Raven1911/ASIC-Oriented-RISC-V-AI-SoC-Platform/Beta_AISoC_Firmware/software_golden_model_rps/assets/hcmut_cropped.png

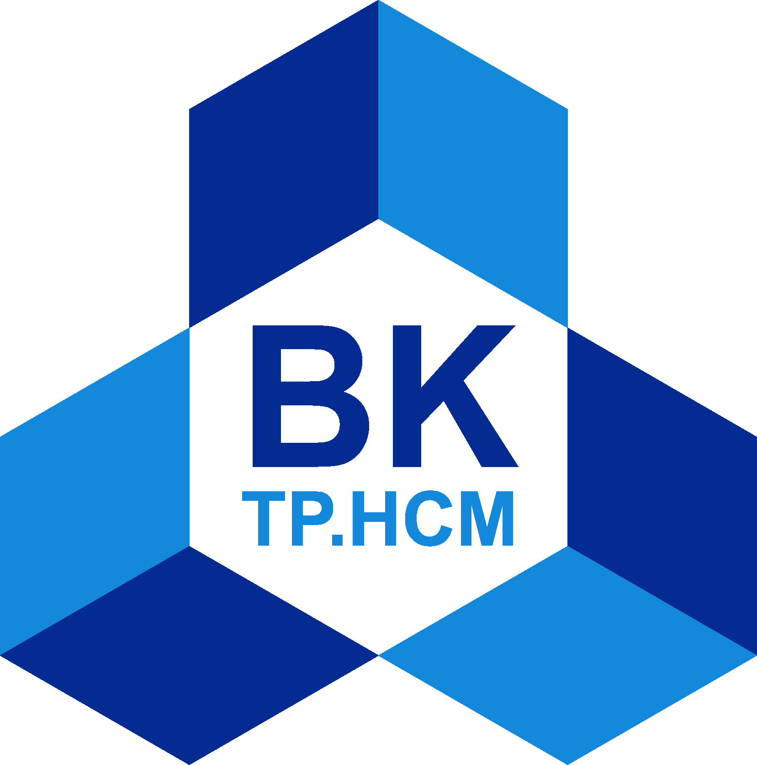
Beta_AISoC_Firmware/software_golden_model_rps/assets/hcmut_cropped.png
