Raven1911/ASIC-Oriented-RISC-V-AI-SoC-Platform/Beta_AISoC.srcs/constrs_1/imports/digilent-xdc/VC707_rev_2.0.ucf.xdc

# # set_property PACKAGE_PIN AR35 [get_ports GPIO_LED_4_LS]
# # set_property IOSTANDARD LVCMOS18 [get_ports GPIO_LED_4_LS]
# # #NET  3N787                     LOC = AY34 | IOSTANDARD=LVCMOS18; # Bank  13 VCCO - VCC1V8_FPGA - IO_L1P_T0_13
# # set_property PACKAGE_PIN BA35 [get_ports USB_SMSC_NXT]
# # set_property IOSTANDARD LVCMOS18 [get_ports USB_SMSC_NXT]
# # set_property PACKAGE_PIN AV36 [get_ports USB_SMSC_DATA0]
# # set_property IOSTANDARD LVCMOS18 [get_ports USB_SMSC_DATA0]
# # set_property PACKAGE_PIN AW36 [get_ports USB_SMSC_DATA1]
# # set_property IOSTANDARD LVCMOS18 [get_ports USB_SMSC_DATA1]
# # set_property PACKAGE_PIN BA34 [get_ports USB_SMSC_DATA2]
# # set_property IOSTANDARD LVCMOS18 [get_ports USB_SMSC_DATA2]
# # set_property PACKAGE_PIN BB34 [get_ports USB_SMSC_DATA3]
# # set_property IOSTANDARD LVCMOS18 [get_ports USB_SMSC_DATA3]
# # set_property PACKAGE_PIN BA36 [get_ports USB_SMSC_DATA4]
# # set_property IOSTANDARD LVCMOS18 [get_ports USB_SMSC_DATA4]
# # set_property PACKAGE_PIN BB36 [get_ports USB_SMSC_RESET_B]
# # set_property IOSTANDARD LVCMOS18 [get_ports USB_SMSC_RESET_B]
# # set_property PACKAGE_PIN BB32 [get_ports USB_SMSC_STP]
# # set_property IOSTANDARD LVCMOS18 [get_ports USB_SMSC_STP]
# # set_property PACKAGE_PIN BB33 [get_ports USB_SMSC_DIR]
# # set_property IOSTANDARD LVCMOS18 [get_ports USB_SMSC_DIR]
# # set_property PACKAGE_PIN AW35 [get_ports USB_SMSC_DATA7]
# # set_property IOSTANDARD LVCMOS18 [get_ports USB_SMSC_DATA7]
# # set_property PACKAGE_PIN AY35 [get_ports USB_SMSC_DATA6]
# # set_property IOSTANDARD LVCMOS18 [get_ports USB_SMSC_DATA6]
# # set_property PACKAGE_PIN AT34 [get_ports USB_SMSC_DATA5]
# # set_property IOSTANDARD LVCMOS18 [get_ports USB_SMSC_DATA5]
# # set_property PACKAGE_PIN AU34 [get_ports SI5324_INT_ALM_LS]
# # set_property IOSTANDARD LVCMOS18 [get_ports SI5324_INT_ALM_LS]
# # set_property PACKAGE_PIN AT36 [get_ports SI5324_RST_LS]
# # set_property IOSTANDARD LVCMOS18 [get_ports SI5324_RST_LS]
# # set_property PACKAGE_PIN AU36 [get_ports USB_UART_RX]
# # set_property IOSTANDARD LVCMOS18 [get_ports USB_UART_RX]
# # set_property PACKAGE_PIN AT32 [get_ports USB_UART_RTS]
# # set_property IOSTANDARD LVCMOS18 [get_ports USB_UART_RTS]
# # set_property PACKAGE_PIN AU33 [get_ports USB_UART_TX]
# # set_property IOSTANDARD LVCMOS18 [get_ports USB_UART_TX]
# # set_property PACKAGE_PIN AR34 [get_ports USB_UART_CTS]
# # set_property IOSTANDARD LVCMOS18 [get_ports USB_UART_CTS]
# # set_property PACKAGE_PIN AT35 [get_ports IIC_SCL_MAIN_LS]
# # set_property IOSTANDARD LVCMOS18 [get_ports IIC_SCL_MAIN_LS]
# # set_property PACKAGE_PIN AU32 [get_ports IIC_SDA_MAIN_LS]
# # set_property IOSTANDARD LVCMOS18 [get_ports IIC_SDA_MAIN_LS]
# # set_property PACKAGE_PIN AV33 [get_ports PCIE_WAKE_B_LS]
# # set_property IOSTANDARD LVCMOS18 [get_ports PCIE_WAKE_B_LS]
# # set_property PACKAGE_PIN AW32 [get_ports REC_CLOCK_C_P]
# # set_property IOSTANDARD LVCMOS18 [get_ports REC_CLOCK_C_P]
# # set_property PACKAGE_PIN AW33 [get_ports REC_CLOCK_C_N]
# # set_property IOSTANDARD LVCMOS18 [get_ports REC_CLOCK_C_N]
# # set_property PACKAGE_PIN AV34 [get_ports USB_SMSC_REFCLK_OPTION]
# # set_property IOSTANDARD LVCMOS18 [get_ports USB_SMSC_REFCLK_OPTION]
# # set_property PACKAGE_PIN AV35 [get_ports PCIE_PERST_LS]
# # set_property IOSTANDARD LVCMOS18 [get_ports PCIE_PERST_LS]
# # set_property PACKAGE_PIN AY32 [get_ports USB_SMSC_CLKOUT]
# # set_property IOSTANDARD LVCMOS18 [get_ports USB_SMSC_CLKOUT]

# ####################################################################################################
# ############################################ DIP SWITCHES ##########################################
# ####################################################################################################
# set_property -dict { PACKAGE_PIN AV30 IOSTANDARD LVCMOS18 } [get_ports { resetn }]; # DIP switch 0
# # set_property -dict { PACKAGE_PIN AY33 IOSTANDARD LVCMOS18 } [get_ports { pb[0] }]; # DIP switch 1
# # set_property -dict { PACKAGE_PIN BA31 IOSTANDARD LVCMOS18 } [get_ports { pb[1] }]; # DIP switch 2
# # set_property -dict { PACKAGE_PIN BA32 IOSTANDARD LVCMOS18 } [get_ports { pb[2] }]; # DIP switch 3
# # set_property -dict { PACKAGE_PIN AW30 IOSTANDARD LVCMOS18 } [get_ports { pb[3] }]; # DIP switch 4
# # set_property -dict { PACKAGE_PIN AY30 IOSTANDARD LVCMOS18 } [get_ports { pb[4] }]; # DIP switch 5
# # set_property -dict { PACKAGE_PIN BA30 IOSTANDARD LVCMOS18 } [get_ports { pb[5] }]; # DIP switch 6
# # set_property -dict { PACKAGE_PIN BB31 IOSTANDARD LVCMOS18 } [get_ports { sw_enb_i }]; # DIP switch 7

# # set_property PACKAGE_PIN AY33 [get_ports GPIO_DIP_SW1]
# # set_property IOSTANDARD LVCMOS18 [get_ports GPIO_DIP_SW1]
# # set_property PACKAGE_PIN BA31 [get_ports GPIO_DIP_SW2]
# # set_property IOSTANDARD LVCMOS18 [get_ports GPIO_DIP_SW2]
# # set_property PACKAGE_PIN BA32 [get_ports GPIO_DIP_SW3]
# # set_property IOSTANDARD LVCMOS18 [get_ports GPIO_DIP_SW3]
# # set_property PACKAGE_PIN AW30 [get_ports GPIO_DIP_SW4]
# # set_property IOSTANDARD LVCMOS18 [get_ports GPIO_DIP_SW4]
# # set_property PACKAGE_PIN AY30 [get_ports GPIO_DIP_SW5]
# # set_property IOSTANDARD LVCMOS18 [get_ports GPIO_DIP_SW5]
# # set_property PACKAGE_PIN BA30 [get_ports GPIO_DIP_SW6]
# # set_property IOSTANDARD LVCMOS18 [get_ports GPIO_DIP_SW6]
# # set_property PACKAGE_PIN BB31 [get_ports GPIO_DIP_SW7]
# # set_property IOSTANDARD LVCMOS18 [get_ports GPIO_DIP_SW7]
# # set_property PACKAGE_PIN AV30 [get_ports GPIO_DIP_SW0]
# # set_property IOSTANDARD LVCMOS18 [get_ports GPIO_DIP_SW0]

# ####################################################################################################
# ############################################              ##########################################
# ####################################################################################################

# # set_property PACKAGE_PIN AW31 [get_ports ROTARY_PUSH]
# # set_property IOSTANDARD LVCMOS18 [get_ports ROTARY_PUSH]
# # set_property PACKAGE_PIN AR30 [get_ports SDIO_DAT0_LS]
# # set_property IOSTANDARD LVCMOS18 [get_ports SDIO_DAT0_LS]
# # set_property PACKAGE_PIN AT30 [get_ports SDIO_CD_DAT3_LS]
# # set_property IOSTANDARD LVCMOS18 [get_ports SDIO_CD_DAT3_LS]
# # set_property PACKAGE_PIN AU31 [get_ports SDIO_DAT1_LS]
# # set_property IOSTANDARD LVCMOS18 [get_ports SDIO_DAT1_LS]
# # set_property PACKAGE_PIN AV31 [get_ports SDIO_DAT2_LS]
# # set_property IOSTANDARD LVCMOS18 [get_ports SDIO_DAT2_LS]
# # set_property PACKAGE_PIN AN30 [get_ports SDIO_CLK_LS]
# # set_property IOSTANDARD LVCMOS18 [get_ports SDIO_CLK_LS]
# # set_property PACKAGE_PIN AP30 [get_ports SDIO_CMD_LS]
# # set_property IOSTANDARD LVCMOS18 [get_ports SDIO_CMD_LS]
# # set_property PACKAGE_PIN AP32 [get_ports SDIO_SDDET]
# # set_property IOSTANDARD LVCMOS18 [get_ports SDIO_SDDET]
# # set_property PACKAGE_PIN AR32 [get_ports SDIO_SDWP]
# # set_property IOSTANDARD LVCMOS18 [get_ports SDIO_SDWP]
# # set_property PACKAGE_PIN AN31 [get_ports USER_SMA_GPIO_P]
# # set_property IOSTANDARD LVCMOS18 [get_ports USER_SMA_GPIO_P]
# # set_property PACKAGE_PIN AP31 [get_ports USER_SMA_GPIO_N]
# # set_property IOSTANDARD LVCMOS18 [get_ports USER_SMA_GPIO_N]
# # set_property PACKAGE_PIN AP33 [get_ports SFP_TX_DISABLE]
# # set_property IOSTANDARD LVCMOS18 [get_ports SFP_TX_DISABLE]
# # set_property PACKAGE_PIN AR33 [get_ports ROTARY_INCA]
# # set_property IOSTANDARD LVCMOS18 [get_ports ROTARY_INCA]
# # set_property PACKAGE_PIN AT31 [get_ports ROTARY_INCB]
# # set_property IOSTANDARD LVCMOS18 [get_ports ROTARY_INCB]
# # set_property PACKAGE_PIN AH35 [get_ports FMC_VADJ_ON_B_LS]
# # set_property IOSTANDARD LVCMOS18 [get_ports FMC_VADJ_ON_B_LS]
# # set_property PACKAGE_PIN AM36 [get_ports FLASH_D0]
# # set_property IOSTANDARD LVCMOS18 [get_ports FLASH_D0]
# # set_property PACKAGE_PIN AN36 [get_ports FLASH_D1]
# # set_property IOSTANDARD LVCMOS18 [get_ports FLASH_D1]
# # set_property PACKAGE_PIN AJ36 [get_ports FLASH_D2]
# # set_property IOSTANDARD LVCMOS18 [get_ports FLASH_D2]
# # set_property PACKAGE_PIN AJ37 [get_ports FLASH_D3]
# # set_property IOSTANDARD LVCMOS18 [get_ports FLASH_D3]
# # #NET  4N749                     LOC = AP36 | IOSTANDARD=LVCMOS18; # Bank  14 VCCO - VCC1V8_FPGA - IO_L3P_T0_DQS_PUDC_B_14
# # set_property PACKAGE_PIN AP37 [get_ports FPGA_EMCCLK]
# # set_property IOSTANDARD LVCMOS18 [get_ports FPGA_EMCCLK]
# # set_property PACKAGE_PIN AK37 [get_ports FLASH_D4]
# # set_property IOSTANDARD LVCMOS18 [get_ports FLASH_D4]
# # set_property PACKAGE_PIN AL37 [get_ports FLASH_D5]
# # set_property IOSTANDARD LVCMOS18 [get_ports FLASH_D5]
# # set_property PACKAGE_PIN AN35 [get_ports FLASH_D6]
# # set_property IOSTANDARD LVCMOS18 [get_ports FLASH_D6]
# # set_property PACKAGE_PIN AP35 [get_ports FLASH_D7]
# # set_property IOSTANDARD LVCMOS18 [get_ports FLASH_D7]
# # set_property PACKAGE_PIN AL36 [get_ports FLASH_CE_B]
# # set_property IOSTANDARD LVCMOS18 [get_ports FLASH_CE_B]
# # set_property PACKAGE_PIN AM37 [get_ports FLASH_D8]
# # set_property IOSTANDARD LVCMOS18 [get_ports FLASH_D8]
# # set_property PACKAGE_PIN AG33 [get_ports FLASH_D9]
# # set_property IOSTANDARD LVCMOS18 [get_ports FLASH_D9]
# # set_property PACKAGE_PIN AH33 [get_ports FLASH_D10]
# # set_property IOSTANDARD LVCMOS18 [get_ports FLASH_D10]
# # set_property PACKAGE_PIN AK35 [get_ports FLASH_D11]
# # set_property IOSTANDARD LVCMOS18 [get_ports FLASH_D11]
# # set_property PACKAGE_PIN AL35 [get_ports FLASH_D12]
# # set_property IOSTANDARD LVCMOS18 [get_ports FLASH_D12]
# # set_property PACKAGE_PIN AH31 [get_ports PHY_MDC_LS]
# # set_property IOSTANDARD LVCMOS18 [get_ports PHY_MDC_LS]
# # set_property PACKAGE_PIN AJ31 [get_ports FLASH_D13]
# # set_property IOSTANDARD LVCMOS18 [get_ports FLASH_D13]
# # set_property PACKAGE_PIN AH34 [get_ports FLASH_D14]
# # set_property IOSTANDARD LVCMOS18 [get_ports FLASH_D14]
# # set_property PACKAGE_PIN AJ35 [get_ports FLASH_D15]
# # set_property IOSTANDARD LVCMOS18 [get_ports FLASH_D15]
# # set_property PACKAGE_PIN AJ33 [get_ports PHY_RESET_LS]
# # set_property IOSTANDARD LVCMOS18 [get_ports PHY_RESET_LS]
# # set_property PACKAGE_PIN AK33 [get_ports PHY_MDIO_LS]
# # set_property IOSTANDARD LVCMOS18 [get_ports PHY_MDIO_LS]
# # set_property PACKAGE_PIN AK34 [get_ports USER_CLOCK_P]
# # set_property IOSTANDARD LVDS [get_ports USER_CLOCK_P]
# # set_property PACKAGE_PIN AL34 [get_ports USER_CLOCK_N]
# # set_property IOSTANDARD LVDS [get_ports USER_CLOCK_N]
# # set_property PACKAGE_PIN AJ32 [get_ports USER_SMA_CLOCK_P]
# # set_property IOSTANDARD LVCMOS18 [get_ports USER_SMA_CLOCK_P]
# # set_property PACKAGE_PIN AK32 [get_ports USER_SMA_CLOCK_N]
# # set_property IOSTANDARD LVCMOS18 [get_ports USER_SMA_CLOCK_N]
# # set_property PACKAGE_PIN AL31 [get_ports PHY_INT_LS]
# # set_property IOSTANDARD LVCMOS18 [get_ports PHY_INT_LS]
# # set_property PACKAGE_PIN AL32 [get_ports FMC_C2M_PG_LS]
# # set_property IOSTANDARD LVCMOS18 [get_ports FMC_C2M_PG_LS]
# # set_property PACKAGE_PIN AM34 [get_ports FLASH_WAIT]
# # set_property IOSTANDARD LVCMOS18 [get_ports FLASH_WAIT]
# # set_property PACKAGE_PIN AN34 [get_ports FMC1_HPC_PG_M2C_LS]
# # set_property IOSTANDARD LVCMOS18 [get_ports FMC1_HPC_PG_M2C_LS]
# # set_property PACKAGE_PIN AM31 [get_ports FMC1_HPC_PRSNT_M2C_B_LS]
# # set_property IOSTANDARD LVCMOS18 [get_ports FMC1_HPC_PRSNT_M2C_B_LS]
# # set_property PACKAGE_PIN AM32 [get_ports FLASH_A15]
# # set_property IOSTANDARD LVCMOS18 [get_ports FLASH_A15]
# # set_property PACKAGE_PIN AM33 [get_ports FLASH_A14]
# # set_property IOSTANDARD LVCMOS18 [get_ports FLASH_A14]
# # set_property PACKAGE_PIN AN33 [get_ports FLASH_A13]
# # set_property IOSTANDARD LVCMOS18 [get_ports FLASH_A13]
# # set_property PACKAGE_PIN AL29 [get_ports FLASH_A12]
# # set_property IOSTANDARD LVCMOS18 [get_ports FLASH_A12]
# # set_property PACKAGE_PIN AL30 [get_ports FLASH_A11]
# # set_property IOSTANDARD LVCMOS18 [get_ports FLASH_A11]
# # set_property PACKAGE_PIN AH29 [get_ports FLASH_A10]
# # set_property IOSTANDARD LVCMOS18 [get_ports FLASH_A10]
# # set_property PACKAGE_PIN AH30 [get_ports FLASH_A9]
# # set_property IOSTANDARD LVCMOS18 [get_ports FLASH_A9]
# # set_property PACKAGE_PIN AJ30 [get_ports FLASH_A8]
# # set_property IOSTANDARD LVCMOS18 [get_ports FLASH_A8]
# # set_property PACKAGE_PIN AK30 [get_ports FLASH_A7]
# # set_property IOSTANDARD LVCMOS18 [get_ports FLASH_A7]
# # set_property PACKAGE_PIN AF29 [get_ports FMC2_HPC_PG_M2C_LS]
# # set_property IOSTANDARD LVCMOS18 [get_ports FMC2_HPC_PG_M2C_LS]
# # set_property PACKAGE_PIN AG29 [get_ports FLASH_A6]
# # set_property IOSTANDARD LVCMOS18 [get_ports FLASH_A6]
# # set_property PACKAGE_PIN AK28 [get_ports FLASH_A5]
# # set_property IOSTANDARD LVCMOS18 [get_ports FLASH_A5]
# # set_property PACKAGE_PIN AK29 [get_ports FLASH_A4]
# # set_property IOSTANDARD LVCMOS18 [get_ports FLASH_A4]
# # set_property PACKAGE_PIN AF30 [get_ports FLASH_A3]
# # set_property IOSTANDARD LVCMOS18 [get_ports FLASH_A3]
# # set_property PACKAGE_PIN AG31 [get_ports FLASH_A2]
# # set_property IOSTANDARD LVCMOS18 [get_ports FLASH_A2]
# # set_property PACKAGE_PIN AH28 [get_ports FLASH_A1]
# # set_property IOSTANDARD LVCMOS18 [get_ports FLASH_A1]
# # set_property PACKAGE_PIN AJ28 [get_ports FLASH_A0]
# # set_property IOSTANDARD LVCMOS18 [get_ports FLASH_A0]
# # set_property PACKAGE_PIN AG32 [get_ports FMC2_HPC_PRSNT_M2C_B_LS]
# # set_property IOSTANDARD LVCMOS18 [get_ports FMC2_HPC_PRSNT_M2C_B_LS]
# # #NET  VRN_15                    LOC = AM38 | IOSTANDARD=LVCMOS18; # Bank  15 VCCO - VCC1V8_FPGA - IO_0_VRN_15
# # set_property PACKAGE_PIN AN38 [get_ports XADC_VAUX0P_R]
# # set_property IOSTANDARD LVCMOS18 [get_ports XADC_VAUX0P_R]
# # set_property PACKAGE_PIN AP38 [get_ports XADC_VAUX0N_R]
# # set_property IOSTANDARD LVCMOS18 [get_ports XADC_VAUX0N_R]
# # set_property PACKAGE_PIN AM41 [get_ports XADC_VAUX8P_R]
# # set_property IOSTANDARD LVCMOS18 [get_ports XADC_VAUX8P_R]
# # set_property PACKAGE_PIN AM42 [get_ports XADC_VAUX8N_R]
# # set_property IOSTANDARD LVCMOS18 [get_ports XADC_VAUX8N_R]
# # set_property PACKAGE_PIN AR38 [get_ports LCD_DB5_LS]
# # set_property IOSTANDARD LVCMOS18 [get_ports LCD_DB5_LS]
# # set_property PACKAGE_PIN AR39 [get_ports LCD_DB6_LS]
# # set_property IOSTANDARD LVCMOS18 [get_ports LCD_DB6_LS]
# # set_property PACKAGE_PIN AN40 [get_ports LCD_DB7_LS]
# # set_property IOSTANDARD LVCMOS18 [get_ports LCD_DB7_LS]
# # set_property PACKAGE_PIN AN41 [get_ports LCD_RS_LS]
# # set_property IOSTANDARD LVCMOS18 [get_ports LCD_RS_LS]

# #######################################################################################################
# ############################################ LEDS & SWITCHES ##########################################
# #######################################################################################################

# set_property -dict { PACKAGE_PIN AM39 IOSTANDARD LVCMOS18 } [get_ports { trap0 }]; # LED 0
# set_property -dict { PACKAGE_PIN AN39 IOSTANDARD LVCMOS18 } [get_ports { trap1 }]; # LED 1
# # set_property -dict { PACKAGE_PIN AR37 IOSTANDARD LVCMOS18 } [get_ports { adv7511_clk }]; # LED 2
# # set_property -dict { PACKAGE_PIN AT37 IOSTANDARD LVCMOS18 } [get_ports { adv7511_de }]; # LED 3
# # set_property -dict { PACKAGE_PIN AP41 IOSTANDARD LVCMOS18 } [get_ports { GPIO_LED_5_LS }]; # LED 5
# # set_property -dict { PACKAGE_PIN AP42 IOSTANDARD LVCMOS18 } [get_ports { READY }]; # LED 6
# # set_property -dict { PACKAGE_PIN AP40 IOSTANDARD LVCMOS18 } [get_ports { GPIO_SW_S }];     # Push Switch South
# # set_property -dict { PACKAGE_PIN AR40 IOSTANDARD LVCMOS18 } [get_ports { GPIO_SW_N }];     # Push Switch North

# # set_property PACKAGE_PIN AR37 [get_ports GPIO_LED_2_LS]
# # set_property IOSTANDARD LVCMOS18 [get_ports GPIO_LED_2_LS]
# # set_property PACKAGE_PIN AT37 [get_ports GPIO_LED_3_LS]
# # set_property IOSTANDARD LVCMOS18 [get_ports GPIO_LED_3_LS]
# # set_property PACKAGE_PIN AM39 [get_ports GPIO_LED_0_LS]
# # set_property IOSTANDARD LVCMOS18 [get_ports GPIO_LED_0_LS]
# # set_property PACKAGE_PIN AN39 [get_ports GPIO_LED_1_LS]
# # set_property IOSTANDARD LVCMOS18 [get_ports GPIO_LED_1_LS]
# # set_property PACKAGE_PIN AP40 [get_ports GPIO_SW_S]
# # set_property IOSTANDARD LVCMOS18 [get_ports GPIO_SW_S]
# # set_property PACKAGE_PIN AR40 [get_ports GPIO_SW_N]
# # set_property IOSTANDARD LVCMOS18 [get_ports GPIO_SW_N]
# # set_property PACKAGE_PIN AP41 [get_ports GPIO_LED_5_LS]
# # set_property IOSTANDARD LVCMOS18 [get_ports GPIO_LED_5_LS]
# # set_property PACKAGE_PIN AP42 [get_ports GPIO_LED_6_LS]
# # set_property IOSTANDARD LVCMOS18 [get_ports GPIO_LED_6_LS]

# #######################################################################################################
# ############################################ ##########################################################
# #######################################################################################################


# # #NET  4N920                     LOC = AT39 | IOSTANDARD=LVCMOS18; # Bank  15 VCCO - VCC1V8_FPGA - IO_L9P_T1_DQS_AD3P_15
# # set_property PACKAGE_PIN AT40 [get_ports LCD_E_LS]
# # set_property IOSTANDARD LVCMOS18 [get_ports LCD_E_LS]
# # set_property PACKAGE_PIN AR42 [get_ports LCD_RW_LS]
# # set_property IOSTANDARD LVCMOS18 [get_ports LCD_RW_LS]
# # set_property PACKAGE_PIN AT42 [get_ports LCD_DB4_LS]
# # set_property IOSTANDARD LVCMOS18 [get_ports LCD_DB4_LS]
# # set_property PACKAGE_PIN AU39 [get_ports GPIO_LED_7_LS]
# # set_property IOSTANDARD LVCMOS18 [get_ports GPIO_LED_7_LS]
# # set_property PACKAGE_PIN AV39 [get_ports GPIO_SW_C]
# # set_property IOSTANDARD LVCMOS18 [get_ports GPIO_SW_C]
# # set_property PACKAGE_PIN AU38 [get_ports GPIO_SW_E]
# # set_property IOSTANDARD LVCMOS18 [get_ports GPIO_SW_E]
# # set_property PACKAGE_PIN AV38 [get_ports PMBUS_ALERT_LS]
# # set_property IOSTANDARD LVCMOS18 [get_ports PMBUS_ALERT_LS]
# # set_property PACKAGE_PIN AV40 [get_ports CPU_RESET]
# # set_property IOSTANDARD LVCMOS18 [get_ports CPU_RESET]
# # set_property PACKAGE_PIN AW40 [get_ports GPIO_SW_W]
# # set_property IOSTANDARD LVCMOS18 [get_ports GPIO_SW_W]
# # set_property PACKAGE_PIN AY39 [get_ports PMBUS_DATA_LS]
# # set_property IOSTANDARD LVCMOS18 [get_ports PMBUS_DATA_LS]
# # #NET  4N923                     LOC = AY40 | IOSTANDARD=LVCMOS18; # Bank  15 VCCO - VCC1V8_FPGA - IO_L14N_T2_SRCC_15
# # set_property PACKAGE_PIN AW37 [get_ports PMBUS_CLK_LS]
# # set_property IOSTANDARD LVCMOS18 [get_ports PMBUS_CLK_LS]
# # set_property PACKAGE_PIN AY37 [get_ports FLASH_ADV_B]
# # set_property IOSTANDARD LVCMOS18 [get_ports FLASH_ADV_B]
# # set_property PACKAGE_PIN BA37 [get_ports SM_FAN_PWM]
# # set_property IOSTANDARD LVCMOS18 [get_ports SM_FAN_PWM]
# # set_property PACKAGE_PIN BB37 [get_ports SM_FAN_TACH]
# # set_property IOSTANDARD LVCMOS18 [get_ports SM_FAN_TACH]
# # #NET  4N917                     LOC = AW38 | IOSTANDARD=LVCMOS18; # Bank  15 VCCO - VCC1V8_FPGA - IO_L17P_T2_A26_15
# # #NET  4N916                     LOC = AY38 | IOSTANDARD=LVCMOS18; # Bank  15 VCCO - VCC1V8_FPGA - IO_L17N_T2_A25_15
# # set_property PACKAGE_PIN BB38 [get_ports SFP_LOS_LS]
# # set_property IOSTANDARD LVCMOS18 [get_ports SFP_LOS_LS]
# # set_property PACKAGE_PIN BB39 [get_ports FLASH_A23]
# # set_property IOSTANDARD LVCMOS18 [get_ports FLASH_A23]
# # set_property PACKAGE_PIN BA39 [get_ports FLASH_A22]
# # set_property IOSTANDARD LVCMOS18 [get_ports FLASH_A22]
# # set_property PACKAGE_PIN BA40 [get_ports FLASH_A21]
# # set_property IOSTANDARD LVCMOS18 [get_ports FLASH_A21]
# # set_property PACKAGE_PIN AT41 [get_ports FLASH_A20]
# # set_property IOSTANDARD LVCMOS18 [get_ports FLASH_A20]
# # set_property PACKAGE_PIN AU42 [get_ports FLASH_A19]
# # set_property IOSTANDARD LVCMOS18 [get_ports FLASH_A19]
# # set_property PACKAGE_PIN AY42 [get_ports IIC_MUX_RESET_B_LS]
# # set_property IOSTANDARD LVCMOS18 [get_ports IIC_MUX_RESET_B_LS]
# # set_property PACKAGE_PIN BA42 [get_ports FLASH_A18]
# # set_property IOSTANDARD LVCMOS18 [get_ports FLASH_A18]
# # set_property PACKAGE_PIN AU41 [get_ports FLASH_A17]
# # set_property IOSTANDARD LVCMOS18 [get_ports FLASH_A17]
# # set_property PACKAGE_PIN AV41 [get_ports FLASH_A16]
# # set_property IOSTANDARD LVCMOS18 [get_ports FLASH_A16]
# # set_property PACKAGE_PIN BA41 [get_ports FLASH_OE_B]
# # set_property IOSTANDARD LVCMOS18 [get_ports FLASH_OE_B]
# # set_property PACKAGE_PIN BB41 [get_ports FLASH_FWE_B]
# # set_property IOSTANDARD LVCMOS18 [get_ports FLASH_FWE_B]
# # set_property PACKAGE_PIN AW41 [get_ports FLASH_A25]
# # set_property IOSTANDARD LVCMOS18 [get_ports FLASH_A25]
# # set_property PACKAGE_PIN AW42 [get_ports FLASH_A24]
# # set_property IOSTANDARD LVCMOS18 [get_ports FLASH_A24]
# # #NET  VRP_15                    LOC = AU37 | IOSTANDARD=LVCMOS18; # Bank  15 VCCO - VCC1V8_FPGA - IO_25_VRP_15
# # #NET  5N825                     LOC = Y34  | IOSTANDARD=LVCMOS18; # Bank  16 VCCO - VADJ_FPGA - IO_0_VRN_16

# ##############################################################
# ############################ FMC2 ############################
# ##############################################################
# # set_property PACKAGE_PIN AF35 [get_ports FMC2_HPC_HA14_P]
# # set_property IOSTANDARD LVCMOS18 [get_ports FMC2_HPC_HA14_P]
# # set_property PACKAGE_PIN AF36 [get_ports FMC2_HPC_HA14_N]
# # set_property IOSTANDARD LVCMOS18 [get_ports FMC2_HPC_HA14_N]
# # set_property PACKAGE_PIN AE37 [get_ports FMC2_HPC_HA15_P]
# # set_property IOSTANDARD LVCMOS18 [get_ports FMC2_HPC_HA15_P]
# # set_property PACKAGE_PIN AF37 [get_ports FMC2_HPC_HA15_N]
# # set_property IOSTANDARD LVCMOS18 [get_ports FMC2_HPC_HA15_N]
# # set_property PACKAGE_PIN AF34 [get_ports FMC2_HPC_HA12_P]
# # set_property IOSTANDARD LVCMOS18 [get_ports FMC2_HPC_HA12_P]
# # set_property PACKAGE_PIN AG34 [get_ports FMC2_HPC_HA12_N]
# # set_property IOSTANDARD LVCMOS18 [get_ports FMC2_HPC_HA12_N]
# # set_property PACKAGE_PIN AD36 [get_ports FMC2_HPC_HA20_P]
# # set_property IOSTANDARD LVCMOS18 [get_ports FMC2_HPC_HA20_P]
# # set_property PACKAGE_PIN AD37 [get_ports FMC2_HPC_HA20_N]
# # set_property IOSTANDARD LVCMOS18 [get_ports FMC2_HPC_HA20_N]
# # set_property PACKAGE_PIN AC35 [get_ports FMC2_HPC_HA19_P]
# # set_property IOSTANDARD LVCMOS18 [get_ports FMC2_HPC_HA19_P]
# # set_property PACKAGE_PIN AC36 [get_ports FMC2_HPC_HA19_N]
# # set_property IOSTANDARD LVCMOS18 [get_ports FMC2_HPC_HA19_N]
# # set_property PACKAGE_PIN AG36 [get_ports FMC2_HPC_HA16_P]
# # set_property IOSTANDARD LVCMOS18 [get_ports FMC2_HPC_HA16_P]
# # set_property PACKAGE_PIN AH36 [get_ports FMC2_HPC_HA16_N]
# # set_property IOSTANDARD LVCMOS18 [get_ports FMC2_HPC_HA16_N]
# # set_property PACKAGE_PIN Y37 [get_ports FMC2_HPC_HA23_P]
# # set_property IOSTANDARD LVCMOS18 [get_ports FMC2_HPC_HA23_P]
# # set_property PACKAGE_PIN AA37 [get_ports FMC2_HPC_HA23_N]
# # set_property IOSTANDARD LVCMOS18 [get_ports FMC2_HPC_HA23_N]
# # set_property PACKAGE_PIN Y35 [get_ports FMC2_HPC_HA22_P]
# # set_property IOSTANDARD LVCMOS18 [get_ports FMC2_HPC_HA22_P]
# # set_property PACKAGE_PIN AA36 [get_ports FMC2_HPC_HA22_N]
# # set_property IOSTANDARD LVCMOS18 [get_ports FMC2_HPC_HA22_N]
# # set_property PACKAGE_PIN AB36 [get_ports FMC2_HPC_HA18_P]
# # set_property IOSTANDARD LVCMOS18 [get_ports FMC2_HPC_HA18_P]
# # set_property PACKAGE_PIN AB37 [get_ports FMC2_HPC_HA18_N]
# # set_property IOSTANDARD LVCMOS18 [get_ports FMC2_HPC_HA18_N]
# # set_property PACKAGE_PIN AA34 [get_ports FMC2_HPC_HA21_P]
# # set_property IOSTANDARD LVCMOS18 [get_ports FMC2_HPC_HA21_P]
# # set_property PACKAGE_PIN AA35 [get_ports FMC2_HPC_HA21_N]
# # set_property IOSTANDARD LVCMOS18 [get_ports FMC2_HPC_HA21_N]
# # set_property PACKAGE_PIN AB31 [get_ports FMC2_HPC_HA06_P]
# # set_property IOSTANDARD LVCMOS18 [get_ports FMC2_HPC_HA06_P]
# # set_property PACKAGE_PIN AB32 [get_ports FMC2_HPC_HA06_N]
# # set_property IOSTANDARD LVCMOS18 [get_ports FMC2_HPC_HA06_N]
# # set_property PACKAGE_PIN AB33 [get_ports FMC2_HPC_HA00_CC_P]
# # set_property IOSTANDARD LVCMOS18 [get_ports FMC2_HPC_HA00_CC_P]
# # set_property PACKAGE_PIN AC33 [get_ports FMC2_HPC_HA00_CC_N]
# # set_property IOSTANDARD LVCMOS18 [get_ports FMC2_HPC_HA00_CC_N]
# # set_property PACKAGE_PIN AD32 [get_ports FMC2_HPC_HA01_CC_P]
# # set_property IOSTANDARD LVCMOS18 [get_ports FMC2_HPC_HA01_CC_P]
# # set_property PACKAGE_PIN AD33 [get_ports FMC2_HPC_HA01_CC_N]
# # set_property IOSTANDARD LVCMOS18 [get_ports FMC2_HPC_HA01_CC_N]
# # set_property PACKAGE_PIN AC34 [get_ports FMC2_HPC_HA17_CC_P]
# # set_property IOSTANDARD LVCMOS18 [get_ports FMC2_HPC_HA17_CC_P]
# # set_property PACKAGE_PIN AD35 [get_ports FMC2_HPC_HA17_CC_N]
# # set_property IOSTANDARD LVCMOS18 [get_ports FMC2_HPC_HA17_CC_N]
# # set_property PACKAGE_PIN AE32 [get_ports FMC2_HPC_HA13_P]
# # set_property IOSTANDARD LVCMOS18 [get_ports FMC2_HPC_HA13_P]
# # set_property PACKAGE_PIN AE33 [get_ports FMC2_HPC_HA13_N]
# # set_property IOSTANDARD LVCMOS18 [get_ports FMC2_HPC_HA13_N]
# # set_property PACKAGE_PIN AF31 [get_ports FMC2_HPC_HA10_P]
# # set_property IOSTANDARD LVCMOS18 [get_ports FMC2_HPC_HA10_P]
# # set_property PACKAGE_PIN AF32 [get_ports FMC2_HPC_HA10_N]
# # set_property IOSTANDARD LVCMOS18 [get_ports FMC2_HPC_HA10_N]
# # set_property PACKAGE_PIN AE34 [get_ports FMC2_HPC_HA11_P]
# # set_property IOSTANDARD LVCMOS18 [get_ports FMC2_HPC_HA11_P]
# # set_property PACKAGE_PIN AE35 [get_ports FMC2_HPC_HA11_N]
# # set_property IOSTANDARD LVCMOS18 [get_ports FMC2_HPC_HA11_N]
# # set_property PACKAGE_PIN AE29 [get_ports FMC2_HPC_HA09_P]
# # set_property IOSTANDARD LVCMOS18 [get_ports FMC2_HPC_HA09_P]
# # set_property PACKAGE_PIN AE30 [get_ports FMC2_HPC_HA09_N]
# # set_property IOSTANDARD LVCMOS18 [get_ports FMC2_HPC_HA09_N]
# # set_property PACKAGE_PIN Y32 [get_ports FMC2_HPC_HA05_P]
# # set_property IOSTANDARD LVCMOS18 [get_ports FMC2_HPC_HA05_P]
# # set_property PACKAGE_PIN Y33 [get_ports FMC2_HPC_HA05_N]
# # set_property IOSTANDARD LVCMOS18 [get_ports FMC2_HPC_HA05_N]
# # set_property PACKAGE_PIN AC31 [get_ports FMC2_HPC_HA07_P]
# # set_property IOSTANDARD LVCMOS18 [get_ports FMC2_HPC_HA07_P]
# # set_property PACKAGE_PIN AD31 [get_ports FMC2_HPC_HA07_N]
# # set_property IOSTANDARD LVCMOS18 [get_ports FMC2_HPC_HA07_N]
# # set_property PACKAGE_PIN AA31 [get_ports FMC2_HPC_HA08_P]
# # set_property IOSTANDARD LVCMOS18 [get_ports FMC2_HPC_HA08_P]
# # set_property PACKAGE_PIN AA32 [get_ports FMC2_HPC_HA08_N]
# # set_property IOSTANDARD LVCMOS18 [get_ports FMC2_HPC_HA08_N]
# # set_property PACKAGE_PIN AC30 [get_ports FMC2_HPC_HA02_P]
# # set_property IOSTANDARD LVCMOS18 [get_ports FMC2_HPC_HA02_P]
# # set_property PACKAGE_PIN AD30 [get_ports FMC2_HPC_HA02_N]
# # set_property IOSTANDARD LVCMOS18 [get_ports FMC2_HPC_HA02_N]
# # set_property PACKAGE_PIN AA29 [get_ports FMC2_HPC_HA03_P]
# # set_property IOSTANDARD LVCMOS18 [get_ports FMC2_HPC_HA03_P]
# # set_property PACKAGE_PIN AA30 [get_ports FMC2_HPC_HA03_N]
# # set_property IOSTANDARD LVCMOS18 [get_ports FMC2_HPC_HA03_N]
# # set_property PACKAGE_PIN AB29 [get_ports FMC2_HPC_HA04_P]
# # set_property IOSTANDARD LVCMOS18 [get_ports FMC2_HPC_HA04_P]
# # set_property PACKAGE_PIN AC29 [get_ports FMC2_HPC_HA04_N]
# # set_property IOSTANDARD LVCMOS18 [get_ports FMC2_HPC_HA04_N]
# # #NET  5N826                     LOC = AB34 | IOSTANDARD=LVCMOS18; # Bank  16 VCCO - VADJ_FPGA - IO_25_VRP_16
# # #NET  5N830                     LOC = Y38  | IOSTANDARD=LVCMOS18; # Bank  17 VCCO - VADJ_FPGA - IO_0_VRN_17
# # set_property PACKAGE_PIN AB41 [get_ports FMC2_HPC_LA10_P]
# # set_property IOSTANDARD LVCMOS18 [get_ports FMC2_HPC_LA10_P]
# # set_property PACKAGE_PIN AB42 [get_ports FMC2_HPC_LA10_N]
# # set_property IOSTANDARD LVCMOS18 [get_ports FMC2_HPC_LA10_N]
# # set_property PACKAGE_PIN W40 [get_ports FMC2_HPC_LA13_P]
# # set_property IOSTANDARD LVCMOS18 [get_ports FMC2_HPC_LA13_P]
# # set_property PACKAGE_PIN Y40 [get_ports FMC2_HPC_LA13_N]
# # set_property IOSTANDARD LVCMOS18 [get_ports FMC2_HPC_LA13_N]
# # set_property PACKAGE_PIN Y39 [get_ports FMC2_HPC_LA12_P]
# # set_property IOSTANDARD LVCMOS18 [get_ports FMC2_HPC_LA12_P]
# # set_property PACKAGE_PIN AA39 [get_ports FMC2_HPC_LA12_N]
# # set_property IOSTANDARD LVCMOS18 [get_ports FMC2_HPC_LA12_N]
# # set_property PACKAGE_PIN Y42 [get_ports FMC2_HPC_LA11_P]
# # set_property IOSTANDARD LVCMOS18 [get_ports FMC2_HPC_LA11_P]
# # set_property PACKAGE_PIN AA42 [get_ports FMC2_HPC_LA11_N]
# # set_property IOSTANDARD LVCMOS18 [get_ports FMC2_HPC_LA11_N]
# # set_property PACKAGE_PIN AB38 [get_ports FMC2_HPC_LA14_P]
# # set_property IOSTANDARD LVCMOS18 [get_ports FMC2_HPC_LA14_P]
# # set_property PACKAGE_PIN AB39 [get_ports FMC2_HPC_LA14_N]
# # set_property IOSTANDARD LVCMOS18 [get_ports FMC2_HPC_LA14_N]
# # #NET  5N961                     LOC = AA40 | IOSTANDARD=LVCMOS18; # Bank  17 VCCO - VADJ_FPGA - IO_L6P_T0_17
# # #NET  5N962                     LOC = AA41 | IOSTANDARD=LVCMOS18; # Bank  17 VCCO - VADJ_FPGA - IO_L6N_T0_VREF_17
# # set_property PACKAGE_PIN AC38 [get_ports FMC2_HPC_LA15_P]
# # set_property IOSTANDARD LVCMOS18 [get_ports FMC2_HPC_LA15_P]
# # set_property PACKAGE_PIN AC39 [get_ports FMC2_HPC_LA15_N]
# # set_property IOSTANDARD LVCMOS18 [get_ports FMC2_HPC_LA15_N]
# # set_property PACKAGE_PIN AD42 [get_ports FMC2_HPC_LA08_P]
# # set_property IOSTANDARD LVCMOS18 [get_ports FMC2_HPC_LA08_P]
# # set_property PACKAGE_PIN AE42 [get_ports FMC2_HPC_LA08_N]
# # set_property IOSTANDARD LVCMOS18 [get_ports FMC2_HPC_LA08_N]
# # set_property PACKAGE_PIN AD38 [get_ports FMC2_HPC_LA06_P]
# # set_property IOSTANDARD LVCMOS18 [get_ports FMC2_HPC_LA06_P]
# # set_property PACKAGE_PIN AE38 [get_ports FMC2_HPC_LA06_N]
# # set_property IOSTANDARD LVCMOS18 [get_ports FMC2_HPC_LA06_N]
# # set_property PACKAGE_PIN AC40 [get_ports FMC2_HPC_LA07_P]
# # set_property IOSTANDARD LVCMOS18 [get_ports FMC2_HPC_LA07_P]
# # set_property PACKAGE_PIN AC41 [get_ports FMC2_HPC_LA07_N]
# # set_property IOSTANDARD LVCMOS18 [get_ports FMC2_HPC_LA07_N]
# # #NET  5N964                     LOC = AE39 | IOSTANDARD=LVCMOS18; # Bank  17 VCCO - VADJ_FPGA - IO_L11P_T1_SRCC_17
# # #NET  5N963                     LOC = AE40 | IOSTANDARD=LVCMOS18; # Bank  17 VCCO - VADJ_FPGA - IO_L11N_T1_SRCC_17
# # set_property PACKAGE_PIN AD40 [get_ports FMC2_HPC_LA00_CC_P]
# # set_property IOSTANDARD LVCMOS18 [get_ports FMC2_HPC_LA00_CC_P]
# # set_property PACKAGE_PIN AD41 [get_ports FMC2_HPC_LA00_CC_N]
# # set_property IOSTANDARD LVCMOS18 [get_ports FMC2_HPC_LA00_CC_N]
# # set_property PACKAGE_PIN AF39 [get_ports FMC2_HPC_CLK0_M2C_P]
# # set_property IOSTANDARD LVCMOS18 [get_ports FMC2_HPC_CLK0_M2C_P]
# # set_property PACKAGE_PIN AF40 [get_ports FMC2_HPC_CLK0_M2C_N]
# # set_property IOSTANDARD LVCMOS18 [get_ports FMC2_HPC_CLK0_M2C_N]
# # set_property PACKAGE_PIN AF41 [get_ports FMC2_HPC_LA01_CC_P]
# # set_property IOSTANDARD LVCMOS18 [get_ports FMC2_HPC_LA01_CC_P]
# # set_property PACKAGE_PIN AG41 [get_ports FMC2_HPC_LA01_CC_N]
# # set_property IOSTANDARD LVCMOS18 [get_ports FMC2_HPC_LA01_CC_N]
# # #NET  5N959                     LOC = AG39 | IOSTANDARD=LVCMOS18; # Bank  17 VCCO - VADJ_FPGA - IO_L15P_T2_DQS_17
# # #NET  5N960                     LOC = AH39 | IOSTANDARD=LVCMOS18; # Bank  17 VCCO - VADJ_FPGA - IO_L15N_T2_DQS_17
# # set_property PACKAGE_PIN AF42 [get_ports FMC2_HPC_LA05_P]
# # set_property IOSTANDARD LVCMOS18 [get_ports FMC2_HPC_LA05_P]
# # set_property PACKAGE_PIN AG42 [get_ports FMC2_HPC_LA05_N]
# # set_property IOSTANDARD LVCMOS18 [get_ports FMC2_HPC_LA05_N]
# # #NET  5N957                     LOC = AG38 | IOSTANDARD=LVCMOS18; # Bank  17 VCCO - VADJ_FPGA - IO_L17P_T2_17
# # #NET  5N958                     LOC = AH38 | IOSTANDARD=LVCMOS18; # Bank  17 VCCO - VADJ_FPGA - IO_L17N_T2_17
# # set_property PACKAGE_PIN AJ38 [get_ports FMC2_HPC_LA09_P]
# # set_property IOSTANDARD LVCMOS18 [get_ports FMC2_HPC_LA09_P]
# # set_property PACKAGE_PIN AK38 [get_ports FMC2_HPC_LA09_N]
# # set_property IOSTANDARD LVCMOS18 [get_ports FMC2_HPC_LA09_N]
# # #NET  5N953                     LOC = AK40 | IOSTANDARD=LVCMOS18; # Bank  17 VCCO - VADJ_FPGA - IO_L19P_T3_17
# # #NET  5N954                     LOC = AL40 | IOSTANDARD=LVCMOS18; # Bank  17 VCCO - VADJ_FPGA - IO_L19N_T3_VREF_17
# # #NET  5N955                     LOC = AH40 | IOSTANDARD=LVCMOS18; # Bank  17 VCCO - VADJ_FPGA - IO_L20P_T3_17
# # #NET  5N956                     LOC = AH41 | IOSTANDARD=LVCMOS18; # Bank  17 VCCO - VADJ_FPGA - IO_L20N_T3_17
# # set_property PACKAGE_PIN AL41 [get_ports FMC2_HPC_LA04_P]
# # set_property IOSTANDARD LVCMOS18 [get_ports FMC2_HPC_LA04_P]
# # set_property PACKAGE_PIN AL42 [get_ports FMC2_HPC_LA04_N]
# # set_property IOSTANDARD LVCMOS18 [get_ports FMC2_HPC_LA04_N]
# # set_property PACKAGE_PIN AJ40 [get_ports FMC2_HPC_LA16_P]
# # set_property IOSTANDARD LVCMOS18 [get_ports FMC2_HPC_LA16_P]
# # set_property PACKAGE_PIN AJ41 [get_ports FMC2_HPC_LA16_N]
# # set_property IOSTANDARD LVCMOS18 [get_ports FMC2_HPC_LA16_N]
# # set_property PACKAGE_PIN AK39 [get_ports FMC2_HPC_LA02_P]
# # set_property IOSTANDARD LVCMOS18 [get_ports FMC2_HPC_LA02_P]
# # set_property PACKAGE_PIN AL39 [get_ports FMC2_HPC_LA02_N]
# # set_property IOSTANDARD LVCMOS18 [get_ports FMC2_HPC_LA02_N]
# # set_property PACKAGE_PIN AJ42 [get_ports FMC2_HPC_LA03_P]
# # set_property IOSTANDARD LVCMOS18 [get_ports FMC2_HPC_LA03_P]
# # set_property PACKAGE_PIN AK42 [get_ports FMC2_HPC_LA03_N]
# # set_property IOSTANDARD LVCMOS18 [get_ports FMC2_HPC_LA03_N]
# # #NET  5N829                     LOC = AG37 | IOSTANDARD=LVCMOS18; # Bank  17 VCCO - VADJ_FPGA - IO_25_VRP_17
# # #NET  6N1095                    LOC = N35  | IOSTANDARD=LVCMOS18; # Bank  18 VCCO - VADJ_FPGA - IO_0_VRN_18
# # #NET  6N1094                    LOC = T34  | IOSTANDARD=LVCMOS18; # Bank  18 VCCO - VADJ_FPGA - IO_L1P_T0_18
# # #NET  6N1093                    LOC = R35  | IOSTANDARD=LVCMOS18; # Bank  18 VCCO - VADJ_FPGA - IO_L1N_T0_18
# # set_property PACKAGE_PIN N33 [get_ports FMC2_HPC_LA26_P]
# # set_property IOSTANDARD LVCMOS18 [get_ports FMC2_HPC_LA26_P]
# # set_property PACKAGE_PIN N34 [get_ports FMC2_HPC_LA26_N]
# # set_property IOSTANDARD LVCMOS18 [get_ports FMC2_HPC_LA26_N]
# # set_property PACKAGE_PIN R33 [get_ports FMC2_HPC_LA25_P]
# # set_property IOSTANDARD LVCMOS18 [get_ports FMC2_HPC_LA25_P]
# # set_property PACKAGE_PIN R34 [get_ports FMC2_HPC_LA25_N]
# # set_property IOSTANDARD LVCMOS18 [get_ports FMC2_HPC_LA25_N]
# # set_property PACKAGE_PIN P35 [get_ports FMC2_HPC_LA21_P]
# # set_property IOSTANDARD LVCMOS18 [get_ports FMC2_HPC_LA21_P]
# # set_property PACKAGE_PIN P36 [get_ports FMC2_HPC_LA21_N]
# # set_property IOSTANDARD LVCMOS18 [get_ports FMC2_HPC_LA21_N]
# # set_property PACKAGE_PIN T32 [get_ports FMC2_HPC_LA30_P]
# # set_property IOSTANDARD LVCMOS18 [get_ports FMC2_HPC_LA30_P]
# # set_property PACKAGE_PIN R32 [get_ports FMC2_HPC_LA30_N]
# # set_property IOSTANDARD LVCMOS18 [get_ports FMC2_HPC_LA30_N]
# # set_property PACKAGE_PIN P32 [get_ports FMC2_HPC_LA27_P]
# # set_property IOSTANDARD LVCMOS18 [get_ports FMC2_HPC_LA27_P]
# # set_property PACKAGE_PIN P33 [get_ports FMC2_HPC_LA27_N]
# # set_property IOSTANDARD LVCMOS18 [get_ports FMC2_HPC_LA27_N]
# # set_property PACKAGE_PIN T36 [get_ports FMC2_HPC_LA33_P]
# # set_property IOSTANDARD LVCMOS18 [get_ports FMC2_HPC_LA33_P]
# # set_property PACKAGE_PIN R37 [get_ports FMC2_HPC_LA33_N]
# # set_property IOSTANDARD LVCMOS18 [get_ports FMC2_HPC_LA33_N]
# # set_property PACKAGE_PIN P37 [get_ports FMC2_HPC_LA32_P]
# # set_property IOSTANDARD LVCMOS18 [get_ports FMC2_HPC_LA32_P]
# # set_property PACKAGE_PIN P38 [get_ports FMC2_HPC_LA32_N]
# # set_property IOSTANDARD LVCMOS18 [get_ports FMC2_HPC_LA32_N]
# # set_property PACKAGE_PIN U34 [get_ports FMC2_HPC_LA24_P]
# # set_property IOSTANDARD LVCMOS18 [get_ports FMC2_HPC_LA24_P]
# # set_property PACKAGE_PIN T35 [get_ports FMC2_HPC_LA24_N]
# # set_property IOSTANDARD LVCMOS18 [get_ports FMC2_HPC_LA24_N]
# # set_property PACKAGE_PIN R38 [get_ports FMC2_HPC_LA23_P]
# # set_property IOSTANDARD LVCMOS18 [get_ports FMC2_HPC_LA23_P]
# # set_property PACKAGE_PIN R39 [get_ports FMC2_HPC_LA23_N]
# # set_property IOSTANDARD LVCMOS18 [get_ports FMC2_HPC_LA23_N]
# # set_property PACKAGE_PIN U37 [get_ports FMC2_HPC_LA17_CC_P]
# # set_property IOSTANDARD LVCMOS18 [get_ports FMC2_HPC_LA17_CC_P]
# # set_property PACKAGE_PIN U38 [get_ports FMC2_HPC_LA17_CC_N]
# # set_property IOSTANDARD LVCMOS18 [get_ports FMC2_HPC_LA17_CC_N]
# # set_property PACKAGE_PIN U39 [get_ports FMC2_HPC_CLK1_M2C_P]
# # set_property IOSTANDARD LVCMOS18 [get_ports FMC2_HPC_CLK1_M2C_P]
# # set_property PACKAGE_PIN T39 [get_ports FMC2_HPC_CLK1_M2C_N]
# # set_property IOSTANDARD LVCMOS18 [get_ports FMC2_HPC_CLK1_M2C_N]
# # set_property PACKAGE_PIN U36 [get_ports FMC2_HPC_LA18_CC_P]
# # set_property IOSTANDARD LVCMOS18 [get_ports FMC2_HPC_LA18_CC_P]
# # set_property PACKAGE_PIN T37 [get_ports FMC2_HPC_LA18_CC_N]
# # set_property IOSTANDARD LVCMOS18 [get_ports FMC2_HPC_LA18_CC_N]
# # set_property PACKAGE_PIN V35 [get_ports FMC2_HPC_LA28_P]
# # set_property IOSTANDARD LVCMOS18 [get_ports FMC2_HPC_LA28_P]
# # set_property PACKAGE_PIN V36 [get_ports FMC2_HPC_LA28_N]
# # set_property IOSTANDARD LVCMOS18 [get_ports FMC2_HPC_LA28_N]
# # set_property PACKAGE_PIN V33 [get_ports FMC2_HPC_LA20_P]
# # set_property IOSTANDARD LVCMOS18 [get_ports FMC2_HPC_LA20_P]
# # set_property PACKAGE_PIN V34 [get_ports FMC2_HPC_LA20_N]
# # set_property IOSTANDARD LVCMOS18 [get_ports FMC2_HPC_LA20_N]
# # set_property PACKAGE_PIN W36 [get_ports FMC2_HPC_LA29_P]
# # set_property IOSTANDARD LVCMOS18 [get_ports FMC2_HPC_LA29_P]
# # set_property PACKAGE_PIN W37 [get_ports FMC2_HPC_LA29_N]
# # set_property IOSTANDARD LVCMOS18 [get_ports FMC2_HPC_LA29_N]
# # set_property PACKAGE_PIN U32 [get_ports FMC2_HPC_LA19_P]
# # set_property IOSTANDARD LVCMOS18 [get_ports FMC2_HPC_LA19_P]
# # set_property PACKAGE_PIN U33 [get_ports FMC2_HPC_LA19_N]
# # set_property IOSTANDARD LVCMOS18 [get_ports FMC2_HPC_LA19_N]
# # set_property PACKAGE_PIN W32 [get_ports FMC2_HPC_LA22_P]
# # set_property IOSTANDARD LVCMOS18 [get_ports FMC2_HPC_LA22_P]
# # set_property PACKAGE_PIN W33 [get_ports FMC2_HPC_LA22_N]
# # set_property IOSTANDARD LVCMOS18 [get_ports FMC2_HPC_LA22_N]
# # set_property PACKAGE_PIN V39 [get_ports FMC2_HPC_LA31_P]
# # set_property IOSTANDARD LVCMOS18 [get_ports FMC2_HPC_LA31_P]
# # set_property PACKAGE_PIN V40 [get_ports FMC2_HPC_LA31_N]
# # set_property IOSTANDARD LVCMOS18 [get_ports FMC2_HPC_LA31_N]


# # #NET  6N1047                    LOC = T40  | IOSTANDARD=LVCMOS18; # Bank  18 VCCO - VADJ_FPGA - IO_L20P_T3_18
# # #NET  6N1048                    LOC = T41  | IOSTANDARD=LVCMOS18; # Bank  18 VCCO - VADJ_FPGA - IO_L20N_T3_18
# # #NET  6N1024                    LOC = W41  | IOSTANDARD=LVCMOS18; # Bank  18 VCCO - VADJ_FPGA - IO_L21P_T3_DQS_18
# # #NET  6N1025                    LOC = W42  | IOSTANDARD=LVCMOS18; # Bank  18 VCCO - VADJ_FPGA - IO_L21N_T3_DQS_18
# # #NET  6N1027                    LOC = U41  | IOSTANDARD=LVCMOS18; # Bank  18 VCCO - VADJ_FPGA - IO_L22P_T3_18
# # #NET  6N1026                    LOC = T42  | IOSTANDARD=LVCMOS18; # Bank  18 VCCO - VADJ_FPGA - IO_L22N_T3_18
# # #NET  6N1031                    LOC = W38  | IOSTANDARD=LVCMOS18; # Bank  18 VCCO - VADJ_FPGA - IO_L23P_T3_18
# # #NET  6N1030                    LOC = V38  | IOSTANDARD=LVCMOS18; # Bank  18 VCCO - VADJ_FPGA - IO_L23N_T3_18
# # #NET  6N1028                    LOC = V41  | IOSTANDARD=LVCMOS18; # Bank  18 VCCO - VADJ_FPGA - IO_L24P_T3_18
# # #NET  6N1029                    LOC = U42  | IOSTANDARD=LVCMOS18; # Bank  18 VCCO - VADJ_FPGA - IO_L24N_T3_18
# # #NET  6N1023                    LOC = W35  | IOSTANDARD=LVCMOS18; # Bank  18 VCCO - VADJ_FPGA - IO_25_VRP_18
# # #NET  VRN_19                    LOC = L36  | IOSTANDARD=LVCMOS18; # Bank  19 VCCO - VADJ_FPGA - IO_0_VRN_19
# # #NET  6N957                     LOC = E40  | IOSTANDARD=LVCMOS18; # Bank  19 VCCO - VADJ_FPGA - IO_L1P_T0_19
# # #NET  6N958                     LOC = D40  | IOSTANDARD=LVCMOS18; # Bank  19 VCCO - VADJ_FPGA - IO_L1N_T0_19
# # #NET  6N959                     LOC = A40  | IOSTANDARD=LVCMOS18; # Bank  19 VCCO - VADJ_FPGA - IO_L2P_T0_19
# # #NET  6N960                     LOC = A41  | IOSTANDARD=LVCMOS18; # Bank  19 VCCO - VADJ_FPGA - IO_L2N_T0_19
# # #NET  6N961                     LOC = D41  | IOSTANDARD=LVCMOS18; # Bank  19 VCCO - VADJ_FPGA - IO_L3P_T0_DQS_19
# # #NET  6N963                     LOC = D42  | IOSTANDARD=LVCMOS18; # Bank  19 VCCO - VADJ_FPGA - IO_L3N_T0_DQS_19
# # #NET  6N962                     LOC = B41  | IOSTANDARD=LVCMOS18; # Bank  19 VCCO - VADJ_FPGA - IO_L4P_T0_19
# # #NET  6N964                     LOC = B42  | IOSTANDARD=LVCMOS18; # Bank  19 VCCO - VADJ_FPGA - IO_L4N_T0_19
# # #NET  6N967                     LOC = F42  | IOSTANDARD=LVCMOS18; # Bank  19 VCCO - VADJ_FPGA - IO_L5P_T0_19
# # #NET  6N968                     LOC = E42  | IOSTANDARD=LVCMOS18; # Bank  19 VCCO - VADJ_FPGA - IO_L5N_T0_19
# # #NET  6N969                     LOC = C40  | IOSTANDARD=LVCMOS18; # Bank  19 VCCO - VADJ_FPGA - IO_L6P_T0_19
# # #NET  6N970                     LOC = C41  | IOSTANDARD=LVCMOS18; # Bank  19 VCCO - VADJ_FPGA - IO_L6N_T0_VREF_19

# ##############################################################
# ############################ FMC2 ############################
# ##############################################################
# # # --- LA Bank (00 to 16) ---
# set_property -dict { PACKAGE_PIN AD40 IOSTANDARD LVCMOS18 } [get_ports { gpio_io[0] }];    # AD40 FMC2_HPC_LA00_CC_P
# set_property -dict { PACKAGE_PIN AD41 IOSTANDARD LVCMOS18 } [get_ports { gpio_io[1] }];    # AD41 FMC2_HPC_LA00_CC_N
# set_property -dict { PACKAGE_PIN AF41 IOSTANDARD LVCMOS18 } [get_ports { uart0_rx }];    # AF41 FMC2_HPC_LA01_CC_P
# set_property -dict { PACKAGE_PIN AG41 IOSTANDARD LVCMOS18 } [get_ports { uart0_tx }];    # AG41 FMC2_HPC_LA01_CC_N
# set_property -dict { PACKAGE_PIN AK39 IOSTANDARD LVCMOS18 } [get_ports { gpio_io[4] }];       # AK39 FMC2_HPC_LA02_P
# set_property -dict { PACKAGE_PIN AL39 IOSTANDARD LVCMOS18 } [get_ports { gpio_io[5] }];       # AL39 FMC2_HPC_LA02_N
# set_property -dict { PACKAGE_PIN AJ42 IOSTANDARD LVCMOS18 } [get_ports { gpio_io[2] }];       # AJ42 FMC2_HPC_LA03_P
# set_property -dict { PACKAGE_PIN AK42 IOSTANDARD LVCMOS18 } [get_ports { gpio_io[3] }];       # AK42 FMC2_HPC_LA03_N
# set_property -dict { PACKAGE_PIN AL41 IOSTANDARD LVCMOS18 } [get_ports { gpio_io[6] }];       # AL41 FMC2_HPC_LA04_P
# set_property -dict { PACKAGE_PIN AL42 IOSTANDARD LVCMOS18 } [get_ports { gpio_io[7] }];       # AL42 FMC2_HPC_LA04_N
# set_property -dict { PACKAGE_PIN AF42 IOSTANDARD LVCMOS18 } [get_ports { i2c0_scl }];       # AF42 FMC2_HPC_LA05_P
# set_property -dict { PACKAGE_PIN AG42 IOSTANDARD LVCMOS18 } [get_ports { i2c0_sda }];       # AG42 FMC2_HPC_LA05_N
# set_property -dict { PACKAGE_PIN AD38 IOSTANDARD LVCMOS18 } [get_ports { spi0_clk }];       # AD38 FMC2_HPC_LA06_P
# set_property -dict { PACKAGE_PIN AE38 IOSTANDARD LVCMOS18 } [get_ports { spi0_mosi }];       # AE38 FMC2_HPC_LA06_N
# # set_property -dict { PACKAGE_PIN AC40 IOSTANDARD LVCMOS18 } [get_ports { FMC2_HPC_LA07_P }];       # AC40 FMC2_HPC_LA07_P
# # set_property -dict { PACKAGE_PIN AC41 IOSTANDARD LVCMOS18 } [get_ports { FMC2_HPC_LA07_N }];       # AC41 FMC2_HPC_LA07_N
# # set_property -dict { PACKAGE_PIN AD42 IOSTANDARD LVCMOS18 } [get_ports { FMC2_HPC_LA08_P }];       # AD42 FMC2_HPC_LA08_P
# # set_property -dict { PACKAGE_PIN AE42 IOSTANDARD LVCMOS18 } [get_ports { FMC2_HPC_LA08_N }];       # AE42 FMC2_HPC_LA08_N
# # set_property -dict { PACKAGE_PIN AJ38 IOSTANDARD LVCMOS18 } [get_ports { FMC2_HPC_LA09_P }];       # AJ38 FMC2_HPC_LA09_P
# # set_property -dict { PACKAGE_PIN AK38 IOSTANDARD LVCMOS18 } [get_ports { FMC2_HPC_LA09_N }];       # AK38 FMC2_HPC_LA09_N
# set_property -dict { PACKAGE_PIN AB41 IOSTANDARD LVCMOS18 } [get_ports { spi0_miso }];       # AB41 FMC2_HPC_LA10_P
# set_property -dict { PACKAGE_PIN AB42 IOSTANDARD LVCMOS18 } [get_ports { spi0_ss_n[0] }];       # AB42 FMC2_HPC_LA10_N
# # set_property -dict { PACKAGE_PIN Y42  IOSTANDARD LVCMOS18 } [get_ports { FMC2_HPC_LA11_P }];       # Y42  FMC2_HPC_LA11_P
# # set_property -dict { PACKAGE_PIN AA42 IOSTANDARD LVCMOS18 } [get_ports { FMC2_HPC_LA11_N }];       # AA42 FMC2_HPC_LA11_N
# # set_property -dict { PACKAGE_PIN Y39  IOSTANDARD LVCMOS18 } [get_ports { FMC2_HPC_LA12_P }];       # Y39  FMC2_HPC_LA12_P
# # set_property -dict { PACKAGE_PIN AA39 IOSTANDARD LVCMOS18 } [get_ports { FMC2_HPC_LA12_N }];       # AA39 FMC2_HPC_LA12_N
# # set_property -dict { PACKAGE_PIN W40  IOSTANDARD LVCMOS18 } [get_ports { FMC2_HPC_LA13_P }];       # W40  FMC2_HPC_LA13_P
# # set_property -dict { PACKAGE_PIN Y40  IOSTANDARD LVCMOS18 } [get_ports { FMC2_HPC_LA13_N }];       # Y40  FMC2_HPC_LA13_N
# set_property -dict { PACKAGE_PIN AB38 IOSTANDARD LVCMOS18 } [get_ports { spi0_ss_n[1] }];       # AB38 FMC2_HPC_LA14_P
# # set_property -dict { PACKAGE_PIN AB39 IOSTANDARD LVCMOS18 } [get_ports { FMC2_HPC_LA14_N }];       # AB39 FMC2_HPC_LA14_N
# # set_property -dict { PACKAGE_PIN AC38 IOSTANDARD LVCMOS18 } [get_ports { FMC2_HPC_LA15_P }];       # AC38 FMC2_HPC_LA15_P
# # set_property -dict { PACKAGE_PIN AC39 IOSTANDARD LVCMOS18 } [get_ports { FMC2_HPC_LA15_N }];       # AC39 FMC2_HPC_LA15_N
# # set_property -dict { PACKAGE_PIN AJ40 IOSTANDARD LVCMOS18 } [get_ports { FMC2_HPC_LA16_P }];       # AJ40 FMC2_HPC_LA16_P
# # set_property -dict { PACKAGE_PIN AJ41 IOSTANDARD LVCMOS18 } [get_ports { FMC2_HPC_LA16_N }];       # AJ41 FMC2_HPC_LA16_N
# # set_property -dict { PACKAGE_PIN AF39 IOSTANDARD LVCMOS18 } [get_ports { FMC2_HPC_CLK0_M2C_P }];   # AF39 FMC2_HPC_CLK0_M2C_P
# # set_property -dict { PACKAGE_PIN AF40 IOSTANDARD LVCMOS18 } [get_ports { FMC2_HPC_CLK0_M2C_N }];   # AF40 FMC2_HPC_CLK0_M2C_N

# # # --- LA Bank (17 to 31) ---
# # set_property -dict { PACKAGE_PIN U37  IOSTANDARD LVCMOS18 } [get_ports { FMC2_HPC_LA17_CC_P }];    # U37  FMC2_HPC_LA17_CC_P
# # set_property -dict { PACKAGE_PIN U38  IOSTANDARD LVCMOS18 } [get_ports { FMC2_HPC_LA17_CC_N }];    # U38  FMC2_HPC_LA17_CC_N
# # set_property -dict { PACKAGE_PIN U36  IOSTANDARD LVCMOS18 } [get_ports { FMC2_HPC_LA18_CC_P }];    # U36  FMC2_HPC_LA18_CC_P
# # set_property -dict { PACKAGE_PIN T37  IOSTANDARD LVCMOS18 } [get_ports { FMC2_HPC_LA18_CC_N }];    # T37  FMC2_HPC_LA18_CC_N
# # set_property -dict { PACKAGE_PIN U32  IOSTANDARD LVCMOS18 } [get_ports { FMC2_HPC_LA19_P }];       # U32  FMC2_HPC_LA19_P
# # set_property -dict { PACKAGE_PIN U33  IOSTANDARD LVCMOS18 } [get_ports { FMC2_HPC_LA19_N }];       # U33  FMC2_HPC_LA19_N
# # set_property -dict { PACKAGE_PIN V33  IOSTANDARD LVCMOS18 } [get_ports { FMC2_HPC_LA20_P }];       # V33  FMC2_HPC_LA20_P
# # set_property -dict { PACKAGE_PIN V34  IOSTANDARD LVCMOS18 } [get_ports { FMC2_HPC_LA20_N }];       # V34  FMC2_HPC_LA20_N
# # set_property -dict { PACKAGE_PIN P35  IOSTANDARD LVCMOS18 } [get_ports { FMC2_HPC_LA21_P }];       # P35  FMC2_HPC_LA21_P
# # set_property -dict { PACKAGE_PIN P36  IOSTANDARD LVCMOS18 } [get_ports { FMC2_HPC_LA21_N }];       # P36  FMC2_HPC_LA21_N
# # set_property -dict { PACKAGE_PIN W32  IOSTANDARD LVCMOS18 } [get_ports { FMC2_HPC_LA22_P }];       # W32  FMC2_HPC_LA22_P
# # set_property -dict { PACKAGE_PIN W33  IOSTANDARD LVCMOS18 } [get_ports { FMC2_HPC_LA22_N }];       # W33  FMC2_HPC_LA22_N
# # set_property -dict { PACKAGE_PIN R38  IOSTANDARD LVCMOS18 } [get_ports { FMC2_HPC_LA23_P }];       # R38  FMC2_HPC_LA23_P
# # set_property -dict { PACKAGE_PIN R39  IOSTANDARD LVCMOS18 } [get_ports { FMC2_HPC_LA23_N }];       # R39  FMC2_HPC_LA23_N
# # set_property -dict { PACKAGE_PIN U34  IOSTANDARD LVCMOS18 } [get_ports { FMC2_HPC_LA24_P }];       # U34  FMC2_HPC_LA24_P
# # set_property -dict { PACKAGE_PIN T35  IOSTANDARD LVCMOS18 } [get_ports { FMC2_HPC_LA24_N }];       # T35  FMC2_HPC_LA24_N
# # set_property -dict { PACKAGE_PIN R33  IOSTANDARD LVCMOS18 } [get_ports { FMC2_HPC_LA25_P }];       # R33  FMC2_HPC_LA25_P
# # set_property -dict { PACKAGE_PIN R34  IOSTANDARD LVCMOS18 } [get_ports { FMC2_HPC_LA25_N }];       # R34  FMC2_HPC_LA25_N
# # set_property -dict { PACKAGE_PIN N33  IOSTANDARD LVCMOS18 } [get_ports { FMC2_HPC_LA26_P }];       # N33  FMC2_HPC_LA26_P
# # set_property -dict { PACKAGE_PIN N34  IOSTANDARD LVCMOS18 } [get_ports { FMC2_HPC_LA26_N }];       # N34  FMC2_HPC_LA26_N
# # set_property -dict { PACKAGE_PIN P32  IOSTANDARD LVCMOS18 } [get_ports { FMC2_HPC_LA27_P }];       # P32  FMC2_HPC_LA27_P
# # set_property -dict { PACKAGE_PIN P33  IOSTANDARD LVCMOS18 } [get_ports { FMC2_HPC_LA27_N }];       # P33  FMC2_HPC_LA27_N
# # set_property -dict { PACKAGE_PIN V35  IOSTANDARD LVCMOS18 } [get_ports { FMC2_HPC_LA28_P }];       # V35  FMC2_HPC_LA28_P
# # set_property -dict { PACKAGE_PIN V36  IOSTANDARD LVCMOS18 } [get_ports { FMC2_HPC_LA28_N }];       # V36  FMC2_HPC_LA28_N
# # set_property -dict { PACKAGE_PIN W36  IOSTANDARD LVCMOS18 } [get_ports { FMC2_HPC_LA29_P }];       # W36  FMC2_HPC_LA29_P
# # set_property -dict { PACKAGE_PIN W37  IOSTANDARD LVCMOS18 } [get_ports { FMC2_HPC_LA29_N }];       # W37  FMC2_HPC_LA29_N
# # set_property -dict { PACKAGE_PIN T32  IOSTANDARD LVCMOS18 } [get_ports { FMC2_HPC_LA30_P }];       # T32  FMC2_HPC_LA30_P
# # set_property -dict { PACKAGE_PIN R32  IOSTANDARD LVCMOS18 } [get_ports { FMC2_HPC_LA30_N }];       # R32  FMC2_HPC_LA30_N
# # set_property -dict { PACKAGE_PIN V39  IOSTANDARD LVCMOS18 } [get_ports { FMC2_HPC_LA31_P }];       # V39  FMC2_HPC_LA31_P
# # set_property -dict { PACKAGE_PIN V40  IOSTANDARD LVCMOS18 } [get_ports { FMC2_HPC_LA31_N }];       # V40  FMC2_HPC_LA31_N
# # set_property -dict { PACKAGE_PIN P37  IOSTANDARD LVCMOS18 } [get_ports { FMC2_HPC_LA32_P }];       # P37  FMC2_HPC_LA32_P
# # set_property -dict { PACKAGE_PIN P38  IOSTANDARD LVCMOS18 } [get_ports { FMC2_HPC_LA32_N }];       # P38  FMC2_HPC_LA32_N
# # set_property -dict { PACKAGE_PIN T36  IOSTANDARD LVCMOS18 } [get_ports { FMC2_HPC_LA33_P }];       # T36  FMC2_HPC_LA33_P
# # set_property -dict { PACKAGE_PIN R37  IOSTANDARD LVCMOS18 } [get_ports { FMC2_HPC_LA33_N }];       # R37  FMC2_HPC_LA33_N
# # set_property -dict { PACKAGE_PIN U39  IOSTANDARD LVCMOS18 } [get_ports { FMC2_HPC_CLK1_M2C_P }];   # U39  FMC2_HPC_CLK1_M2C_P
# # set_property -dict { PACKAGE_PIN T39  IOSTANDARD LVCMOS18 } [get_ports { FMC2_HPC_CLK1_M2C_N }];   # T39  FMC2_HPC_CLK1_M2C_N

# # # --- HA Bank ---
# # set_property -dict { PACKAGE_PIN AB33 IOSTANDARD LVCMOS18 } [get_ports { FMC2_HPC_HA00_CC_P }];    # AB33 FMC2_HPC_HA00_CC_P
# # set_property -dict { PACKAGE_PIN AC33 IOSTANDARD LVCMOS18 } [get_ports { FMC2_HPC_HA00_CC_N }];    # AC33 FMC2_HPC_HA00_CC_N
# # set_property -dict { PACKAGE_PIN AD32 IOSTANDARD LVCMOS18 } [get_ports { FMC2_HPC_HA01_CC_P }];    # AD32 FMC2_HPC_HA01_CC_P
# # set_property -dict { PACKAGE_PIN AD33 IOSTANDARD LVCMOS18 } [get_ports { FMC2_HPC_HA01_CC_N }];    # AD33 FMC2_HPC_HA01_CC_N
# # set_property -dict { PACKAGE_PIN AC30 IOSTANDARD LVCMOS18 } [get_ports { FMC2_HPC_HA02_P }];       # AC30 FMC2_HPC_HA02_P
# # set_property -dict { PACKAGE_PIN AD30 IOSTANDARD LVCMOS18 } [get_ports { FMC2_HPC_HA02_N }];       # AD30 FMC2_HPC_HA02_N
# # set_property -dict { PACKAGE_PIN AA29 IOSTANDARD LVCMOS18 } [get_ports { FMC2_HPC_HA03_P }];       # AA29 FMC2_HPC_HA03_P
# # set_property -dict { PACKAGE_PIN AA30 IOSTANDARD LVCMOS18 } [get_ports { FMC2_HPC_HA03_N }];       # AA30 FMC2_HPC_HA03_N
# # set_property -dict { PACKAGE_PIN AB29 IOSTANDARD LVCMOS18 } [get_ports { FMC2_HPC_HA04_P }];       # AB29 FMC2_HPC_HA04_P
# # set_property -dict { PACKAGE_PIN AC29 IOSTANDARD LVCMOS18 } [get_ports { FMC2_HPC_HA04_N }];       # AC29 FMC2_HPC_HA04_N
# # set_property -dict { PACKAGE_PIN Y32  IOSTANDARD LVCMOS18 } [get_ports { FMC2_HPC_HA05_P }];       # Y32  FMC2_HPC_HA05_P
# # set_property -dict { PACKAGE_PIN Y33  IOSTANDARD LVCMOS18 } [get_ports { FMC2_HPC_HA05_N }];       # Y33  FMC2_HPC_HA05_N
# # set_property -dict { PACKAGE_PIN AB31 IOSTANDARD LVCMOS18 } [get_ports { FMC2_HPC_HA06_P }];       # AB31 FMC2_HPC_HA06_P
# # set_property -dict { PACKAGE_PIN AB32 IOSTANDARD LVCMOS18 } [get_ports { FMC2_HPC_HA06_N }];       # AB32 FMC2_HPC_HA06_N
# # set_property -dict { PACKAGE_PIN AC31 IOSTANDARD LVCMOS18 } [get_ports { FMC2_HPC_HA07_P }];       # AC31 FMC2_HPC_HA07_P
# # set_property -dict { PACKAGE_PIN AD31 IOSTANDARD LVCMOS18 } [get_ports { FMC2_HPC_HA07_N }];       # AD31 FMC2_HPC_HA07_N
# # set_property -dict { PACKAGE_PIN AA31 IOSTANDARD LVCMOS18 } [get_ports { FMC2_HPC_HA08_P }];       # AA31 FMC2_HPC_HA08_P
# # set_property -dict { PACKAGE_PIN AA32 IOSTANDARD LVCMOS18 } [get_ports { FMC2_HPC_HA08_N }];       # AA32 FMC2_HPC_HA08_N
# # set_property -dict { PACKAGE_PIN AE29 IOSTANDARD LVCMOS18 } [get_ports { FMC2_HPC_HA09_P }];       # AE29 FMC2_HPC_HA09_P
# # set_property -dict { PACKAGE_PIN AE30 IOSTANDARD LVCMOS18 } [get_ports { FMC2_HPC_HA09_N }];       # AE30 FMC2_HPC_HA09_N
# # set_property -dict { PACKAGE_PIN AF31 IOSTANDARD LVCMOS18 } [get_ports { FMC2_HPC_HA10_P }];       # AF31 FMC2_HPC_HA10_P
# # set_property -dict { PACKAGE_PIN AF32 IOSTANDARD LVCMOS18 } [get_ports { FMC2_HPC_HA10_N }];       # AF32 FMC2_HPC_HA10_N
# # set_property -dict { PACKAGE_PIN AE34 IOSTANDARD LVCMOS18 } [get_ports { FMC2_HPC_HA11_P }];       # AE34 FMC2_HPC_HA11_P
# # set_property -dict { PACKAGE_PIN AE35 IOSTANDARD LVCMOS18 } [get_ports { FMC2_HPC_HA11_N }];       # AE35 FMC2_HPC_HA11_N
# # set_property -dict { PACKAGE_PIN AF34 IOSTANDARD LVCMOS18 } [get_ports { FMC2_HPC_HA12_P }];       # AF34 FMC2_HPC_HA12_P
# # set_property -dict { PACKAGE_PIN AG34 IOSTANDARD LVCMOS18 } [get_ports { FMC2_HPC_HA12_N }];       # AG34 FMC2_HPC_HA12_N
# # set_property -dict { PACKAGE_PIN AE32 IOSTANDARD LVCMOS18 } [get_ports { FMC2_HPC_HA13_P }];       # AE32 FMC2_HPC_HA13_P
# # set_property -dict { PACKAGE_PIN AE33 IOSTANDARD LVCMOS18 } [get_ports { FMC2_HPC_HA13_N }];       # AE33 FMC2_HPC_HA13_N
# # set_property -dict { PACKAGE_PIN AF35 IOSTANDARD LVCMOS18 } [get_ports { FMC2_HPC_HA14_P }];       # AF35 FMC2_HPC_HA14_P
# # set_property -dict { PACKAGE_PIN AF36 IOSTANDARD LVCMOS18 } [get_ports { FMC2_HPC_HA14_N }];       # AF36 FMC2_HPC_HA14_N
# # set_property -dict { PACKAGE_PIN AE37 IOSTANDARD LVCMOS18 } [get_ports { FMC2_HPC_HA15_P }];       # AE37 FMC2_HPC_HA15_P
# # set_property -dict { PACKAGE_PIN AF37 IOSTANDARD LVCMOS18 } [get_ports { FMC2_HPC_HA15_N }];       # AF37 FMC2_HPC_HA15_N
# # set_property -dict { PACKAGE_PIN AG36 IOSTANDARD LVCMOS18 } [get_ports { FMC2_HPC_HA16_P }];       # AG36 FMC2_HPC_HA16_P
# # set_property -dict { PACKAGE_PIN AH36 IOSTANDARD LVCMOS18 } [get_ports { FMC2_HPC_HA16_N }];       # AH36 FMC2_HPC_HA16_N
# # set_property -dict { PACKAGE_PIN AC34 IOSTANDARD LVCMOS18 } [get_ports { FMC2_HPC_HA17_CC_P }];    # AC34 FMC2_HPC_HA17_CC_P
# # set_property -dict { PACKAGE_PIN AD35 IOSTANDARD LVCMOS18 } [get_ports { FMC2_HPC_HA17_CC_N }];    # AD35 FMC2_HPC_HA17_CC_N
# # set_property -dict { PACKAGE_PIN AB36 IOSTANDARD LVCMOS18 } [get_ports { FMC2_HPC_HA18_P }];       # AB36 FMC2_HPC_HA18_P
# # set_property -dict { PACKAGE_PIN AB37 IOSTANDARD LVCMOS18 } [get_ports { FMC2_HPC_HA18_N }];       # AB37 FMC2_HPC_HA18_N
# # set_property -dict { PACKAGE_PIN AC35 IOSTANDARD LVCMOS18 } [get_ports { FMC2_HPC_HA19_P }];       # AC35 FMC2_HPC_HA19_P
# # set_property -dict { PACKAGE_PIN AC36 IOSTANDARD LVCMOS18 } [get_ports { FMC2_HPC_HA19_N }];       # AC36 FMC2_HPC_HA19_N
# # set_property -dict { PACKAGE_PIN AD36 IOSTANDARD LVCMOS18 } [get_ports { FMC2_HPC_HA20_P }];       # AD36 FMC2_HPC_HA20_P
# # set_property -dict { PACKAGE_PIN AD37 IOSTANDARD LVCMOS18 } [get_ports { FMC2_HPC_HA20_N }];       # AD37 FMC2_HPC_HA20_N
# # set_property -dict { PACKAGE_PIN AA34 IOSTANDARD LVCMOS18 } [get_ports { FMC2_HPC_HA21_P }];       # AA34 FMC2_HPC_HA21_P
# # set_property -dict { PACKAGE_PIN AA35 IOSTANDARD LVCMOS18 } [get_ports { FMC2_HPC_HA21_N }];       # AA35 FMC2_HPC_HA21_N
# # set_property -dict { PACKAGE_PIN Y35  IOSTANDARD LVCMOS18 } [get_ports { FMC2_HPC_HA22_P }];       # Y35  FMC2_HPC_HA22_P
# # set_property -dict { PACKAGE_PIN AA36 IOSTANDARD LVCMOS18 } [get_ports { FMC2_HPC_HA22_N }];       # AA36 FMC2_HPC_HA22_N
# # set_property -dict { PACKAGE_PIN Y37  IOSTANDARD LVCMOS18 } [get_ports { FMC2_HPC_HA23_P }];       # Y37  FMC2_HPC_HA23_P
# # set_property -dict { PACKAGE_PIN AA37 IOSTANDARD LVCMOS18 } [get_ports { FMC2_HPC_HA23_N }];       # AA37 FMC2_HPC_HA23_N


# ##############################################################
# ############################ FMC1 ############################
# ##############################################################
# # # --- LA Bank (00 to 16) ---
# # set_property -dict { PACKAGE_PIN K39 IOSTANDARD LVCMOS18 } [get_ports { FMC1_HPC_LA00_CC_P }];    # K39  FMC1_HPC_LA00_CC_P
# # set_property -dict { PACKAGE_PIN K40 IOSTANDARD LVCMOS18 } [get_ports { FMC1_HPC_LA00_CC_N }];    # K40  FMC1_HPC_LA00_CC_N
# # set_property -dict { PACKAGE_PIN J40 IOSTANDARD LVCMOS18 } [get_ports { FMC1_HPC_LA01_CC_P }];    # J40  FMC1_HPC_LA01_CC_P
# # set_property -dict { PACKAGE_PIN J41 IOSTANDARD LVCMOS18 } [get_ports { FMC1_HPC_LA01_CC_N }];    # J41  FMC1_HPC_LA01_CC_N
# # set_property -dict { PACKAGE_PIN P41 IOSTANDARD LVCMOS18 } [get_ports { FMC1_HPC_LA02_P }];       # P41  FMC1_HPC_LA02_P
# # set_property -dict { PACKAGE_PIN N41 IOSTANDARD LVCMOS18 } [get_ports { FMC1_HPC_LA02_N }];       # N41  FMC1_HPC_LA02_N
# # set_property -dict { PACKAGE_PIN M42 IOSTANDARD LVCMOS18 } [get_ports { FMC1_HPC_LA03_P }];       # M42  FMC1_HPC_LA03_P
# # set_property -dict { PACKAGE_PIN L42 IOSTANDARD LVCMOS18 } [get_ports { FMC1_HPC_LA03_N }];       # L42  FMC1_HPC_LA03_N
# # set_property -dict { PACKAGE_PIN H40 IOSTANDARD LVCMOS18 } [get_ports { FMC1_HPC_LA04_P }];       # H40  FMC1_HPC_LA04_P
# # set_property -dict { PACKAGE_PIN H41 IOSTANDARD LVCMOS18 } [get_ports { FMC1_HPC_LA04_N }];       # H41  FMC1_HPC_LA04_N
# # set_property -dict { PACKAGE_PIN M41 IOSTANDARD LVCMOS18 } [get_ports { FMC1_HPC_LA05_P }];       # M41  FMC1_HPC_LA05_P
# # set_property -dict { PACKAGE_PIN L41 IOSTANDARD LVCMOS18 } [get_ports { FMC1_HPC_LA05_N }];       # L41  FMC1_HPC_LA05_N
# # set_property -dict { PACKAGE_PIN K42 IOSTANDARD LVCMOS18 } [get_ports { FMC1_HPC_LA06_P }];       # K42  FMC1_HPC_LA06_P
# # set_property -dict { PACKAGE_PIN J42 IOSTANDARD LVCMOS18 } [get_ports { FMC1_HPC_LA06_N }];       # J42  FMC1_HPC_LA06_N
# # set_property -dict { PACKAGE_PIN G41 IOSTANDARD LVCMOS18 } [get_ports { FMC1_HPC_LA07_P }];       # G41  FMC1_HPC_LA07_P
# # set_property -dict { PACKAGE_PIN G42 IOSTANDARD LVCMOS18 } [get_ports { FMC1_HPC_LA07_N }];       # G42  FMC1_HPC_LA07_N
# # set_property -dict { PACKAGE_PIN M37 IOSTANDARD LVCMOS18 } [get_ports { FMC1_HPC_LA08_P }];       # M37  FMC1_HPC_LA08_P
# # set_property -dict { PACKAGE_PIN M38 IOSTANDARD LVCMOS18 } [get_ports { FMC1_HPC_LA08_N }];       # M38  FMC1_HPC_LA08_N
# # set_property -dict { PACKAGE_PIN R42 IOSTANDARD LVCMOS18 } [get_ports { FMC1_HPC_LA09_P }];       # R42  FMC1_HPC_LA09_P
# # set_property -dict { PACKAGE_PIN P42 IOSTANDARD LVCMOS18 } [get_ports { FMC1_HPC_LA09_N }];       # P42  FMC1_HPC_LA09_N
# # set_property -dict { PACKAGE_PIN N38 IOSTANDARD LVCMOS18 } [get_ports { FMC1_HPC_LA10_P }];       # N38  FMC1_HPC_LA10_P
# # set_property -dict { PACKAGE_PIN M39 IOSTANDARD LVCMOS18 } [get_ports { FMC1_HPC_LA10_N }];       # M39  FMC1_HPC_LA10_N
# # set_property -dict { PACKAGE_PIN F40 IOSTANDARD LVCMOS18 } [get_ports { FMC1_HPC_LA11_P }];       # F40  FMC1_HPC_LA11_P
# # set_property -dict { PACKAGE_PIN F41 IOSTANDARD LVCMOS18 } [get_ports { FMC1_HPC_LA11_N }];       # F41  FMC1_HPC_LA11_N
# # set_property -dict { PACKAGE_PIN R40 IOSTANDARD LVCMOS18 } [get_ports { FMC1_HPC_LA12_P }];       # R40  FMC1_HPC_LA12_P
# # set_property -dict { PACKAGE_PIN P40 IOSTANDARD LVCMOS18 } [get_ports { FMC1_HPC_LA12_N }];       # P40  FMC1_HPC_LA12_N
# # set_property -dict { PACKAGE_PIN H39 IOSTANDARD LVCMOS18 } [get_ports { FMC1_HPC_LA13_P }];       # H39  FMC1_HPC_LA13_P
# # set_property -dict { PACKAGE_PIN G39 IOSTANDARD LVCMOS18 } [get_ports { FMC1_HPC_LA13_N }];       # G39  FMC1_HPC_LA13_N
# # set_property -dict { PACKAGE_PIN N39 IOSTANDARD LVCMOS18 } [get_ports { FMC1_HPC_LA14_P }];       # N39  FMC1_HPC_LA14_P
# # set_property -dict { PACKAGE_PIN N40 IOSTANDARD LVCMOS18 } [get_ports { FMC1_HPC_LA14_N }];       # N40  FMC1_HPC_LA14_N
# set_property -dict { PACKAGE_PIN M36 IOSTANDARD LVCMOS18 } [get_ports { hyperram0_dq_io[7] }];       # M36  FMC1_HPC_LA15_P
# set_property -dict { PACKAGE_PIN L37 IOSTANDARD LVCMOS18 } [get_ports { hyperram0_dq_io[6] }];       # L37  FMC1_HPC_LA15_N
# # set_property -dict { PACKAGE_PIN K37 IOSTANDARD LVCMOS18 } [get_ports { FMC1_HPC_LA16_P }];       # K37  FMC1_HPC_LA16_P
# # set_property -dict { PACKAGE_PIN K38 IOSTANDARD LVCMOS18 } [get_ports { FMC1_HPC_LA16_N }];       # K38  FMC1_HPC_LA16_N
# # set_property -dict { PACKAGE_PIN L39 IOSTANDARD LVCMOS18 } [get_ports { FMC1_HPC_CLK0_M2C_P }];   # L39  FMC1_HPC_CLK0_M2C_P
# # set_property -dict { PACKAGE_PIN L40 IOSTANDARD LVCMOS18 } [get_ports { FMC1_HPC_CLK0_M2C_N }];   # L40  FMC1_HPC_CLK0_M2C_N

# # # --- LA Bank (17 to 33) ---
# # set_property -dict { PACKAGE_PIN L31 IOSTANDARD LVCMOS18 } [get_ports { FMC1_HPC_LA17_CC_P }];    # L31  FMC1_HPC_LA17_CC_P
# # set_property -dict { PACKAGE_PIN K32 IOSTANDARD LVCMOS18 } [get_ports { FMC1_HPC_LA17_CC_N }];    # K32  FMC1_HPC_LA17_CC_N
# # set_property -dict { PACKAGE_PIN M32 IOSTANDARD LVCMOS18 } [get_ports { FMC1_HPC_LA18_CC_P }];    # M32  FMC1_HPC_LA18_CC_P
# # set_property -dict { PACKAGE_PIN L32 IOSTANDARD LVCMOS18 } [get_ports { FMC1_HPC_LA18_CC_N }];    # L32  FMC1_HPC_LA18_CC_N
# set_property -dict { PACKAGE_PIN W30 IOSTANDARD LVCMOS18 } [get_ports { hyperram0_dq_io[1] }];       # W30  FMC1_HPC_LA19_P
# set_property -dict { PACKAGE_PIN W31 IOSTANDARD LVCMOS18 } [get_ports { hyperram0_dq_io[5] }];       # W31  FMC1_HPC_LA19_N
# # set_property -dict { PACKAGE_PIN Y29 IOSTANDARD LVCMOS18 } [get_ports { FMC1_HPC_LA20_P }];       # Y29  FMC1_HPC_LA20_P
# # set_property -dict { PACKAGE_PIN Y30 IOSTANDARD LVCMOS18 } [get_ports { FMC1_HPC_LA20_N }];       # Y30  FMC1_HPC_LA20_N
# set_property -dict { PACKAGE_PIN N28 IOSTANDARD LVCMOS18 } [get_ports { hyperram0_dq_io[0] }];       # N28  FMC1_HPC_LA21_P
# set_property -dict { PACKAGE_PIN N29 IOSTANDARD LVCMOS18 } [get_ports { hyperram0_dq_io[3] }];       # N29  FMC1_HPC_LA21_N
# # set_property -dict { PACKAGE_PIN R28 IOSTANDARD LVCMOS18 } [get_ports { FMC1_HPC_LA22_P }];       # R28  FMC1_HPC_LA22_P
# # set_property -dict { PACKAGE_PIN P28 IOSTANDARD LVCMOS18 } [get_ports { FMC1_HPC_LA22_N }];       # P28  FMC1_HPC_LA22_N
# # set_property -dict { PACKAGE_PIN P30 IOSTANDARD LVCMOS18 } [get_ports { FMC1_HPC_LA23_P }];       # P30  FMC1_HPC_LA23_P
# # set_property -dict { PACKAGE_PIN N31 IOSTANDARD LVCMOS18 } [get_ports { FMC1_HPC_LA23_N }];       # N31  FMC1_HPC_LA23_N
# set_property -dict { PACKAGE_PIN R30 IOSTANDARD LVCMOS18 } [get_ports { hyperram0_dq_io[4] }];       # R30  FMC1_HPC_LA24_P
# set_property -dict { PACKAGE_PIN P31 IOSTANDARD LVCMOS18 } [get_ports { hyperram0_dq_io[2] }];       # P31  FMC1_HPC_LA24_N
# # set_property -dict { PACKAGE_PIN K29 IOSTANDARD LVCMOS18 } [get_ports { FMC1_HPC_LA25_P }];       # K29  FMC1_HPC_LA25_P
# # set_property -dict { PACKAGE_PIN K30 IOSTANDARD LVCMOS18 } [get_ports { FMC1_HPC_LA25_N }];       # K30  FMC1_HPC_LA25_N
# # set_property -dict { PACKAGE_PIN J30 IOSTANDARD LVCMOS18 } [get_ports { FMC1_HPC_LA26_P }];       # J30  FMC1_HPC_LA26_P
# # set_property -dict { PACKAGE_PIN H30 IOSTANDARD LVCMOS18 } [get_ports { FMC1_HPC_LA26_N }];       # H30  FMC1_HPC_LA26_N
# # set_property -dict { PACKAGE_PIN J31 IOSTANDARD LVCMOS18 } [get_ports { FMC1_HPC_LA27_P }];       # J31  FMC1_HPC_LA27_P
# # set_property -dict { PACKAGE_PIN H31 IOSTANDARD LVCMOS18 } [get_ports { FMC1_HPC_LA27_N }];       # H31  FMC1_HPC_LA27_N
# set_property -dict { PACKAGE_PIN L29 IOSTANDARD LVCMOS18 } [get_ports { hyperram0_rwds_io }];       # L29  FMC1_HPC_LA28_P
# set_property -dict { PACKAGE_PIN L30 IOSTANDARD LVCMOS18 } [get_ports { hyperram0_cs_n }];       # L30  FMC1_HPC_LA28_N
# # set_property -dict { PACKAGE_PIN T29 IOSTANDARD LVCMOS18 } [get_ports { FMC1_HPC_LA29_P }];       # T29  FMC1_HPC_LA29_P
# # set_property -dict { PACKAGE_PIN T30 IOSTANDARD LVCMOS18 } [get_ports { FMC1_HPC_LA29_N }];       # T30  FMC1_HPC_LA29_N
# set_property -dict { PACKAGE_PIN V30 IOSTANDARD LVCMOS18 } [get_ports { hyperram0_hclk_p }];       # V30  FMC1_HPC_LA30_P
# # set_property -dict { PACKAGE_PIN V31 IOSTANDARD LVCMOS18 } [get_ports { FMC1_HPC_LA30_N }];       # V31  FMC1_HPC_LA30_N
# # set_property -dict { PACKAGE_PIN M28 IOSTANDARD LVCMOS18 } [get_ports { FMC1_HPC_LA31_P }];       # M28  FMC1_HPC_LA31_P
# # set_property -dict { PACKAGE_PIN M29 IOSTANDARD LVCMOS18 } [get_ports { FMC1_HPC_LA31_N }];       # M29  FMC1_HPC_LA31_N
# set_property -dict { PACKAGE_PIN V29 IOSTANDARD LVCMOS18 } [get_ports { hyperram0_resetn }];       # V29  FMC1_HPC_LA32_P
# # set_property -dict { PACKAGE_PIN U29 IOSTANDARD LVCMOS18 } [get_ports { FMC1_HPC_LA32_N }];       # U29  FMC1_HPC_LA32_N
# # set_property -dict { PACKAGE_PIN U31 IOSTANDARD LVCMOS18 } [get_ports { FMC1_HPC_LA33_P }];       # U31  FMC1_HPC_LA33_P
# # set_property -dict { PACKAGE_PIN T31 IOSTANDARD LVCMOS18 } [get_ports { FMC1_HPC_LA33_N }];       # T31  FMC1_HPC_LA33_N
# # set_property -dict { PACKAGE_PIN N30 IOSTANDARD LVCMOS18 } [get_ports { FMC1_HPC_CLK1_M2C_P }];   # N30  FMC1_HPC_CLK1_M2C_P
# # set_property -dict { PACKAGE_PIN M31 IOSTANDARD LVCMOS18 } [get_ports { FMC1_HPC_CLK1_M2C_N }];   # M31  FMC1_HPC_CLK1_M2C_N

# # # --- HA Bank ---
# # set_property -dict { PACKAGE_PIN E34 IOSTANDARD LVCMOS18 } [get_ports { FMC1_HPC_HA00_CC_P }];    # E34  FMC1_HPC_HA00_CC_P
# # set_property -dict { PACKAGE_PIN E35 IOSTANDARD LVCMOS18 } [get_ports { FMC1_HPC_HA00_CC_N }];    # E35  FMC1_HPC_HA00_CC_N
# # set_property -dict { PACKAGE_PIN D35 IOSTANDARD LVCMOS18 } [get_ports { FMC1_HPC_HA01_CC_P }];    # D35  FMC1_HPC_HA01_CC_P
# # set_property -dict { PACKAGE_PIN D36 IOSTANDARD LVCMOS18 } [get_ports { FMC1_HPC_HA01_CC_N }];    # D36  FMC1_HPC_HA01_CC_N
# # set_property -dict { PACKAGE_PIN E33 IOSTANDARD LVCMOS18 } [get_ports { FMC1_HPC_HA02_P }];       # E33  FMC1_HPC_HA02_P
# # set_property -dict { PACKAGE_PIN D33 IOSTANDARD LVCMOS18 } [get_ports { FMC1_HPC_HA02_N }];       # D33  FMC1_HPC_HA02_N
# # set_property -dict { PACKAGE_PIN H33 IOSTANDARD LVCMOS18 } [get_ports { FMC1_HPC_HA03_P }];       # H33  FMC1_HPC_HA03_P
# # set_property -dict { PACKAGE_PIN G33 IOSTANDARD LVCMOS18 } [get_ports { FMC1_HPC_HA03_N }];       # G33  FMC1_HPC_HA03_N
# # set_property -dict { PACKAGE_PIN F34 IOSTANDARD LVCMOS18 } [get_ports { FMC1_HPC_HA04_P }];       # F34  FMC1_HPC_HA04_P
# # set_property -dict { PACKAGE_PIN F35 IOSTANDARD LVCMOS18 } [get_ports { FMC1_HPC_HA04_N }];       # F35  FMC1_HPC_HA04_N
# # set_property -dict { PACKAGE_PIN G32 IOSTANDARD LVCMOS18 } [get_ports { FMC1_HPC_HA05_P }];       # G32  FMC1_HPC_HA05_P
# # set_property -dict { PACKAGE_PIN F32 IOSTANDARD LVCMOS18 } [get_ports { FMC1_HPC_HA05_N }];       # F32  FMC1_HPC_HA05_N
# # set_property -dict { PACKAGE_PIN G36 IOSTANDARD LVCMOS18 } [get_ports { FMC1_HPC_HA06_P }];       # G36  FMC1_HPC_HA06_P
# # set_property -dict { PACKAGE_PIN G37 IOSTANDARD LVCMOS18 } [get_ports { FMC1_HPC_HA06_N }];       # G37  FMC1_HPC_HA06_N
# # set_property -dict { PACKAGE_PIN C38 IOSTANDARD LVCMOS18 } [get_ports { FMC1_HPC_HA07_P }];       # C38  FMC1_HPC_HA07_P
# # set_property -dict { PACKAGE_PIN C39 IOSTANDARD LVCMOS18 } [get_ports { FMC1_HPC_HA07_N }];       # C39  FMC1_HPC_HA07_N
# # set_property -dict { PACKAGE_PIN J36 IOSTANDARD LVCMOS18 } [get_ports { FMC1_HPC_HA08_P }];       # J36  FMC1_HPC_HA08_P
# # set_property -dict { PACKAGE_PIN H36 IOSTANDARD LVCMOS18 } [get_ports { FMC1_HPC_HA08_N }];       # H36  FMC1_HPC_HA08_N
# # set_property -dict { PACKAGE_PIN E32 IOSTANDARD LVCMOS18 } [get_ports { FMC1_HPC_HA09_P }];       # E32  FMC1_HPC_HA09_P
# # set_property -dict { PACKAGE_PIN D32 IOSTANDARD LVCMOS18 } [get_ports { FMC1_HPC_HA09_N }];       # D32  FMC1_HPC_HA09_N
# # set_property -dict { PACKAGE_PIN H38 IOSTANDARD LVCMOS18 } [get_ports { FMC1_HPC_HA10_P }];       # H38  FMC1_HPC_HA10_P
# # set_property -dict { PACKAGE_PIN G38 IOSTANDARD LVCMOS18 } [get_ports { FMC1_HPC_HA10_N }];       # G38  FMC1_HPC_HA10_N
# # set_property -dict { PACKAGE_PIN J37 IOSTANDARD LVCMOS18 } [get_ports { FMC1_HPC_HA11_P }];       # J37  FMC1_HPC_HA11_P
# # set_property -dict { PACKAGE_PIN J38 IOSTANDARD LVCMOS18 } [get_ports { FMC1_HPC_HA11_N }];       # J38  FMC1_HPC_HA11_N
# # set_property -dict { PACKAGE_PIN B37 IOSTANDARD LVCMOS18 } [get_ports { FMC1_HPC_HA12_P }];       # B37  FMC1_HPC_HA12_P
# # set_property -dict { PACKAGE_PIN B38 IOSTANDARD LVCMOS18 } [get_ports { FMC1_HPC_HA12_N }];       # B38  FMC1_HPC_HA12_N
# # set_property -dict { PACKAGE_PIN B36 IOSTANDARD LVCMOS18 } [get_ports { FMC1_HPC_HA13_P }];       # B36  FMC1_HPC_HA13_P
# # set_property -dict { PACKAGE_PIN A37 IOSTANDARD LVCMOS18 } [get_ports { FMC1_HPC_HA13_N }];       # A37  FMC1_HPC_HA13_N
# # set_property -dict { PACKAGE_PIN E37 IOSTANDARD LVCMOS18 } [get_ports { FMC1_HPC_HA14_P }];       # E37  FMC1_HPC_HA14_P
# # set_property -dict { PACKAGE_PIN E38 IOSTANDARD LVCMOS18 } [get_ports { FMC1_HPC_HA14_N }];       # E38  FMC1_HPC_HA14_N
# # set_property -dict { PACKAGE_PIN C33 IOSTANDARD LVCMOS18 } [get_ports { FMC1_HPC_HA15_P }];       # C33  FMC1_HPC_HA15_P
# # set_property -dict { PACKAGE_PIN C34 IOSTANDARD LVCMOS18 } [get_ports { FMC1_HPC_HA15_N }];       # C34  FMC1_HPC_HA15_N
# # set_property -dict { PACKAGE_PIN B39 IOSTANDARD LVCMOS18 } [get_ports { FMC1_HPC_HA16_P }];       # B39  FMC1_HPC_HA16_P
# # set_property -dict { PACKAGE_PIN A39 IOSTANDARD LVCMOS18 } [get_ports { FMC1_HPC_HA16_N }];       # A39  FMC1_HPC_HA16_N
# # set_property -dict { PACKAGE_PIN C35 IOSTANDARD LVCMOS18 } [get_ports { FMC1_HPC_HA17_CC_P }];    # C35  FMC1_HPC_HA17_CC_P
# # set_property -dict { PACKAGE_PIN C36 IOSTANDARD LVCMOS18 } [get_ports { FMC1_HPC_HA17_CC_N }];    # C36  FMC1_HPC_HA17_CC_N
# # set_property -dict { PACKAGE_PIN F39 IOSTANDARD LVCMOS18 } [get_ports { FMC1_HPC_HA18_P }];       # F39  FMC1_HPC_HA18_P
# # set_property -dict { PACKAGE_PIN E39 IOSTANDARD LVCMOS18 } [get_ports { FMC1_HPC_HA18_N }];       # E39  FMC1_HPC_HA18_N
# # set_property -dict { PACKAGE_PIN B32 IOSTANDARD LVCMOS18 } [get_ports { FMC1_HPC_HA19_P }];       # B32  FMC1_HPC_HA19_P
# # set_property -dict { PACKAGE_PIN B33 IOSTANDARD LVCMOS18 } [get_ports { FMC1_HPC_HA19_N }];       # B33  FMC1_HPC_HA19_N
# # set_property -dict { PACKAGE_PIN B34 IOSTANDARD LVCMOS18 } [get_ports { FMC1_HPC_HA20_P }];       # B34  FMC1_HPC_HA20_P
# # set_property -dict { PACKAGE_PIN A34 IOSTANDARD LVCMOS18 } [get_ports { FMC1_HPC_HA20_N }];       # A34  FMC1_HPC_HA20_N
# # set_property -dict { PACKAGE_PIN D37 IOSTANDARD LVCMOS18 } [get_ports { FMC1_HPC_HA21_P }];       # D37  FMC1_HPC_HA21_P
# # set_property -dict { PACKAGE_PIN D38 IOSTANDARD LVCMOS18 } [get_ports { FMC1_HPC_HA21_N }];       # D38  FMC1_HPC_HA21_N
# # set_property -dict { PACKAGE_PIN F36 IOSTANDARD LVCMOS18 } [get_ports { FMC1_HPC_HA22_P }];       # F36  FMC1_HPC_HA22_P
# # set_property -dict { PACKAGE_PIN F37 IOSTANDARD LVCMOS18 } [get_ports { FMC1_HPC_HA22_N }];       # F37  FMC1_HPC_HA22_N
# # set_property -dict { PACKAGE_PIN A35 IOSTANDARD LVCMOS18 } [get_ports { FMC1_HPC_HA23_P }];       # A35  FMC1_HPC_HA23_P
# # set_property -dict { PACKAGE_PIN A36 IOSTANDARD LVCMOS18 } [get_ports { FMC1_HPC_HA23_N }];       # A36  FMC1_HPC_HA23_N

# # # --- HB Bank ---
# # set_property -dict { PACKAGE_PIN J25 IOSTANDARD LVCMOS18 } [get_ports { FMC1_HPC_HB00_CC_P }];    # J25  FMC1_HPC_HB00_CC_P
# # set_property -dict { PACKAGE_PIN J26 IOSTANDARD LVCMOS18 } [get_ports { FMC1_HPC_HB00_CC_N }];    # J26  FMC1_HPC_HB00_CC_N
# # set_property -dict { PACKAGE_PIN H28 IOSTANDARD LVCMOS18 } [get_ports { FMC1_HPC_HB01_P }];       # H28  FMC1_HPC_HB01_P
# # set_property -dict { PACKAGE_PIN H29 IOSTANDARD LVCMOS18 } [get_ports { FMC1_HPC_HB01_N }];       # H29  FMC1_HPC_HB01_N
# # set_property -dict { PACKAGE_PIN K28 IOSTANDARD LVCMOS18 } [get_ports { FMC1_HPC_HB02_P }];       # K28  FMC1_HPC_HB02_P
# # set_property -dict { PACKAGE_PIN J28 IOSTANDARD LVCMOS18 } [get_ports { FMC1_HPC_HB02_N }];       # J28  FMC1_HPC_HB02_N
# # set_property -dict { PACKAGE_PIN G28 IOSTANDARD LVCMOS18 } [get_ports { FMC1_HPC_HB03_P }];       # G28  FMC1_HPC_HB03_P
# # set_property -dict { PACKAGE_PIN G29 IOSTANDARD LVCMOS18 } [get_ports { FMC1_HPC_HB03_N }];       # G29  FMC1_HPC_HB03_N
# # set_property -dict { PACKAGE_PIN H24 IOSTANDARD LVCMOS18 } [get_ports { FMC1_HPC_HB04_P }];       # H24  FMC1_HPC_HB04_P
# # set_property -dict { PACKAGE_PIN G24 IOSTANDARD LVCMOS18 } [get_ports { FMC1_HPC_HB04_N }];       # G24  FMC1_HPC_HB04_N
# # set_property -dict { PACKAGE_PIN K27 IOSTANDARD LVCMOS18 } [get_ports { FMC1_HPC_HB05_P }];       # K27  FMC1_HPC_HB05_P
# # set_property -dict { PACKAGE_PIN J27 IOSTANDARD LVCMOS18 } [get_ports { FMC1_HPC_HB05_N }];       # J27  FMC1_HPC_HB05_N
# # set_property -dict { PACKAGE_PIN K23 IOSTANDARD LVCMOS18 } [get_ports { FMC1_HPC_HB06_CC_P }];    # K23  FMC1_HPC_HB06_CC_P
# # set_property -dict { PACKAGE_PIN J23 IOSTANDARD LVCMOS18 } [get_ports { FMC1_HPC_HB06_CC_N }];    # J23  FMC1_HPC_HB06_CC_N
# # set_property -dict { PACKAGE_PIN G26 IOSTANDARD LVCMOS18 } [get_ports { FMC1_HPC_HB07_P }];       # G26  FMC1_HPC_HB07_P
# # set_property -dict { PACKAGE_PIN G27 IOSTANDARD LVCMOS18 } [get_ports { FMC1_HPC_HB07_N }];       # G27  FMC1_HPC_HB07_N
# # set_property -dict { PACKAGE_PIN H25 IOSTANDARD LVCMOS18 } [get_ports { FMC1_HPC_HB08_P }];       # H25  FMC1_HPC_HB08_P
# # set_property -dict { PACKAGE_PIN H26 IOSTANDARD LVCMOS18 } [get_ports { FMC1_HPC_HB08_N }];       # H26  FMC1_HPC_HB08_N
# # set_property -dict { PACKAGE_PIN H23 IOSTANDARD LVCMOS18 } [get_ports { FMC1_HPC_HB09_P }];       # H23  FMC1_HPC_HB09_P
# # set_property -dict { PACKAGE_PIN G23 IOSTANDARD LVCMOS18 } [get_ports { FMC1_HPC_HB09_N }];       # G23  FMC1_HPC_HB09_N
# # set_property -dict { PACKAGE_PIN M22 IOSTANDARD LVCMOS18 } [get_ports { FMC1_HPC_HB10_P }];       # M22  FMC1_HPC_HB10_P
# # set_property -dict { PACKAGE_PIN L22 IOSTANDARD LVCMOS18 } [get_ports { FMC1_HPC_HB10_N }];       # L22  FMC1_HPC_HB10_N
# # set_property -dict { PACKAGE_PIN K22 IOSTANDARD LVCMOS18 } [get_ports { FMC1_HPC_HB11_P }];       # K22  FMC1_HPC_HB11_P
# # set_property -dict { PACKAGE_PIN J22 IOSTANDARD LVCMOS18 } [get_ports { FMC1_HPC_HB11_N }];       # J22  FMC1_HPC_HB11_N
# # set_property -dict { PACKAGE_PIN K24 IOSTANDARD LVCMOS18 } [get_ports { FMC1_HPC_HB12_P }];       # K24  FMC1_HPC_HB12_P
# # set_property -dict { PACKAGE_PIN K25 IOSTANDARD LVCMOS18 } [get_ports { FMC1_HPC_HB12_N }];       # K25  FMC1_HPC_HB12_N
# # set_property -dict { PACKAGE_PIN P25 IOSTANDARD LVCMOS18 } [get_ports { FMC1_HPC_HB13_P }];       # P25  FMC1_HPC_HB13_P
# # set_property -dict { PACKAGE_PIN P26 IOSTANDARD LVCMOS18 } [get_ports { FMC1_HPC_HB13_N }];       # P26  FMC1_HPC_HB13_N
# # set_property -dict { PACKAGE_PIN J21 IOSTANDARD LVCMOS18 } [get_ports { FMC1_HPC_HB14_P }];       # J21  FMC1_HPC_HB14_P
# # set_property -dict { PACKAGE_PIN H21 IOSTANDARD LVCMOS18 } [get_ports { FMC1_HPC_HB14_N }];       # H21  FMC1_HPC_HB14_N
# # set_property -dict { PACKAGE_PIN M21 IOSTANDARD LVCMOS18 } [get_ports { FMC1_HPC_HB15_P }];       # M21  FMC1_HPC_HB15_P
# # set_property -dict { PACKAGE_PIN L21 IOSTANDARD LVCMOS18 } [get_ports { FMC1_HPC_HB15_N }];       # L21  FMC1_HPC_HB15_N
# # set_property -dict { PACKAGE_PIN N25 IOSTANDARD LVCMOS18 } [get_ports { FMC1_HPC_HB16_P }];       # N25  FMC1_HPC_HB16_P
# # set_property -dict { PACKAGE_PIN N26 IOSTANDARD LVCMOS18 } [get_ports { FMC1_HPC_HB16_N }];       # N26  FMC1_HPC_HB16_N
# # set_property -dict { PACKAGE_PIN M24 IOSTANDARD LVCMOS18 } [get_ports { FMC1_HPC_HB17_CC_P }];    # M24  FMC1_HPC_HB17_CC_P
# # set_property -dict { PACKAGE_PIN L24 IOSTANDARD LVCMOS18 } [get_ports { FMC1_HPC_HB17_CC_N }];    # L24  FMC1_HPC_HB17_CC_N
# # set_property -dict { PACKAGE_PIN G21 IOSTANDARD LVCMOS18 } [get_ports { FMC1_HPC_HB18_P }];       # G21  FMC1_HPC_HB18_P
# # set_property -dict { PACKAGE_PIN G22 IOSTANDARD LVCMOS18 } [get_ports { FMC1_HPC_HB18_N }];       # G22  FMC1_HPC_HB18_N
# # set_property -dict { PACKAGE_PIN L25 IOSTANDARD LVCMOS18 } [get_ports { FMC1_HPC_HB19_P }];       # L25  FMC1_HPC_HB19_P
# # set_property -dict { PACKAGE_PIN L26 IOSTANDARD LVCMOS18 } [get_ports { FMC1_HPC_HB19_N }];       # L26  FMC1_HPC_HB19_N
# # set_property -dict { PACKAGE_PIN P21 IOSTANDARD LVCMOS18 } [get_ports { FMC1_HPC_HB20_P }];       # P21  FMC1_HPC_HB20_P
# # set_property -dict { PACKAGE_PIN N21 IOSTANDARD LVCMOS18 } [get_ports { FMC1_HPC_HB20_N }];       # N21  FMC1_HPC_HB20_N
# # set_property -dict { PACKAGE_PIN P22 IOSTANDARD LVCMOS18 } [get_ports { FMC1_HPC_HB21_P }];       # P22  FMC1_HPC_HB21_P
# # set_property -dict { PACKAGE_PIN P23 IOSTANDARD LVCMOS18 } [get_ports { FMC1_HPC_HB21_N }];       # P23  FMC1_HPC_HB21_N

# ##############################################################
# ############################ FMC1 ############################
# ##############################################################

# # set_property PACKAGE_PIN H40 [get_ports FMC1_HPC_LA04_P]
# # set_property IOSTANDARD LVCMOS18 [get_ports FMC1_HPC_LA04_P]
# # set_property PACKAGE_PIN H41 [get_ports FMC1_HPC_LA04_N]
# # set_property IOSTANDARD LVCMOS18 [get_ports FMC1_HPC_LA04_N]
# # set_property PACKAGE_PIN H39 [get_ports FMC1_HPC_LA13_P]
# # set_property IOSTANDARD LVCMOS18 [get_ports FMC1_HPC_LA13_P]
# # set_property PACKAGE_PIN G39 [get_ports FMC1_HPC_LA13_N]
# # set_property IOSTANDARD LVCMOS18 [get_ports FMC1_HPC_LA13_N]
# # set_property PACKAGE_PIN G41 [get_ports FMC1_HPC_LA07_P]
# # set_property IOSTANDARD LVCMOS18 [get_ports FMC1_HPC_LA07_P]
# # set_property PACKAGE_PIN G42 [get_ports FMC1_HPC_LA07_N]
# # set_property IOSTANDARD LVCMOS18 [get_ports FMC1_HPC_LA07_N]
# # set_property PACKAGE_PIN F40 [get_ports FMC1_HPC_LA11_P]
# # set_property IOSTANDARD LVCMOS18 [get_ports FMC1_HPC_LA11_P]
# # set_property PACKAGE_PIN F41 [get_ports FMC1_HPC_LA11_N]
# # set_property IOSTANDARD LVCMOS18 [get_ports FMC1_HPC_LA11_N]
# # set_property PACKAGE_PIN J40 [get_ports FMC1_HPC_LA01_CC_P]
# # set_property IOSTANDARD LVCMOS18 [get_ports FMC1_HPC_LA01_CC_P]
# # set_property PACKAGE_PIN J41 [get_ports FMC1_HPC_LA01_CC_N]
# # set_property IOSTANDARD LVCMOS18 [get_ports FMC1_HPC_LA01_CC_N]
# # set_property PACKAGE_PIN K39 [get_ports FMC1_HPC_LA00_CC_P]
# # set_property IOSTANDARD LVCMOS18 [get_ports FMC1_HPC_LA00_CC_P]
# # set_property PACKAGE_PIN K40 [get_ports FMC1_HPC_LA00_CC_N]
# # set_property IOSTANDARD LVCMOS18 [get_ports FMC1_HPC_LA00_CC_N]
# # set_property PACKAGE_PIN L39 [get_ports FMC1_HPC_CLK0_M2C_P]
# # set_property IOSTANDARD LVCMOS18 [get_ports FMC1_HPC_CLK0_M2C_P]
# # set_property PACKAGE_PIN L40 [get_ports FMC1_HPC_CLK0_M2C_N]
# # set_property IOSTANDARD LVCMOS18 [get_ports FMC1_HPC_CLK0_M2C_N]
# # set_property PACKAGE_PIN M41 [get_ports FMC1_HPC_LA05_P]
# # set_property IOSTANDARD LVCMOS18 [get_ports FMC1_HPC_LA05_P]
# # set_property PACKAGE_PIN L41 [get_ports FMC1_HPC_LA05_N]
# # set_property IOSTANDARD LVCMOS18 [get_ports FMC1_HPC_LA05_N]
# # set_property PACKAGE_PIN K42 [get_ports FMC1_HPC_LA06_P]
# # set_property IOSTANDARD LVCMOS18 [get_ports FMC1_HPC_LA06_P]
# # set_property PACKAGE_PIN J42 [get_ports FMC1_HPC_LA06_N]
# # set_property IOSTANDARD LVCMOS18 [get_ports FMC1_HPC_LA06_N]
# # set_property PACKAGE_PIN M42 [get_ports FMC1_HPC_LA03_P]
# # set_property IOSTANDARD LVCMOS18 [get_ports FMC1_HPC_LA03_P]
# # set_property PACKAGE_PIN L42 [get_ports FMC1_HPC_LA03_N]
# # set_property IOSTANDARD LVCMOS18 [get_ports FMC1_HPC_LA03_N]
# # set_property PACKAGE_PIN K37 [get_ports FMC1_HPC_LA16_P]
# # set_property IOSTANDARD LVCMOS18 [get_ports FMC1_HPC_LA16_P]
# # set_property PACKAGE_PIN K38 [get_ports FMC1_HPC_LA16_N]
# # set_property IOSTANDARD LVCMOS18 [get_ports FMC1_HPC_LA16_N]
# # set_property PACKAGE_PIN M36 [get_ports FMC1_HPC_LA15_P]
# # set_property IOSTANDARD LVCMOS18 [get_ports FMC1_HPC_LA15_P]
# # set_property PACKAGE_PIN L37 [get_ports FMC1_HPC_LA15_N]
# # set_property IOSTANDARD LVCMOS18 [get_ports FMC1_HPC_LA15_N]
# # set_property PACKAGE_PIN P41 [get_ports FMC1_HPC_LA02_P]
# # set_property IOSTANDARD LVCMOS18 [get_ports FMC1_HPC_LA02_P]
# # set_property PACKAGE_PIN N41 [get_ports FMC1_HPC_LA02_N]
# # set_property IOSTANDARD LVCMOS18 [get_ports FMC1_HPC_LA02_N]
# # set_property PACKAGE_PIN M37 [get_ports FMC1_HPC_LA08_P]
# # set_property IOSTANDARD LVCMOS18 [get_ports FMC1_HPC_LA08_P]
# # set_property PACKAGE_PIN M38 [get_ports FMC1_HPC_LA08_N]
# # set_property IOSTANDARD LVCMOS18 [get_ports FMC1_HPC_LA08_N]
# # set_property PACKAGE_PIN R42 [get_ports FMC1_HPC_LA09_P]
# # set_property IOSTANDARD LVCMOS18 [get_ports FMC1_HPC_LA09_P]
# # set_property PACKAGE_PIN P42 [get_ports FMC1_HPC_LA09_N]
# # set_property IOSTANDARD LVCMOS18 [get_ports FMC1_HPC_LA09_N]
# # set_property PACKAGE_PIN N38 [get_ports FMC1_HPC_LA10_P]
# # set_property IOSTANDARD LVCMOS18 [get_ports FMC1_HPC_LA10_P]
# # set_property PACKAGE_PIN M39 [get_ports FMC1_HPC_LA10_N]
# # set_property IOSTANDARD LVCMOS18 [get_ports FMC1_HPC_LA10_N]
# # set_property PACKAGE_PIN R40 [get_ports FMC1_HPC_LA12_P]
# # set_property IOSTANDARD LVCMOS18 [get_ports FMC1_HPC_LA12_P]
# # set_property PACKAGE_PIN P40 [get_ports FMC1_HPC_LA12_N]
# # set_property IOSTANDARD LVCMOS18 [get_ports FMC1_HPC_LA12_N]
# # set_property PACKAGE_PIN N39 [get_ports FMC1_HPC_LA14_P]
# # set_property IOSTANDARD LVCMOS18 [get_ports FMC1_HPC_LA14_P]
# # set_property PACKAGE_PIN N40 [get_ports FMC1_HPC_LA14_N]
# # set_property IOSTANDARD LVCMOS18 [get_ports FMC1_HPC_LA14_N]
# # #NET  VRP_19                    LOC = N36  | IOSTANDARD=LVCMOS18; # Bank  19 VCCO - VADJ_FPGA - IO_25_VRP_19
# # #NET  VRN_33                    LOC = AL24 | IOSTANDARD=LVCMOS18; # Bank  33 VCCO - VCC1V8_FPGA - IO_0_VRN_33
# # set_property PACKAGE_PIN K29 [get_ports FMC1_HPC_LA25_P]
# # set_property IOSTANDARD LVCMOS18 [get_ports FMC1_HPC_LA25_P]
# # set_property PACKAGE_PIN K30 [get_ports FMC1_HPC_LA25_N]
# # set_property IOSTANDARD LVCMOS18 [get_ports FMC1_HPC_LA25_N]
# # set_property PACKAGE_PIN J30 [get_ports FMC1_HPC_LA26_P]
# # set_property IOSTANDARD LVCMOS18 [get_ports FMC1_HPC_LA26_P]
# # set_property PACKAGE_PIN H30 [get_ports FMC1_HPC_LA26_N]
# # set_property IOSTANDARD LVCMOS18 [get_ports FMC1_HPC_LA26_N]
# # set_property PACKAGE_PIN L29 [get_ports FMC1_HPC_LA28_P]
# # set_property IOSTANDARD LVCMOS18 [get_ports FMC1_HPC_LA28_P]
# # set_property PACKAGE_PIN L30 [get_ports FMC1_HPC_LA28_N]
# # set_property IOSTANDARD LVCMOS18 [get_ports FMC1_HPC_LA28_N]
# # set_property PACKAGE_PIN J31 [get_ports FMC1_HPC_LA27_P]
# # set_property IOSTANDARD LVCMOS18 [get_ports FMC1_HPC_LA27_P]
# # set_property PACKAGE_PIN H31 [get_ports FMC1_HPC_LA27_N]
# # set_property IOSTANDARD LVCMOS18 [get_ports FMC1_HPC_LA27_N]
# # set_property PACKAGE_PIN M32 [get_ports FMC1_HPC_LA18_CC_P]
# # set_property IOSTANDARD LVCMOS18 [get_ports FMC1_HPC_LA18_CC_P]
# # set_property PACKAGE_PIN L32 [get_ports FMC1_HPC_LA18_CC_N]
# # set_property IOSTANDARD LVCMOS18 [get_ports FMC1_HPC_LA18_CC_N]
# # set_property PACKAGE_PIN L31 [get_ports FMC1_HPC_LA17_CC_P]
# # set_property IOSTANDARD LVCMOS18 [get_ports FMC1_HPC_LA17_CC_P]
# # set_property PACKAGE_PIN K32 [get_ports FMC1_HPC_LA17_CC_N]
# # set_property IOSTANDARD LVCMOS18 [get_ports FMC1_HPC_LA17_CC_N]
# # set_property PACKAGE_PIN N30 [get_ports FMC1_HPC_CLK1_M2C_P]
# # set_property IOSTANDARD LVCMOS18 [get_ports FMC1_HPC_CLK1_M2C_P]
# # set_property PACKAGE_PIN M31 [get_ports FMC1_HPC_CLK1_M2C_N]
# # set_property IOSTANDARD LVCMOS18 [get_ports FMC1_HPC_CLK1_M2C_N]
# # set_property PACKAGE_PIN P30 [get_ports FMC1_HPC_LA23_P]
# # set_property IOSTANDARD LVCMOS18 [get_ports FMC1_HPC_LA23_P]
# # set_property PACKAGE_PIN N31 [get_ports FMC1_HPC_LA23_N]
# # set_property IOSTANDARD LVCMOS18 [get_ports FMC1_HPC_LA23_N]
# # set_property PACKAGE_PIN M28 [get_ports FMC1_HPC_LA31_P]
# # set_property IOSTANDARD LVCMOS18 [get_ports FMC1_HPC_LA31_P]
# # set_property PACKAGE_PIN M29 [get_ports FMC1_HPC_LA31_N]
# # set_property IOSTANDARD LVCMOS18 [get_ports FMC1_HPC_LA31_N]
# # set_property PACKAGE_PIN R28 [get_ports FMC1_HPC_LA22_P]
# # set_property IOSTANDARD LVCMOS18 [get_ports FMC1_HPC_LA22_P]
# # set_property PACKAGE_PIN P28 [get_ports FMC1_HPC_LA22_N]
# # set_property IOSTANDARD LVCMOS18 [get_ports FMC1_HPC_LA22_N]
# # set_property PACKAGE_PIN N28 [get_ports FMC1_HPC_LA21_P]
# # set_property IOSTANDARD LVCMOS18 [get_ports FMC1_HPC_LA21_P]
# # set_property PACKAGE_PIN N29 [get_ports FMC1_HPC_LA21_N]
# # set_property IOSTANDARD LVCMOS18 [get_ports FMC1_HPC_LA21_N]
# # set_property PACKAGE_PIN R30 [get_ports FMC1_HPC_LA24_P]
# # set_property IOSTANDARD LVCMOS18 [get_ports FMC1_HPC_LA24_P]
# # set_property PACKAGE_PIN P31 [get_ports FMC1_HPC_LA24_N]
# # set_property IOSTANDARD LVCMOS18 [get_ports FMC1_HPC_LA24_N]
# # set_property PACKAGE_PIN U31 [get_ports FMC1_HPC_LA33_P]
# # set_property IOSTANDARD LVCMOS18 [get_ports FMC1_HPC_LA33_P]
# # set_property PACKAGE_PIN T31 [get_ports FMC1_HPC_LA33_N]
# # set_property IOSTANDARD LVCMOS18 [get_ports FMC1_HPC_LA33_N]
# # set_property PACKAGE_PIN V30 [get_ports FMC1_HPC_LA30_P]
# # set_property IOSTANDARD LVCMOS18 [get_ports FMC1_HPC_LA30_P]
# # set_property PACKAGE_PIN V31 [get_ports FMC1_HPC_LA30_N]
# # set_property IOSTANDARD LVCMOS18 [get_ports FMC1_HPC_LA30_N]
# # set_property PACKAGE_PIN T29 [get_ports FMC1_HPC_LA29_P]
# # set_property IOSTANDARD LVCMOS18 [get_ports FMC1_HPC_LA29_P]
# # set_property PACKAGE_PIN T30 [get_ports FMC1_HPC_LA29_N]
# # set_property IOSTANDARD LVCMOS18 [get_ports FMC1_HPC_LA29_N]
# # set_property PACKAGE_PIN W30 [get_ports FMC1_HPC_LA19_P]
# # set_property IOSTANDARD LVCMOS18 [get_ports FMC1_HPC_LA19_P]
# # set_property PACKAGE_PIN W31 [get_ports FMC1_HPC_LA19_N]
# # set_property IOSTANDARD LVCMOS18 [get_ports FMC1_HPC_LA19_N]
# # set_property PACKAGE_PIN V29 [get_ports FMC1_HPC_LA32_P]
# # set_property IOSTANDARD LVCMOS18 [get_ports FMC1_HPC_LA32_P]
# # set_property PACKAGE_PIN U29 [get_ports FMC1_HPC_LA32_N]
# # set_property IOSTANDARD LVCMOS18 [get_ports FMC1_HPC_LA32_N]
# # set_property PACKAGE_PIN Y29 [get_ports FMC1_HPC_LA20_P]
# # set_property IOSTANDARD LVCMOS18 [get_ports FMC1_HPC_LA20_P]
# # set_property PACKAGE_PIN Y30 [get_ports FMC1_HPC_LA20_N]
# # set_property IOSTANDARD LVCMOS18 [get_ports FMC1_HPC_LA20_N]
# # #NET  VRP_34                    LOC = U28  | IOSTANDARD=LVCMOS18; # Bank  34 VCCO - VADJ_FPGA - IO_25_VRP_34
# # #NET  8N545                     LOC = G31  | IOSTANDARD=LVCMOS18; # Bank  35 VCCO - VADJ_FPGA - IO_0_VRN_35
# # set_property PACKAGE_PIN B36 [get_ports FMC1_HPC_HA13_P]
# # set_property IOSTANDARD LVCMOS18 [get_ports FMC1_HPC_HA13_P]
# # set_property PACKAGE_PIN A37 [get_ports FMC1_HPC_HA13_N]
# # set_property IOSTANDARD LVCMOS18 [get_ports FMC1_HPC_HA13_N]
# # set_property PACKAGE_PIN B34 [get_ports FMC1_HPC_HA20_P]
# # set_property IOSTANDARD LVCMOS18 [get_ports FMC1_HPC_HA20_P]
# # set_property PACKAGE_PIN A34 [get_ports FMC1_HPC_HA20_N]
# # set_property IOSTANDARD LVCMOS18 [get_ports FMC1_HPC_HA20_N]
# # set_property PACKAGE_PIN B39 [get_ports FMC1_HPC_HA16_P]
# # set_property IOSTANDARD LVCMOS18 [get_ports FMC1_HPC_HA16_P]
# # set_property PACKAGE_PIN A39 [get_ports FMC1_HPC_HA16_N]
# # set_property IOSTANDARD LVCMOS18 [get_ports FMC1_HPC_HA16_N]
# # set_property PACKAGE_PIN A35 [get_ports FMC1_HPC_HA23_P]
# # set_property IOSTANDARD LVCMOS18 [get_ports FMC1_HPC_HA23_P]
# # set_property PACKAGE_PIN A36 [get_ports FMC1_HPC_HA23_N]
# # set_property IOSTANDARD LVCMOS18 [get_ports FMC1_HPC_HA23_N]
# # set_property PACKAGE_PIN C38 [get_ports FMC1_HPC_HA07_P]
# # set_property IOSTANDARD LVCMOS18 [get_ports FMC1_HPC_HA07_P]
# # set_property PACKAGE_PIN C39 [get_ports FMC1_HPC_HA07_N]
# # set_property IOSTANDARD LVCMOS18 [get_ports FMC1_HPC_HA07_N]
# # set_property PACKAGE_PIN B37 [get_ports FMC1_HPC_HA12_P]
# # set_property IOSTANDARD LVCMOS18 [get_ports FMC1_HPC_HA12_P]
# # set_property PACKAGE_PIN B38 [get_ports FMC1_HPC_HA12_N]
# # set_property IOSTANDARD LVCMOS18 [get_ports FMC1_HPC_HA12_N]
# # set_property PACKAGE_PIN E32 [get_ports FMC1_HPC_HA09_P]
# # set_property IOSTANDARD LVCMOS18 [get_ports FMC1_HPC_HA09_P]
# # set_property PACKAGE_PIN D32 [get_ports FMC1_HPC_HA09_N]
# # set_property IOSTANDARD LVCMOS18 [get_ports FMC1_HPC_HA09_N]
# # set_property PACKAGE_PIN B32 [get_ports FMC1_HPC_HA19_P]
# # set_property IOSTANDARD LVCMOS18 [get_ports FMC1_HPC_HA19_P]
# # set_property PACKAGE_PIN B33 [get_ports FMC1_HPC_HA19_N]
# # set_property IOSTANDARD LVCMOS18 [get_ports FMC1_HPC_HA19_N]
# # set_property PACKAGE_PIN E33 [get_ports FMC1_HPC_HA02_P]
# # set_property IOSTANDARD LVCMOS18 [get_ports FMC1_HPC_HA02_P]
# # set_property PACKAGE_PIN D33 [get_ports FMC1_HPC_HA02_N]
# # set_property IOSTANDARD LVCMOS18 [get_ports FMC1_HPC_HA02_N]
# # set_property PACKAGE_PIN C33 [get_ports FMC1_HPC_HA15_P]
# # set_property IOSTANDARD LVCMOS18 [get_ports FMC1_HPC_HA15_P]
# # set_property PACKAGE_PIN C34 [get_ports FMC1_HPC_HA15_N]
# # set_property IOSTANDARD LVCMOS18 [get_ports FMC1_HPC_HA15_N]
# # set_property PACKAGE_PIN D35 [get_ports FMC1_HPC_HA01_CC_P]
# # set_property IOSTANDARD LVCMOS18 [get_ports FMC1_HPC_HA01_CC_P]
# # set_property PACKAGE_PIN D36 [get_ports FMC1_HPC_HA01_CC_N]
# # set_property IOSTANDARD LVCMOS18 [get_ports FMC1_HPC_HA01_CC_N]
# # set_property PACKAGE_PIN C35 [get_ports FMC1_HPC_HA17_CC_P]
# # set_property IOSTANDARD LVCMOS18 [get_ports FMC1_HPC_HA17_CC_P]
# # set_property PACKAGE_PIN C36 [get_ports FMC1_HPC_HA17_CC_N]
# # set_property IOSTANDARD LVCMOS18 [get_ports FMC1_HPC_HA17_CC_N]
# # set_property PACKAGE_PIN E34 [get_ports FMC1_HPC_HA00_CC_P]
# # set_property IOSTANDARD LVCMOS18 [get_ports FMC1_HPC_HA00_CC_P]
# # set_property PACKAGE_PIN E35 [get_ports FMC1_HPC_HA00_CC_N]
# # set_property IOSTANDARD LVCMOS18 [get_ports FMC1_HPC_HA00_CC_N]
# # set_property PACKAGE_PIN D37 [get_ports FMC1_HPC_HA21_P]
# # set_property IOSTANDARD LVCMOS18 [get_ports FMC1_HPC_HA21_P]
# # set_property PACKAGE_PIN D38 [get_ports FMC1_HPC_HA21_N]
# # set_property IOSTANDARD LVCMOS18 [get_ports FMC1_HPC_HA21_N]
# # set_property PACKAGE_PIN G32 [get_ports FMC1_HPC_HA05_P]
# # set_property IOSTANDARD LVCMOS18 [get_ports FMC1_HPC_HA05_P]
# # set_property PACKAGE_PIN F32 [get_ports FMC1_HPC_HA05_N]
# # set_property IOSTANDARD LVCMOS18 [get_ports FMC1_HPC_HA05_N]
# # set_property PACKAGE_PIN F36 [get_ports FMC1_HPC_HA22_P]
# # set_property IOSTANDARD LVCMOS18 [get_ports FMC1_HPC_HA22_P]
# # set_property PACKAGE_PIN F37 [get_ports FMC1_HPC_HA22_N]
# # set_property IOSTANDARD LVCMOS18 [get_ports FMC1_HPC_HA22_N]
# # set_property PACKAGE_PIN F34 [get_ports FMC1_HPC_HA04_P]
# # set_property IOSTANDARD LVCMOS18 [get_ports FMC1_HPC_HA04_P]
# # set_property PACKAGE_PIN F35 [get_ports FMC1_HPC_HA04_N]
# # set_property IOSTANDARD LVCMOS18 [get_ports FMC1_HPC_HA04_N]
# # set_property PACKAGE_PIN H33 [get_ports FMC1_HPC_HA03_P]
# # set_property IOSTANDARD LVCMOS18 [get_ports FMC1_HPC_HA03_P]
# # set_property PACKAGE_PIN G33 [get_ports FMC1_HPC_HA03_N]
# # set_property IOSTANDARD LVCMOS18 [get_ports FMC1_HPC_HA03_N]
# # set_property PACKAGE_PIN E37 [get_ports FMC1_HPC_HA14_P]
# # set_property IOSTANDARD LVCMOS18 [get_ports FMC1_HPC_HA14_P]
# # set_property PACKAGE_PIN E38 [get_ports FMC1_HPC_HA14_N]
# # set_property IOSTANDARD LVCMOS18 [get_ports FMC1_HPC_HA14_N]
# # set_property PACKAGE_PIN G36 [get_ports FMC1_HPC_HA06_P]
# # set_property IOSTANDARD LVCMOS18 [get_ports FMC1_HPC_HA06_P]
# # set_property PACKAGE_PIN G37 [get_ports FMC1_HPC_HA06_N]
# # set_property IOSTANDARD LVCMOS18 [get_ports FMC1_HPC_HA06_N]
# # set_property PACKAGE_PIN F39 [get_ports FMC1_HPC_HA18_P]
# # set_property IOSTANDARD LVCMOS18 [get_ports FMC1_HPC_HA18_P]
# # set_property PACKAGE_PIN E39 [get_ports FMC1_HPC_HA18_N]
# # set_property IOSTANDARD LVCMOS18 [get_ports FMC1_HPC_HA18_N]
# # set_property PACKAGE_PIN J37 [get_ports FMC1_HPC_HA11_P]
# # set_property IOSTANDARD LVCMOS18 [get_ports FMC1_HPC_HA11_P]
# # set_property PACKAGE_PIN J38 [get_ports FMC1_HPC_HA11_N]
# # set_property IOSTANDARD LVCMOS18 [get_ports FMC1_HPC_HA11_N]
# # set_property PACKAGE_PIN H38 [get_ports FMC1_HPC_HA10_P]
# # set_property IOSTANDARD LVCMOS18 [get_ports FMC1_HPC_HA10_P]
# # set_property PACKAGE_PIN G38 [get_ports FMC1_HPC_HA10_N]
# # set_property IOSTANDARD LVCMOS18 [get_ports FMC1_HPC_HA10_N]
# # set_property PACKAGE_PIN J36 [get_ports FMC1_HPC_HA08_P]
# # set_property IOSTANDARD LVCMOS18 [get_ports FMC1_HPC_HA08_P]
# # set_property PACKAGE_PIN H36 [get_ports FMC1_HPC_HA08_N]
# # set_property IOSTANDARD LVCMOS18 [get_ports FMC1_HPC_HA08_N]
# # #NET  8N546                     LOC = G34  | IOSTANDARD=LVCMOS18; # Bank  35 VCCO - VADJ_FPGA - IO_25_VRP_35
# # #NET  9N472                     LOC = M23  | IOSTANDARD=LVCMOS18; # Bank  36 VCCO - FMC1_VIO_B_M2C - IO_0_VRN_36
# # set_property PACKAGE_PIN H24 [get_ports FMC1_HPC_HB04_P]
# # set_property IOSTANDARD LVCMOS18 [get_ports FMC1_HPC_HB04_P]
# # set_property PACKAGE_PIN G24 [get_ports FMC1_HPC_HB04_N]
# # set_property IOSTANDARD LVCMOS18 [get_ports FMC1_HPC_HB04_N]
# # set_property PACKAGE_PIN J21 [get_ports FMC1_HPC_HB14_P]
# # set_property IOSTANDARD LVCMOS18 [get_ports FMC1_HPC_HB14_P]
# # set_property PACKAGE_PIN H21 [get_ports FMC1_HPC_HB14_N]
# # set_property IOSTANDARD LVCMOS18 [get_ports FMC1_HPC_HB14_N]
# # set_property PACKAGE_PIN H25 [get_ports FMC1_HPC_HB08_P]
# # set_property IOSTANDARD LVCMOS18 [get_ports FMC1_HPC_HB08_P]
# # set_property PACKAGE_PIN H26 [get_ports FMC1_HPC_HB08_N]
# # set_property IOSTANDARD LVCMOS18 [get_ports FMC1_HPC_HB08_N]
# # set_property PACKAGE_PIN G21 [get_ports FMC1_HPC_HB18_P]
# # set_property IOSTANDARD LVCMOS18 [get_ports FMC1_HPC_HB18_P]
# # set_property PACKAGE_PIN G22 [get_ports FMC1_HPC_HB18_N]
# # set_property IOSTANDARD LVCMOS18 [get_ports FMC1_HPC_HB18_N]
# # set_property PACKAGE_PIN G26 [get_ports FMC1_HPC_HB07_P]
# # set_property IOSTANDARD LVCMOS18 [get_ports FMC1_HPC_HB07_P]
# # set_property PACKAGE_PIN G27 [get_ports FMC1_HPC_HB07_N]
# # set_property IOSTANDARD LVCMOS18 [get_ports FMC1_HPC_HB07_N]
# # set_property PACKAGE_PIN H23 [get_ports FMC1_HPC_HB09_P]
# # set_property IOSTANDARD LVCMOS18 [get_ports FMC1_HPC_HB09_P]
# # set_property PACKAGE_PIN G23 [get_ports FMC1_HPC_HB09_N]
# # set_property IOSTANDARD LVCMOS18 [get_ports FMC1_HPC_HB09_N]
# # set_property PACKAGE_PIN G28 [get_ports FMC1_HPC_HB03_P]
# # set_property IOSTANDARD LVCMOS18 [get_ports FMC1_HPC_HB03_P]
# # set_property PACKAGE_PIN G29 [get_ports FMC1_HPC_HB03_N]
# # set_property IOSTANDARD LVCMOS18 [get_ports FMC1_HPC_HB03_N]
# # set_property PACKAGE_PIN K28 [get_ports FMC1_HPC_HB02_P]
# # set_property IOSTANDARD LVCMOS18 [get_ports FMC1_HPC_HB02_P]
# # set_property PACKAGE_PIN J28 [get_ports FMC1_HPC_HB02_N]
# # set_property IOSTANDARD LVCMOS18 [get_ports FMC1_HPC_HB02_N]
# # set_property PACKAGE_PIN H28 [get_ports FMC1_HPC_HB01_P]
# # set_property IOSTANDARD LVCMOS18 [get_ports FMC1_HPC_HB01_P]
# # set_property PACKAGE_PIN H29 [get_ports FMC1_HPC_HB01_N]
# # set_property IOSTANDARD LVCMOS18 [get_ports FMC1_HPC_HB01_N]
# # set_property PACKAGE_PIN K27 [get_ports FMC1_HPC_HB05_P]
# # set_property IOSTANDARD LVCMOS18 [get_ports FMC1_HPC_HB05_P]
# # set_property PACKAGE_PIN J27 [get_ports FMC1_HPC_HB05_N]
# # set_property IOSTANDARD LVCMOS18 [get_ports FMC1_HPC_HB05_N]
# # set_property PACKAGE_PIN K24 [get_ports FMC1_HPC_HB12_P]
# # set_property IOSTANDARD LVCMOS18 [get_ports FMC1_HPC_HB12_P]
# # set_property PACKAGE_PIN K25 [get_ports FMC1_HPC_HB12_N]
# # set_property IOSTANDARD LVCMOS18 [get_ports FMC1_HPC_HB12_N]
# # set_property PACKAGE_PIN J25 [get_ports FMC1_HPC_HB00_CC_P]
# # set_property IOSTANDARD LVCMOS18 [get_ports FMC1_HPC_HB00_CC_P]
# # set_property PACKAGE_PIN J26 [get_ports FMC1_HPC_HB00_CC_N]
# # set_property IOSTANDARD LVCMOS18 [get_ports FMC1_HPC_HB00_CC_N]
# # set_property PACKAGE_PIN M24 [get_ports FMC1_HPC_HB17_CC_P]
# # set_property IOSTANDARD LVCMOS18 [get_ports FMC1_HPC_HB17_CC_P]
# # set_property PACKAGE_PIN L24 [get_ports FMC1_HPC_HB17_CC_N]
# # set_property IOSTANDARD LVCMOS18 [get_ports FMC1_HPC_HB17_CC_N]
# # set_property PACKAGE_PIN K23 [get_ports FMC1_HPC_HB06_CC_P]
# # set_property IOSTANDARD LVCMOS18 [get_ports FMC1_HPC_HB06_CC_P]
# # set_property PACKAGE_PIN J23 [get_ports FMC1_HPC_HB06_CC_N]
# # set_property IOSTANDARD LVCMOS18 [get_ports FMC1_HPC_HB06_CC_N]
# # set_property PACKAGE_PIN M22 [get_ports FMC1_HPC_HB10_P]
# # set_property IOSTANDARD LVCMOS18 [get_ports FMC1_HPC_HB10_P]
# # set_property PACKAGE_PIN L22 [get_ports FMC1_HPC_HB10_N]
# # set_property IOSTANDARD LVCMOS18 [get_ports FMC1_HPC_HB10_N]
# # set_property PACKAGE_PIN L25 [get_ports FMC1_HPC_HB19_P]
# # set_property IOSTANDARD LVCMOS18 [get_ports FMC1_HPC_HB19_P]
# # set_property PACKAGE_PIN L26 [get_ports FMC1_HPC_HB19_N]
# # set_property IOSTANDARD LVCMOS18 [get_ports FMC1_HPC_HB19_N]
# # set_property PACKAGE_PIN K22 [get_ports FMC1_HPC_HB11_P]
# # set_property IOSTANDARD LVCMOS18 [get_ports FMC1_HPC_HB11_P]
# # set_property PACKAGE_PIN J22 [get_ports FMC1_HPC_HB11_N]
# # set_property IOSTANDARD LVCMOS18 [get_ports FMC1_HPC_HB11_N]
# # set_property PACKAGE_PIN M21 [get_ports FMC1_HPC_HB15_P]
# # set_property IOSTANDARD LVCMOS18 [get_ports FMC1_HPC_HB15_P]
# # set_property PACKAGE_PIN L21 [get_ports FMC1_HPC_HB15_N]
# # set_property IOSTANDARD LVCMOS18 [get_ports FMC1_HPC_HB15_N]
# # set_property PACKAGE_PIN P21 [get_ports FMC1_HPC_HB20_P]
# # set_property IOSTANDARD LVCMOS18 [get_ports FMC1_HPC_HB20_P]
# # set_property PACKAGE_PIN N21 [get_ports FMC1_HPC_HB20_N]
# # set_property IOSTANDARD LVCMOS18 [get_ports FMC1_HPC_HB20_N]
# # set_property PACKAGE_PIN P25 [get_ports FMC1_HPC_HB13_P]
# # set_property IOSTANDARD LVCMOS18 [get_ports FMC1_HPC_HB13_P]
# # set_property PACKAGE_PIN P26 [get_ports FMC1_HPC_HB13_N]
# # set_property IOSTANDARD LVCMOS18 [get_ports FMC1_HPC_HB13_N]
# # set_property PACKAGE_PIN P22 [get_ports FMC1_HPC_HB21_P]
# # set_property IOSTANDARD LVCMOS18 [get_ports FMC1_HPC_HB21_P]
# # set_property PACKAGE_PIN P23 [get_ports FMC1_HPC_HB21_N]
# # set_property IOSTANDARD LVCMOS18 [get_ports FMC1_HPC_HB21_N]
# # set_property PACKAGE_PIN N25 [get_ports FMC1_HPC_HB16_P]
# # set_property IOSTANDARD LVCMOS18 [get_ports FMC1_HPC_HB16_P]
# # set_property PACKAGE_PIN N26 [get_ports FMC1_HPC_HB16_N]
# # set_property IOSTANDARD LVCMOS18 [get_ports FMC1_HPC_HB16_N]
# # #NET  9N473                     LOC = N23  | IOSTANDARD=LVCMOS18; # Bank  36 VCCO - FMC1_VIO_B_M2C - IO_L23P_T3_36
# # #NET  9N474                     LOC = N24  | IOSTANDARD=LVCMOS18; # Bank  36 VCCO - FMC1_VIO_B_M2C - IO_L23N_T3_36
# # #NET  9N475                     LOC = M27  | IOSTANDARD=LVCMOS18; # Bank  36 VCCO - FMC1_VIO_B_M2C - IO_L24P_T3_36
# # #NET  9N476                     LOC = L27  | IOSTANDARD=LVCMOS18; # Bank  36 VCCO - FMC1_VIO_B_M2C - IO_L24N_T3_36
# # #NET  9N477                     LOC = M26  | IOSTANDARD=LVCMOS18; # Bank  36 VCCO - FMC1_VIO_B_M2C - IO_25_VRP_36
# # #NET  VRN_37                    LOC = F21  | IOSTANDARD=SSTL15; # Bank  37 VCCO - VCC1V5_FPGA - IO_0_VRN_37

# ###############################################################################################################################

# # set_property PACKAGE_PIN AJ23 [get_ports HDMI_R_D11]
# # set_property IOSTANDARD LVCMOS18 [get_ports HDMI_R_D11]
# # set_property PACKAGE_PIN AK23 [get_ports HDMI_R_D10]
# # set_property IOSTANDARD LVCMOS18 [get_ports HDMI_R_D10]
# # set_property PACKAGE_PIN AK20 [get_ports HDMI_R_D9]
# # set_property IOSTANDARD LVCMOS18 [get_ports HDMI_R_D9]
# # set_property PACKAGE_PIN AL20 [get_ports HDMI_R_D8]
# # set_property IOSTANDARD LVCMOS18 [get_ports HDMI_R_D8]
# # set_property PACKAGE_PIN AJ22 [get_ports HDMI_R_D7]
# # set_property IOSTANDARD LVCMOS18 [get_ports HDMI_R_D7]
# # set_property PACKAGE_PIN AK22 [get_ports HDMI_R_D6]
# # set_property IOSTANDARD LVCMOS18 [get_ports HDMI_R_D6]
# # set_property PACKAGE_PIN AL21 [get_ports HDMI_R_D5]
# # set_property IOSTANDARD LVCMOS18 [get_ports HDMI_R_D5]
# # set_property PACKAGE_PIN AM21 [get_ports HDMI_R_D4]
# # set_property IOSTANDARD LVCMOS18 [get_ports HDMI_R_D4]
# # set_property PACKAGE_PIN AJ21 [get_ports HDMI_R_D3]
# # set_property IOSTANDARD LVCMOS18 [get_ports HDMI_R_D3]
# # set_property PACKAGE_PIN AJ20 [get_ports HDMI_R_D2]
# # set_property IOSTANDARD LVCMOS18 [get_ports HDMI_R_D2]
# # set_property PACKAGE_PIN AL22 [get_ports HDMI_R_D1]
# # set_property IOSTANDARD LVCMOS18 [get_ports HDMI_R_D1]
# # set_property PACKAGE_PIN AM22 [get_ports HDMI_R_D0]
# # set_property IOSTANDARD LVCMOS18 [get_ports HDMI_R_D0]
# # set_property PACKAGE_PIN AM24 [get_ports HDMI_INT]
# # set_property IOSTANDARD LVCMOS18 [get_ports HDMI_INT]
# # set_property PACKAGE_PIN AN24 [get_ports HDMI_R_D17]
# # set_property IOSTANDARD LVCMOS18 [get_ports HDMI_R_D17]
# # set_property PACKAGE_PIN AM23 [get_ports HDMI_R_D16]
# # set_property IOSTANDARD LVCMOS18 [get_ports HDMI_R_D16]
# # set_property PACKAGE_PIN AN23 [get_ports HDMI_R_D15]
# # set_property IOSTANDARD LVCMOS18 [get_ports HDMI_R_D15]
# # set_property PACKAGE_PIN AP23 [get_ports HDMI_R_D14]
# # set_property IOSTANDARD LVCMOS18 [get_ports HDMI_R_D14]
# # set_property PACKAGE_PIN AP22 [get_ports HDMI_R_D13]
# # set_property IOSTANDARD LVCMOS18 [get_ports HDMI_R_D13]
# # set_property PACKAGE_PIN AN21 [get_ports HDMI_R_D12]
# # set_property IOSTANDARD LVCMOS18 [get_ports HDMI_R_D12]
# # set_property PACKAGE_PIN AP21 [get_ports HDMI_R_DE]
# # set_property IOSTANDARD LVCMOS18 [get_ports HDMI_R_DE]
# # set_property PACKAGE_PIN AR23 [get_ports HDMI_R_SPDIF]
# # set_property IOSTANDARD LVCMOS18 [get_ports HDMI_R_SPDIF]
# # set_property PACKAGE_PIN AR22 [get_ports HDMI_SPDIF_OUT_LS]
# # set_property IOSTANDARD LVCMOS18 [get_ports HDMI_SPDIF_OUT_LS]
# # set_property PACKAGE_PIN AT22 [get_ports HDMI_R_VSYNC]
# # set_property IOSTANDARD LVCMOS18 [get_ports HDMI_R_VSYNC]
# # set_property PACKAGE_PIN AU22 [get_ports HDMI_R_HSYNC]
# # set_property IOSTANDARD LVCMOS18 [get_ports HDMI_R_HSYNC]
# # set_property PACKAGE_PIN AU23 [get_ports HDMI_R_CLK]
# # set_property IOSTANDARD LVCMOS18 [get_ports HDMI_R_CLK]
# # set_property PACKAGE_PIN AV23 [get_ports HDMI_R_D35]
# # set_property IOSTANDARD LVCMOS18 [get_ports HDMI_R_D35]
# # set_property PACKAGE_PIN AW23 [get_ports HDMI_R_D34]
# # set_property IOSTANDARD LVCMOS18 [get_ports HDMI_R_D34]
# # set_property PACKAGE_PIN AW22 [get_ports HDMI_R_D33]
# # set_property IOSTANDARD LVCMOS18 [get_ports HDMI_R_D33]
# # set_property PACKAGE_PIN AT21 [get_ports HDMI_R_D32]
# # set_property IOSTANDARD LVCMOS18 [get_ports HDMI_R_D32]
# # set_property PACKAGE_PIN AU21 [get_ports HDMI_R_D31]
# # set_property IOSTANDARD LVCMOS18 [get_ports HDMI_R_D31]
# # set_property PACKAGE_PIN AR24 [get_ports HDMI_R_D30]
# # set_property IOSTANDARD LVCMOS18 [get_ports HDMI_R_D30]
# # set_property PACKAGE_PIN AT24 [get_ports HDMI_R_D29]
# # set_property IOSTANDARD LVCMOS18 [get_ports HDMI_R_D29]
# # set_property PACKAGE_PIN AV21 [get_ports HDMI_R_D28]
# # set_property IOSTANDARD LVCMOS18 [get_ports HDMI_R_D28]
# # set_property PACKAGE_PIN AW21 [get_ports HDMI_R_D27]
# # set_property IOSTANDARD LVCMOS18 [get_ports HDMI_R_D27]
# # set_property PACKAGE_PIN AU24 [get_ports HDMI_R_D26]
# # set_property IOSTANDARD LVCMOS18 [get_ports HDMI_R_D26]
# # set_property PACKAGE_PIN AV24 [get_ports HDMI_R_D25]
# # set_property IOSTANDARD LVCMOS18 [get_ports HDMI_R_D25]
# # set_property PACKAGE_PIN AY23 [get_ports HDMI_R_D24]
# # set_property IOSTANDARD LVCMOS18 [get_ports HDMI_R_D24]
# # set_property PACKAGE_PIN AY22 [get_ports HDMI_R_D23]
# # set_property IOSTANDARD LVCMOS18 [get_ports HDMI_R_D23]
# # set_property PACKAGE_PIN AY25 [get_ports HDMI_R_D22]
# # set_property IOSTANDARD LVCMOS18 [get_ports HDMI_R_D22]
# # set_property PACKAGE_PIN BA25 [get_ports HDMI_R_D21]
# # set_property IOSTANDARD LVCMOS18 [get_ports HDMI_R_D21]
# # set_property PACKAGE_PIN BA22 [get_ports HDMI_R_D20]
# # set_property IOSTANDARD LVCMOS18 [get_ports HDMI_R_D20]
# # set_property PACKAGE_PIN BB22 [get_ports HDMI_R_D19]
# # set_property IOSTANDARD LVCMOS18 [get_ports HDMI_R_D19]
# # set_property PACKAGE_PIN AY24 [get_ports HDMI_R_D18]
# # set_property IOSTANDARD LVCMOS18 [get_ports HDMI_R_D18]
# # #NET  7N1099                    LOC = BA24 | IOSTANDARD=LVCMOS18; # Bank  33 VCCO - VCC1V8_FPGA - IO_L22N_T3_33
# # set_property PACKAGE_PIN BA21 [get_ports XADC_GPIO_0]
# # set_property IOSTANDARD LVCMOS18 [get_ports XADC_GPIO_0]
# # set_property PACKAGE_PIN BB21 [get_ports XADC_GPIO_1]
# # set_property IOSTANDARD LVCMOS18 [get_ports XADC_GPIO_1]
# # set_property PACKAGE_PIN BB24 [get_ports XADC_GPIO_2]
# # set_property IOSTANDARD LVCMOS18 [get_ports XADC_GPIO_2]
# # set_property PACKAGE_PIN BB23 [get_ports XADC_GPIO_3]
# # set_property IOSTANDARD LVCMOS18 [get_ports XADC_GPIO_3]
# # #NET  VRP_33                    LOC = AN20 | IOSTANDARD=LVCMOS18; # Bank  33 VCCO - VCC1V8_FPGA - IO_25_VRP_33
# # #NET  VRN_34                    LOC = R29  | IOSTANDARD=LVCMOS18; # Bank  34 VCCO - VADJ_FPGA - IO_0_VRN_34
# # #NET  8N640                     LOC = K35  | IOSTANDARD=LVCMOS18; # Bank  34 VCCO - VADJ_FPGA - IO_L1P_T0_34
# # #NET  8N641                     LOC = J35  | IOSTANDARD=LVCMOS18; # Bank  34 VCCO - VADJ_FPGA - IO_L1N_T0_34
# # #NET  8N635                     LOC = J32  | IOSTANDARD=LVCMOS18; # Bank  34 VCCO - VADJ_FPGA - IO_L2P_T0_34
# # #NET  8N636                     LOC = J33  | IOSTANDARD=LVCMOS18; # Bank  34 VCCO - VADJ_FPGA - IO_L2N_T0_34
# # #NET  8N637                     LOC = K33  | IOSTANDARD=LVCMOS18; # Bank  34 VCCO - VADJ_FPGA - IO_L3P_T0_DQS_34
# # #NET  8N646                     LOC = K34  | IOSTANDARD=LVCMOS18; # Bank  34 VCCO - VADJ_FPGA - IO_L3N_T0_DQS_34
# # #NET  8N634                     LOC = L34  | IOSTANDARD=LVCMOS18; # Bank  34 VCCO - VADJ_FPGA - IO_L4P_T0_34
# # #NET  8N649                     LOC = L35  | IOSTANDARD=LVCMOS18; # Bank  34 VCCO - VADJ_FPGA - IO_L4N_T0_34
# # #NET  8N648                     LOC = M33  | IOSTANDARD=LVCMOS18; # Bank  34 VCCO - VADJ_FPGA - IO_L5P_T0_34
# # #NET  8N651                     LOC = M34  | IOSTANDARD=LVCMOS18; # Bank  34 VCCO - VADJ_FPGA - IO_L5N_T0_34
# # #NET  8N650                     LOC = H34  | IOSTANDARD=LVCMOS18; # Bank  34 VCCO - VADJ_FPGA - IO_L6P_T0_34
# # #NET  8N652                     LOC = H35  | IOSTANDARD=LVCMOS18; # Bank  34 VCCO - VADJ_FPGA - IO_L6N_T0_VREF_34


# # set_property PACKAGE_PIN A24 [get_ports DDR3_D32]
# # set_property IOSTANDARD SSTL15 [get_ports DDR3_D32]
# # set_property PACKAGE_PIN A25 [get_ports DDR3_D38]
# # set_property IOSTANDARD SSTL15 [get_ports DDR3_D38]
# # set_property PACKAGE_PIN B22 [get_ports DDR3_D37]
# # set_property IOSTANDARD SSTL15 [get_ports DDR3_D37]
# # set_property PACKAGE_PIN A22 [get_ports DDR3_D36]
# # set_property IOSTANDARD SSTL15 [get_ports DDR3_D36]
# # set_property PACKAGE_PIN A26 [get_ports DDR3_DQS4_P]
# # set_property IOSTANDARD DIFF_SSTL15 [get_ports DDR3_DQS4_P]
# # set_property PACKAGE_PIN A27 [get_ports DDR3_DQS4_N]
# # set_property IOSTANDARD DIFF_SSTL15 [get_ports DDR3_DQS4_N]
# # set_property PACKAGE_PIN C23 [get_ports DDR3_DM4]
# # set_property IOSTANDARD SSTL15 [get_ports DDR3_DM4]
# # set_property PACKAGE_PIN B23 [get_ports DDR3_D33]
# # set_property IOSTANDARD SSTL15 [get_ports DDR3_D33]
# # set_property PACKAGE_PIN B26 [get_ports DDR3_D35]
# # set_property IOSTANDARD SSTL15 [get_ports DDR3_D35]
# # set_property PACKAGE_PIN B27 [get_ports DDR3_D34]
# # set_property IOSTANDARD SSTL15 [get_ports DDR3_D34]
# # set_property PACKAGE_PIN C24 [get_ports DDR3_D39]
# # set_property IOSTANDARD SSTL15 [get_ports DDR3_D39]
# # #NET  VTTVREF                   LOC = B24  | IOSTANDARD=SSTL15; # Bank  37 VCCO - VCC1V5_FPGA - IO_L6N_T0_VREF_37
# # set_property PACKAGE_PIN E23 [get_ports DDR3_D44]
# # set_property IOSTANDARD SSTL15 [get_ports DDR3_D44]
# # set_property PACKAGE_PIN E24 [get_ports DDR3_D40]
# # set_property IOSTANDARD SSTL15 [get_ports DDR3_D40]
# # set_property PACKAGE_PIN F22 [get_ports DDR3_D46]
# # set_property IOSTANDARD SSTL15 [get_ports DDR3_D46]
# # set_property PACKAGE_PIN E22 [get_ports DDR3_D47]
# # set_property IOSTANDARD SSTL15 [get_ports DDR3_D47]
# # set_property PACKAGE_PIN F25 [get_ports DDR3_DQS5_P]
# # set_property IOSTANDARD DIFF_SSTL15 [get_ports DDR3_DQS5_P]
# # set_property PACKAGE_PIN E25 [get_ports DDR3_DQS5_N]
# # set_property IOSTANDARD DIFF_SSTL15 [get_ports DDR3_DQS5_N]
# # set_property PACKAGE_PIN D22 [get_ports DDR3_D45]
# # set_property IOSTANDARD SSTL15 [get_ports DDR3_D45]
# # set_property PACKAGE_PIN D23 [get_ports DDR3_D41]
# # set_property IOSTANDARD SSTL15 [get_ports DDR3_D41]
# # set_property PACKAGE_PIN D25 [get_ports DDR3_DM5]
# # set_property IOSTANDARD SSTL15 [get_ports DDR3_DM5]
# # set_property PACKAGE_PIN D26 [get_ports DDR3_D42]
# # set_property IOSTANDARD SSTL15 [get_ports DDR3_D42]
# # set_property PACKAGE_PIN C25 [get_ports DDR3_D43]
# # set_property IOSTANDARD SSTL15 [get_ports DDR3_D43]
# # #NET  9N541                     LOC = C26  | IOSTANDARD=SSTL15; # Bank  37 VCCO - VCC1V5_FPGA - IO_L12N_T1_MRCC_37
# # set_property PACKAGE_PIN D27 [get_ports DDR3_D49]
# # set_property IOSTANDARD SSTL15 [get_ports DDR3_D49]
# # set_property PACKAGE_PIN D28 [get_ports DDR3_D52]
# # set_property IOSTANDARD SSTL15 [get_ports DDR3_D52]
# # set_property PACKAGE_PIN C28 [get_ports DDR3_D51]
# # set_property IOSTANDARD SSTL15 [get_ports DDR3_D51]
# # set_property PACKAGE_PIN C29 [get_ports DDR3_RESET_B]
# # set_property IOSTANDARD LVCMOS15 [get_ports DDR3_RESET_B]
# # set_property PACKAGE_PIN B28 [get_ports DDR3_DQS6_P]
# # set_property IOSTANDARD DIFF_SSTL15 [get_ports DDR3_DQS6_P]
# # set_property PACKAGE_PIN B29 [get_ports DDR3_DQS6_N]
# # set_property IOSTANDARD DIFF_SSTL15 [get_ports DDR3_DQS6_N]
# # set_property PACKAGE_PIN A31 [get_ports DDR3_D54]
# # set_property IOSTANDARD SSTL15 [get_ports DDR3_D54]
# # set_property PACKAGE_PIN A32 [get_ports DDR3_D55]
# # set_property IOSTANDARD SSTL15 [get_ports DDR3_D55]
# # set_property PACKAGE_PIN A29 [get_ports DDR3_D50]
# # set_property IOSTANDARD SSTL15 [get_ports DDR3_D50]
# # set_property PACKAGE_PIN A30 [get_ports DDR3_D48]
# # set_property IOSTANDARD SSTL15 [get_ports DDR3_D48]
# # set_property PACKAGE_PIN C31 [get_ports DDR3_DM6]
# # set_property IOSTANDARD SSTL15 [get_ports DDR3_DM6]
# # set_property PACKAGE_PIN B31 [get_ports DDR3_D53]
# # set_property IOSTANDARD SSTL15 [get_ports DDR3_D53]
# # set_property PACKAGE_PIN E30 [get_ports DDR3_D56]
# # set_property IOSTANDARD SSTL15 [get_ports DDR3_D56]
# # #NET  VTTVREF                   LOC = D31  | IOSTANDARD=SSTL15; # Bank  37 VCCO - VCC1V5_FPGA - IO_L19N_T3_VREF_37
# # set_property PACKAGE_PIN D30 [get_ports DDR3_D63]
# # set_property IOSTANDARD SSTL15 [get_ports DDR3_D63]
# # set_property PACKAGE_PIN C30 [get_ports DDR3_D60]
# # set_property IOSTANDARD SSTL15 [get_ports DDR3_D60]
# # set_property PACKAGE_PIN E27 [get_ports DDR3_DQS7_P]
# # set_property IOSTANDARD DIFF_SSTL15 [get_ports DDR3_DQS7_P]
# # set_property PACKAGE_PIN E28 [get_ports DDR3_DQS7_N]
# # set_property IOSTANDARD DIFF_SSTL15 [get_ports DDR3_DQS7_N]
# # set_property PACKAGE_PIN F29 [get_ports DDR3_D57]
# # set_property IOSTANDARD SSTL15 [get_ports DDR3_D57]
# # set_property PACKAGE_PIN E29 [get_ports DDR3_D61]
# # set_property IOSTANDARD SSTL15 [get_ports DDR3_D61]
# # set_property PACKAGE_PIN F26 [get_ports DDR3_D62]
# # set_property IOSTANDARD SSTL15 [get_ports DDR3_D62]
# # set_property PACKAGE_PIN F27 [get_ports DDR3_D59]
# # set_property IOSTANDARD SSTL15 [get_ports DDR3_D59]
# # set_property PACKAGE_PIN F30 [get_ports DDR3_D58]
# # set_property IOSTANDARD SSTL15 [get_ports DDR3_D58]
# # set_property PACKAGE_PIN F31 [get_ports DDR3_DM7]
# # set_property IOSTANDARD SSTL15 [get_ports DDR3_DM7]
# # #NET  VRP_37                    LOC = F24  | IOSTANDARD=SSTL15; # Bank  37 VCCO - VCC1V5_FPGA - IO_25_VRP_37
# # #NET  VRN_38                    LOC = K18  | IOSTANDARD=SSTL15; # Bank  38 VCCO - VCC1V5_FPGA - IO_0_VRN_38
# # set_property PACKAGE_PIN C19 [get_ports DDR3_A9]
# # set_property IOSTANDARD SSTL15 [get_ports DDR3_A9]
# # set_property PACKAGE_PIN B19 [get_ports DDR3_A1]
# # set_property IOSTANDARD SSTL15 [get_ports DDR3_A1]
# # set_property PACKAGE_PIN A16 [get_ports DDR3_A5]
# # set_property IOSTANDARD SSTL15 [get_ports DDR3_A5]
# # set_property PACKAGE_PIN A15 [get_ports DDR3_A12]
# # set_property IOSTANDARD SSTL15 [get_ports DDR3_A12]
# # set_property PACKAGE_PIN A20 [get_ports DDR3_A0]
# # set_property IOSTANDARD SSTL15 [get_ports DDR3_A0]
# # set_property PACKAGE_PIN A19 [get_ports DDR3_A3]
# # set_property IOSTANDARD SSTL15 [get_ports DDR3_A3]
# # set_property PACKAGE_PIN B17 [get_ports DDR3_A11]
# # set_property IOSTANDARD SSTL15 [get_ports DDR3_A11]
# # set_property PACKAGE_PIN A17 [get_ports DDR3_A4]
# # set_property IOSTANDARD SSTL15 [get_ports DDR3_A4]
# # set_property PACKAGE_PIN B21 [get_ports DDR3_A10]
# # set_property IOSTANDARD SSTL15 [get_ports DDR3_A10]
# # set_property PACKAGE_PIN A21 [get_ports DDR3_A13]
# # set_property IOSTANDARD SSTL15 [get_ports DDR3_A13]
# # set_property PACKAGE_PIN C18 [get_ports DDR3_A7]
# # set_property IOSTANDARD SSTL15 [get_ports DDR3_A7]
# # set_property PACKAGE_PIN B18 [get_ports VTTVREF]
# # set_property IOSTANDARD SSTL15 [get_ports VTTVREF]
# # set_property PACKAGE_PIN D20 [get_ports DDR3_A6]
# # set_property IOSTANDARD SSTL15 [get_ports DDR3_A6]
# # set_property PACKAGE_PIN C20 [get_ports DDR3_A2]
# # set_property IOSTANDARD SSTL15 [get_ports DDR3_A2]
# # set_property PACKAGE_PIN F17 [get_ports DDR3_A14]
# # set_property IOSTANDARD SSTL15 [get_ports DDR3_A14]
# # set_property PACKAGE_PIN E17 [get_ports DDR3_A15]
# # set_property IOSTANDARD SSTL15 [get_ports DDR3_A15]
# # set_property PACKAGE_PIN D21 [get_ports DDR3_BA0]
# # set_property IOSTANDARD SSTL15 [get_ports DDR3_BA0]
# # set_property PACKAGE_PIN C21 [get_ports DDR3_BA1]
# # set_property IOSTANDARD SSTL15 [get_ports DDR3_BA1]
# # set_property PACKAGE_PIN D18 [get_ports DDR3_BA2]
# # set_property IOSTANDARD SSTL15 [get_ports DDR3_BA2]
# # set_property PACKAGE_PIN D17 [get_ports DDR3_A8]
# # set_property IOSTANDARD SSTL15 [get_ports DDR3_A8]
# # set_property PACKAGE_PIN G19 [get_ports DDR3_CLK1_P]
# # set_property IOSTANDARD DIFF_SSTL15 [get_ports DDR3_CLK1_P]
# # set_property PACKAGE_PIN F19 [get_ports DDR3_CLK1_N]
# # set_property IOSTANDARD DIFF_SSTL15 [get_ports DDR3_CLK1_N]

# ####################### CLK PORTS 200MHz ###########################
# set_property -dict { PACKAGE_PIN E19 IOSTANDARD LVDS } [get_ports clk_p];
# set_property -dict { PACKAGE_PIN E18 IOSTANDARD LVDS } [get_ports clk_n];
# create_clock -add -name sys_clk_pin -period 5.00 -waveform {0 2.5} [get_ports clk_p];

# # set_property PACKAGE_PIN E19 [get_ports SYSCLK_P]
# # set_property IOSTANDARD LVDS [get_ports SYSCLK_P]
# # set_property PACKAGE_PIN E18 [get_ports SYSCLK_N]
# # set_property IOSTANDARD LVDS [get_ports SYSCLK_N]



# ###################################################################
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
