Raven1911/ASIC-Oriented-RISC-V-AI-SoC-Platform/Beta_AISoC.srcs/sources_1/imports/sources_1/imports/Uart_axi_lite/fifo_ctrl.v

`timescale 1ns / 1ps
//////////////////////////////////////////////////////////////////////////////////
// Company: 
// Engineer: 
// 
// Create Date: 01/03/2025 02:57:13 PM
// Design Name: 
// Module Name: fifo_ctrl
// Project Name: 
// Target Devices: 
// Tool Versions: 
// Description: 
// 
// Dependencies: 
// 
// Revision:
// Revision 0.01 - File Created
// Additional Comments:
// 
//////////////////////////////////////////////////////////////////////////////////


module fifo_ctrl #(parameter ADDR_WIDTH = 3)(
    input clk, reset_n,
    input wr, rd,

    output reg full, empty,

    output [ADDR_WIDTH - 1 : 0] w_addr,
    output [ADDR_WIDTH - 1 : 0] r_addr
    );

    //variable sequential
    reg [ADDR_WIDTH - 1 : 0] w_ptr, w_ptr_next;
    reg [ADDR_WIDTH - 1 : 0] r_ptr, r_ptr_next;
 
    reg full_next, empty_next;


    // sequential circuit
    always @(posedge clk, negedge reset_n) begin
        if(~reset_n)begin
            w_ptr <= 'b0;
            r_ptr <= 'b0;
            full <= 1'b0;
            empty <= 1'b1;
        end

        else begin
            w_ptr <= w_ptr_next;
            r_ptr <= r_ptr_next;
            full <= full_next;
            empty <= empty_next;
        end

    end

    //combi circuit
    always @(*)begin
        //default
        w_ptr_next = w_ptr;
        r_ptr_next = r_ptr;
        full_next = full;
        empty_next = empty;

        case ({wr, rd})
            2'b01: begin    //read
                if(~empty)begin
                    r_ptr_next = r_ptr + 1;
                    full_next = 1'b0;
                    if(r_ptr_next == w_ptr)begin
                        empty_next = 1'b1;
                    end
                end
            end

            2'b10: begin    //write
                if(~full)begin
                    w_ptr_next = w_ptr + 1;
                    empty_next = 1'b0;
                    if(w_ptr_next == r_ptr)begin
                        full_next = 1'b1;
                    end
                end
            end

            2'b11: begin    //read & write
                if(empty)begin
                    w_ptr_next = w_ptr;
                    r_ptr_next = r_ptr;
                end

                else begin
                    w_ptr_next = w_ptr + 1;
                    r_ptr_next = r_ptr + 1;
                end
            end

            default: ; // 2'b00
        endcase


    end

    //output
    assign w_addr = w_ptr;
    assign r_addr = r_ptr;

endmodule
