Raven1911/ASIC-Oriented-RISC-V-AI-SoC-Platform/Beta_AISoC_Firmware/Beta_AISoC_Firmware/App/Src/allcnn_cifar10_accel.c

#include "allcnn_cifar10_accel.h"

#include <stdint.h>

#include "allcnn_cifar10.h"
#include "CNN_Accel_Driver.h"
#include "flash_utils.h"
#include "HyperRAM_Driver.h"
#include "Interrupt_Driver.h"
#include "timer.h"
#include "UART_Driver.h"
#include "VideoStreaming_Driver.h"
#include "W95_HyperRAM.h"
#include "weight_hyperram_loader.h"

#define ACCEL_SIZE_OPT __attribute__((noinline, optimize("Os,no-tree-loop-distribute-patterns")))

#define ACCEL_CONV1_IN_H              32U
#define ACCEL_CONV1_IN_W              32U
#define ACCEL_CONV1_IN_C              3U
#define ACCEL_CONV1_OUT_H             32U
#define ACCEL_CONV1_OUT_W             32U
#define ACCEL_CONV1_OUT_C             96U
#define ACCEL_CONV1_K                 3U
#define ACCEL_CONV1_STRIDE            1U
#define ACCEL_CONV1_PADDING           1U

#define ACCEL_CONV1_WEIGHT_OFFSET     4U
#define ACCEL_CONV1_WEIGHT_SIZE       2592U
#define ACCEL_CONV1_BIAS_OFFSET       1368484U
#define ACCEL_CONV1_BIAS_SIZE         384U
#define ACCEL_ALLCNN_BLOB_BYTES       1373516U

#define ACCEL_CONV1_IN_ZP             ((int8_t)0)
#define ACCEL_CONV1_WEIGHT_ZP         ((int8_t)0)
#define ACCEL_CONV1_OUT_ZP            ((int8_t)-128)
#define ACCEL_CONV1_MULT              1455152256
#define ACCEL_CONV1_SHIFT             38U
#define ACCEL_CONV1_QMIN              ((int8_t)-128)
#define ACCEL_CONV1_QMAX              ((int8_t)127)

#define ACCEL_VIDEO_IFMAP_SCALE_MULT  714582423
#define ACCEL_VIDEO_IFMAP_SCALE_SHIFT 25U
#define ACCEL_VIDEO_IFMAP_ZP          ((int8_t)0)
#define ACCEL_VIDEO_IFMAP_WARMUP_MS   100U

#define ACCEL_CONV1_VERIFY_OUT_C      ACCEL_CONV1_OUT_C
#define ACCEL_CONV1_VERIFY_OUT_H      ACCEL_CONV1_OUT_H

#define ACCEL_IFPARR                  3U
#define ACCEL_OFPARR                  8U
#define ACCEL_OFTILE                  1U
#define ACCEL_M                       2U
#define ACCEL_MAX_OUT_C               192U
#define ACCEL_FULL_LAYER_COUNT        9U
#define ACCEL_MAX_ROWS_PER_LANE       16U
#define ACCEL_MAX_OFTILE              4U
#define ACCEL_MAX_FILTERS_PER_BURST   32U
#define ACCEL_PACK_BUF_BYTES          512U
#define ACCEL_FULL_GROUP_BUF_BYTES    18432U
#define ACCEL_FULL_FILTER_BUF_BYTES   1728U
#define ACCEL_HRAM_CHUNK_BYTES        256U

#define ACCEL_FULL_HRAM0_PARAM_BASE   0x00180000U
#define ACCEL_HRAM1_IFMAP_BASE        0x00000000U
#define ACCEL_HRAM1_OFMAP_BASE        0x00000C00U
#define ACCEL_HRAM0_FLT_BASE          (ACCEL_FULL_HRAM0_PARAM_BASE + 0x00000000U)
#define ACCEL_HRAM0_BIAS_BASE         (ACCEL_FULL_HRAM0_PARAM_BASE + 0x00000A20U)
#define ACCEL_FULL_FINAL_OFMAP_BASE   0x00057C00U
#define ACCEL_FULL_FINAL_OFMAP_HW     6U
#define ACCEL_FULL_FINAL_OFMAP_C      10U
#define ACCEL_FULL_AVGPOOL_IN_ZP      ((int8_t)-128)
#define ACCEL_FULL_AVGPOOL_OUT_ZP     ((int8_t)-128)
#define ACCEL_FULL_AVGPOOL_MULT       1779742231
#define ACCEL_FULL_AVGPOOL_SHIFT      34U

#define ACCEL_IRQ_WAIT_LIMIT          20000000U
#define ACCEL_SUBMIT_WAIT_LIMIT       10000000U
#define ACCEL_OFBUF_POST_IRQ_DELAY    0U
#define ACCEL_HRAM_DRAIN_WAIT_LIMIT   1000000U
#define ACCEL_HRAM_DRAIN_STABLE_READS 64U
#define ACCEL_DMAC_WRITE_WEIGHT       1U
#define ACCEL_DMAC_READ_WEIGHT        2U
#define ACCEL_LOWER_WRAP_MS           ((uint32_t)(0x100000000ULL / CYCLES_PER_MS))
#define ACCEL_LOWER_WRAP_REM          ((uint32_t)(0x100000000ULL % CYCLES_PER_MS))

#define ACCEL_UART_STREAM_SOF         0xC5U
#define ACCEL_UART_STREAM_EOF         0x5CU
#define ACCEL_UART_STREAM_MAX_PAYLOAD 1024U
#define ACCEL_UART_STREAM_TIMEOUT_MS  5000U
#define ACCEL_UART_STREAM_FRAME_MS    200U
#define ACCEL_UART_STREAM_ACK         0x79U
#define ACCEL_UART_STREAM_NACK        0x1FU
#define ACCEL_UART_STREAM_ERROR       0xEEU
#define ACCEL_UART_STREAM_CMD_INFO    0x01U
#define ACCEL_UART_STREAM_CMD_DATA    0x02U
#define ACCEL_UART_STREAM_CMD_RUN     0x03U
#define ACCEL_UART_STREAM_CMD_END     0x04U
#define ACCEL_UART_STREAM_ERR_LENGTH  0x01U
#define ACCEL_UART_STREAM_ERR_STATE   0x02U
#define ACCEL_UART_STREAM_ERR_CRC     0x03U
#define ACCEL_UART_STREAM_ERR_RUN     0x04U
#define ACCEL_UART_STREAM_ERR_ADDR    0x05U
#define ACCEL_UART_STREAM_IMAGE_BYTES (ACCEL_CONV1_IN_H * ACCEL_CONV1_IN_W * ACCEL_CONV1_IN_C)

typedef struct {
    uint32_t weight_offset;
    uint32_t weight_size;
    uint32_t bias_offset;
    uint32_t bias_size;
} AccelRawParamMeta_t;

typedef struct {
    uint8_t seq;
    uint8_t cmd;
    uint16_t len;
    uint8_t payload[ACCEL_UART_STREAM_MAX_PAYLOAD];
} AccelStreamFrame_t;

typedef struct {
    bool active;
    uint32_t image_index;
    uint32_t expected_crc32;
    uint32_t received_bytes;
    uint8_t expected_label;
} AccelStreamSession_t;

typedef struct {
    uint8_t  ifheight;
    uint16_t ifchannel;
    uint16_t ofchannel;
    uint8_t  hf;
    uint8_t  stride;
    uint8_t  padding;
    uint8_t  ifparr;
    uint8_t  oftile;
    uint8_t  ofparr;
    uint32_t ifbaddr;
    uint32_t fltbaddr;
    uint32_t bias_baddr;
    uint32_t ofbaddr;
    int8_t   ifc_zp;
    int8_t   fltc_zp;
    int32_t  mult;
    uint8_t  mult_shift;
    int8_t   zpy;
    int8_t   qmin;
    int8_t   qmax;
} AccelFullLayer_t;

static const AccelRawParamMeta_t s_full_raw_meta[ACCEL_FULL_LAYER_COUNT] = {
    {       4U,   2592U, 1368484U,  384U },
    {    2596U,  82944U, 1368868U,  384U },
    {   85540U,  82944U, 1369252U,  384U },
    {  168484U, 165888U, 1369636U,  768U },
    {  334372U, 331776U, 1370404U,  768U },
    {  666148U, 331776U, 1371172U,  768U },
    {  997924U, 331776U, 1371940U,  768U },
    { 1329700U,  36864U, 1372708U,  768U },
    { 1366564U,   1920U, 1373476U,   40U },
};

static const AccelFullLayer_t s_full_layers[ACCEL_FULL_LAYER_COUNT] = {
    { 32U,   3U,  96U, 3U, 1U, 1U, 3U, 1U,  8U,      0U,       0U,    2592U,   3072U,     0,    0, 1455152256, 38U, -128, -128, 127 },
    { 32U,  96U,  96U, 3U, 1U, 1U, 3U, 1U,  8U,   3072U,    2976U,   85920U, 101376U,  -128,    0, 1129969408, 40U, -128, -128, 127 },
    { 32U,  96U,  96U, 3U, 2U, 1U, 3U, 1U,  8U, 101376U,   86304U,  169248U, 199680U,  -128,    0, 1793910272, 41U, -128, -128, 127 },
    { 16U,  96U, 192U, 3U, 1U, 1U, 3U, 1U,  8U, 199680U,  169632U,  335520U, 224256U,  -128,    0, 1090411904, 41U, -128, -128, 127 },
    { 16U, 192U, 192U, 3U, 1U, 1U, 3U, 1U,  8U, 224256U,  336288U,  668064U, 273408U,  -128,    0, 1923875712, 40U, -128, -128, 127 },
    { 16U, 192U, 192U, 3U, 2U, 1U, 4U, 1U,  8U, 273408U,  668832U, 1000608U, 322560U,  -128,    0, 1852283136, 40U, -128, -128, 127 },
    {  8U, 192U, 192U, 3U, 1U, 0U, 3U, 1U,  8U, 322560U, 1001376U, 1333152U, 334848U,  -128,    0, 1241329664, 40U, -128, -128, 127 },
    {  6U, 192U, 192U, 1U, 1U, 0U, 2U, 1U, 24U, 334848U, 1333920U, 1370784U, 347136U,  -128,    0, 1540656768, 39U, -128, -128, 127 },
    {  6U, 192U,  10U, 1U, 1U, 0U, 2U, 1U, 10U, 347136U, 1371552U, 1373472U, 359424U,  -128,    0, 1289010560, 39U, -128, -128, 127 },
};

static uint8_t s_conv1_weight[ACCEL_CONV1_WEIGHT_SIZE];
static int32_t s_conv1_bias[ACCEL_CONV1_OUT_C];
static uint8_t s_pack_buf[ACCEL_PACK_BUF_BYTES];
static uint8_t s_readback_buf[ACCEL_PACK_BUF_BYTES];
static uint8_t s_full_group_buf[ACCEL_FULL_GROUP_BUF_BYTES];
static uint8_t s_full_filter_buf[ACCEL_FULL_FILTER_BUF_BYTES];
static uint8_t s_accel_row[ACCEL_CONV1_OUT_W];
static int16_t s_slot_ch[ACCEL_M][ACCEL_MAX_ROWS_PER_LANE][ACCEL_MAX_OFTILE];
static uint8_t s_lane_rows[ACCEL_M];
static int16_t s_lane_seq[ACCEL_M][ACCEL_MAX_OUT_C];
static uint8_t s_lane_seq_used[ACCEL_M][ACCEL_MAX_OUT_C];
static AccelStreamFrame_t s_stream_frame;
static AccelStreamSession_t s_stream_session;
static volatile bool s_accel_irq_seen;
static bool s_conv1_payload_ready;
static bool s_full_payload_ready;
static bool s_conv1_source_params_ready;

static bool cnn_status_has(uint32_t status, uint32_t mask)
{
    return (status & mask) != 0U;
}

static ACCEL_SIZE_OPT void print_cnn_status(const char *prefix, uint32_t status)
{
    Uart_print(prefix);
    Uart_print(" STATUS=0x");
    Uart_print_hex_32(status);
    Uart_print(" table_vld=");
    Uart_write(cnn_status_has(status, CNN_ACCEL_STATUS_TABLE_VALID_Msk) ? '1' : '0');
    Uart_print(" table_rdy=");
    Uart_write(cnn_status_has(status, CNN_ACCEL_STATUS_TABLE_READY_Msk) ? '1' : '0');
    Uart_print(" busy=");
    Uart_write(cnn_status_has(status, CNN_ACCEL_STATUS_BUSY_Msk) ? '1' : '0');
    Uart_print(" done=");
    Uart_write(cnn_status_has(status, CNN_ACCEL_STATUS_DONE_Msk) ? '1' : '0');
    Uart_print(" start=");
    Uart_write(cnn_status_has(status, CNN_ACCEL_STATUS_START_Msk) ? '1' : '0');
    Uart_println("");
}

static ACCEL_SIZE_OPT void print_u32_dec(uint32_t value)
{
    char text[10];
    uint32_t pos = 0U;

    if (value == 0U) {
        Uart_write('0');
        return;
    }

    while ((value > 0U) && (pos < sizeof(text))) {
        text[pos++] = (char)('0' + (value % 10U));
        value /= 10U;
    }

    while (pos > 0U) {
        Uart_write((uint8_t)text[--pos]);
    }
}

static ACCEL_SIZE_OPT void print_i32_dec(int32_t value)
{
    if (value < 0) {
        uint32_t magnitude = (uint32_t)(-(value + 1)) + 1U;
        Uart_write('-');
        print_u32_dec(magnitude);
    } else {
        print_u32_dec((uint32_t)value);
    }
}

static ACCEL_SIZE_OPT tick_t accel_elapsed_ticks(tick_t start, tick_t end)
{
    tick_t diff;

    diff.lower = end.lower - start.lower;
    diff.upper = (end.upper - start.upper) & COUNTER_MAX_UPPER;
    if (end.lower < start.lower) {
        diff.upper = (diff.upper - 1U) & COUNTER_MAX_UPPER;
    }

    return diff;
}

static ACCEL_SIZE_OPT tick_t accel_add_ticks(tick_t a, tick_t b)
{
    tick_t sum;

    sum.lower = a.lower + b.lower;
    sum.upper = (a.upper + b.upper) & COUNTER_MAX_UPPER;
    if (sum.lower < a.lower) {
        sum.upper = (sum.upper + 1U) & COUNTER_MAX_UPPER;
    }

    return sum;
}

static ACCEL_SIZE_OPT uint32_t accel_ticks_to_ms(tick_t ticks)
{
    uint32_t ms = ticks.upper * ACCEL_LOWER_WRAP_MS + ticks.lower / CYCLES_PER_MS;
    uint32_t rem = ticks.upper * ACCEL_LOWER_WRAP_REM + ticks.lower % CYCLES_PER_MS;

    ms += rem / CYCLES_PER_MS;
    return ms;
}

static ACCEL_SIZE_OPT uint8_t accel_tick_cycles_to_decimal_digits(tick_t ticks,
                                                                  uint8_t *digits,
                                                                  uint8_t max_digits)
{
    uint8_t count = 0U;
    uint32_t upper = ticks.upper & COUNTER_MAX_UPPER;
    uint32_t lower = ticks.lower;

    do {
        uint32_t q_upper = upper / 10U;
        uint32_t upper_rem = upper - q_upper * 10U;
        uint32_t q_lower = lower / 10U;
        uint32_t digit = lower - q_lower * 10U;

        for (uint32_t i = 0U; i < upper_rem; i++) {
            q_lower += 429496729U;
            digit += 6U;
            if (digit >= 10U) {
                digit -= 10U;
                q_lower++;
            }
        }

        digits[count++] = (uint8_t)digit;
        upper = q_upper;
        lower = q_lower;
    } while (((upper != 0U) || (lower != 0U)) && (count < max_digits));

    return count;
}

static ACCEL_SIZE_OPT void print_tick_cycles_dec(tick_t ticks)
{
    uint8_t digits[20];
    uint8_t count = accel_tick_cycles_to_decimal_digits(ticks, digits, sizeof(digits));

    while (count > 0U) {
        Uart_write((uint8_t)('0' + digits[--count]));
    }
}

static ACCEL_SIZE_OPT uint32_t accel_ticks_to_u32_saturated(tick_t ticks)
{
    return (ticks.upper != 0U) ? 0xFFFFFFFFU : ticks.lower;
}

static ACCEL_SIZE_OPT void print_cycles_per_unit(tick_t ticks, uint32_t units)
{
    uint32_t cycles;

    if (units == 0U) {
        Uart_print("n/a");
        return;
    }

    if (ticks.upper != 0U) {
        Uart_write('>');
    }
    cycles = accel_ticks_to_u32_saturated(ticks);
    print_u32_dec((cycles + (units >> 1U)) / units);
}

static ACCEL_SIZE_OPT void print_tick_metric(tick_t ticks)
{
    print_tick_cycles_dec(ticks);
    Uart_print(" cycles (");
    print_u32_dec(accel_ticks_to_ms(ticks));
    Uart_print(" ms)");
}

static ACCEL_SIZE_OPT void print_hyperram_mode(const char *name, HyperRAM_Driver_t *drv)
{
    uint32_t mode = HyperRAM_read_mode_register(drv);

    Uart_print("  ");
    Uart_print(name);
    Uart_print(" mode=0x");
    Uart_print_hex_32(mode);
    Uart_print(" accel=");
    print_u32_dec((mode & HYPERRAM_MODE_ACCEL_Msk) != 0U ? 1U : 0U);
    Uart_print(" wr_w=");
    print_u32_dec((mode & HYPERRAM_DMAC_WRITE_WEIGHT_Msk) >> HYPERRAM_DMAC_WRITE_WEIGHT_Pos);
    Uart_print(" rd_w=");
    print_u32_dec((mode & HYPERRAM_DMAC_READ_WEIGHT_Msk) >> HYPERRAM_DMAC_READ_WEIGHT_Pos);
    Uart_println("");
}

static ACCEL_SIZE_OPT void print_hyperram_status(const char *name, HyperRAM_Driver_t *drv)
{
    uint32_t status = *drv->reg_status;

    Uart_print("  ");
    Uart_print(name);
    Uart_print(" status=0x");
    Uart_print_hex_32(status);
    Uart_print(" start_rdy=");
    print_u32_dec((status >> 10) & 1U);
    Uart_print(" empty=");
    print_u32_dec((status >> 9) & 1U);
    Uart_print(" full=");
    print_u32_dec((status >> 8) & 1U);
    Uart_print(" data=0x");
    Uart_print_hex_32(status & 0xFFU);
    Uart_println("");
}

static ACCEL_SIZE_OPT bool wait_hyperram_master_idle(const char *name, HyperRAM_Driver_t *drv)
{
    uint32_t wait = ACCEL_HRAM_DRAIN_WAIT_LIMIT;
    uint32_t stable = 0U;

    while (wait > 0U) {
        if (HyperRAM_is_start_ready(drv)) {
            stable++;
            if (stable >= ACCEL_HRAM_DRAIN_STABLE_READS) {
                return true;
            }
        } else {
            stable = 0U;
        }
        wait--;
    }

    Uart_print("  ");
    Uart_print(name);
    Uart_println(" drain timeout.");
    print_hyperram_status(name, drv);
    return false;
}

static ACCEL_SIZE_OPT bool drain_ofbuf_to_hyperram1(void)
{
    volatile uint32_t delay = ACCEL_OFBUF_POST_IRQ_DELAY;

#if ACCEL_OFBUF_POST_IRQ_DELAY > 0U
    while (delay > 0U) {
        __asm__ volatile("nop");
        delay--;
    }
#else
    (void)delay;
#endif

    return wait_hyperram_master_idle("HR1", &hyperram1);
}

static ACCEL_SIZE_OPT void print_conv1_config(const CNN_Accel_LayerConfig_t *config)
{
    Uart_print("  CFG if=");
    print_u32_dec(config->ifheight);
    Uart_write('x');
    print_u32_dec(config->ifheight);
    Uart_write('x');
    print_u32_dec(config->ifchannel);
    Uart_print(" of=");
    print_u32_dec(config->ofchannel);
    Uart_print(" hf=");
    print_u32_dec(config->hf);
    Uart_print(" stride=");
    print_u32_dec(config->stride);
    Uart_print(" pad=");
    print_u32_dec(config->padding);
    Uart_print(" ifparr=");
    print_u32_dec(config->ifparr);
    Uart_print(" ofparr=");
    print_u32_dec(config->ofparr);
    Uart_print(" oftile=");
    print_u32_dec(config->oftile);
    Uart_println("");

    Uart_print("  ADDR if=0x");
    Uart_print_hex_32(config->ifbaddr);
    Uart_print(" flt=0x");
    Uart_print_hex_32(config->fltbaddr);
    Uart_print(" bias=0x");
    Uart_print_hex_32(config->bias_baddr);
    Uart_print(" of=0x");
    Uart_print_hex_32(config->ofbaddr);
    Uart_println("");
}

static uint32_t ceil_div_u32(uint32_t a, uint32_t b)
{
    return (a + b - 1U) / b;
}

static uint32_t min_u32(uint32_t a, uint32_t b)
{
    return (a < b) ? a : b;
}

static ACCEL_SIZE_OPT bool hram_read_bytes(W95_HandleTypeDef *w95, uint32_t addr, uint8_t *dst, uint32_t size)
{
    uint32_t done = 0U;

    if (((addr | size) & 1U) != 0U) {
        return false;
    }

    while (done < size) {
        uint32_t chunk = size - done;
        if (chunk > ACCEL_HRAM_CHUNK_BYTES) {
            chunk = ACCEL_HRAM_CHUNK_BYTES;
        }
        if ((chunk & 1U) != 0U) {
            return false;
        }
        W95_MemoryRead(w95, addr + done, dst + done, chunk, true);
        done += chunk;
    }

    return true;
}

static ACCEL_SIZE_OPT bool hram_write_bytes(W95_HandleTypeDef *w95, uint32_t addr, const uint8_t *src, uint32_t size)
{
    uint32_t done = 0U;

    if (((addr | size) & 1U) != 0U) {
        return false;
    }

    while (done < size) {
        uint32_t chunk = size - done;
        if (chunk > ACCEL_HRAM_CHUNK_BYTES) {
            chunk = ACCEL_HRAM_CHUNK_BYTES;
        }
        if ((chunk & 1U) != 0U) {
            return false;
        }
        W95_MemoryWrite(w95, addr + done, src + done, chunk, true);
        done += chunk;
    }

    return true;
}

static ACCEL_SIZE_OPT bool hram_read_bytes_unaligned(W95_HandleTypeDef *w95, uint32_t addr, uint8_t *dst, uint32_t size)
{
    uint32_t done = 0U;

    while (done < size) {
        uint32_t chunk = size - done;
        uint32_t aligned_addr;
        uint32_t aligned_end;
        uint32_t aligned_size;
        uint32_t offset;

        if (chunk > (ACCEL_PACK_BUF_BYTES - 2U)) {
            chunk = ACCEL_PACK_BUF_BYTES - 2U;
        }

        aligned_addr = (addr + done) & ~1U;
        aligned_end = (addr + done + chunk + 1U) & ~1U;
        aligned_size = aligned_end - aligned_addr;
        offset = (addr + done) - aligned_addr;

        if (!hram_read_bytes(w95, aligned_addr, s_readback_buf, aligned_size)) {
            return false;
        }
        for (uint32_t i = 0U; i < chunk; i++) {
            dst[done + i] = s_readback_buf[offset + i];
        }
        done += chunk;
    }

    return true;
}

static ACCEL_SIZE_OPT bool read_conv1_source_params(W95_HandleTypeDef *w95_h0_read)
{
    uint32_t blob_size = 0U;

    s_conv1_source_params_ready = false;

    if (!hram_read_bytes(w95_h0_read, 0U, (uint8_t *)&blob_size, sizeof(blob_size))) {
        return false;
    }

    Uart_print("  Weight blob size header: 0x");
    Uart_print_hex_32(blob_size);
    Uart_println("");
    if (blob_size != ACCEL_ALLCNN_BLOB_BYTES) {
        Uart_println("  Warning: weight header.");
        return false;
    }

    if (!hram_read_bytes(w95_h0_read,
                         ACCEL_CONV1_WEIGHT_OFFSET,
                         s_conv1_weight,
                         ACCEL_CONV1_WEIGHT_SIZE)) {
        return false;
    }

    if (!hram_read_bytes(w95_h0_read,
                         ACCEL_CONV1_BIAS_OFFSET,
                         (uint8_t *)s_conv1_bias,
                         ACCEL_CONV1_BIAS_SIZE)) {
        return false;
    }

    s_conv1_source_params_ready = true;
    return true;
}
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
